judapies/Mufla/2021/Mufla 4.5L Psoc MYC Lab #004588559 OP202145/Modelo/EnsambleAislante.png

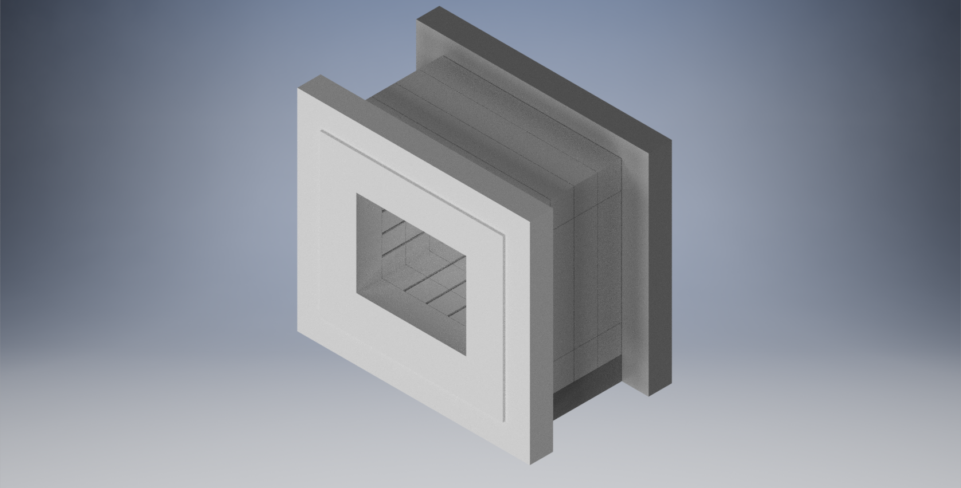
2021/Mufla 4.5L Psoc MYC Lab #004588559 OP202145/Modelo/EnsambleAislante.png
