judapies/Mufla/2020/Mufla 14L Psoc Avantika #004588425 OP2020341/Firmware Psoc V/LCD2/ComponentUpdateLog.txt

Last Modified Date & Time: 11/09/2020 09:13:33

MuflaGLCD: MuflaGLCD.cydwr
	cy_boot [v5.60] to [v6.0]
	LIN_Dynamic [v4.0] to [v5.0]
