judapies/Mufla/2018/Mufla 14L Artilab #004587922/SGC/FJP- 53 RECEPCION E INSPECCION DE PCB.docx

Fecha: | Referencia: | Modelo: | Orden de Pedido:

DESCRIPCIÓN DE LA MEDICIÓN | VALOR ESPERADO | VALOR OBTENIDO | OBSERVACIONES
Largo de PCB
Ancho de PCB
Numero de Capas | 2
*Medición entre pines de Display | Infinito
Medición entre VCC y GND | Infinito
Pin 4 J2 (VF) y Pin 2 U1 | 0 Ω
Pin 2 J10 y Pin 15 U1 | 0 Ω
Pin 2 U3 y Pin 17 U1 | 0 Ω
Pin 2 U2 y Pin 18 U1 | 0 Ω
Pin 1 J12 y Pin 2 J12 | Infinito
Inspección Visual general de la PCB | N/A | N/A

OBSERVACIONES:_________________________________________________________________________________________________________________________________________________________________________________________________________________________________________________________________________________________

- Recuerde realizar las mediciones de acuerdo a la escala de la medida.
- Si fue necesario alguna corrección menciónela en la sección de observaciones y registre los valores medidos separados por un guion (-).

*Realizar la medición entre el pin 1 con todos los demás pines, de igual forma con los siguientes pines.

Realizo: | Revisó: | Aprobó:
Firma: | Firma: | Firma:
Cargo: | Cargo: | Cargo: Dirección Técnica
--------------------------------------------------- | ---------------------------------------------------- | Estado de Calidad: Aprobado:_____ Rechazado:_____

JP BIOINGENIERIA S.A.S RECEPCIÓN E INSPECCIÓN DE PCB(BARE BOARD TEST) FJP – 53 Versión 01 Efectivo a partir de: Marzo 31 de 2018
