judapies/Mufla/2019/Horno Tubular #004587931/SGC/FJP- 53 RECEPCION E INSPECCION DE PCB.docx

Fecha: | Referencia: | Modelo: 2019 | Orden de Pedido: 2018284

DESCRIPCIÓN DE LA MEDICIÓN | VALOR ESPERADO | VALOR OBTENIDO | OBSERVACIONES
Largo de PCB
Ancho de PCB
Numero de Capas | 2
*Medición entre pines de Display | Infinito
Medición entre VCC y GND | Infinito
Pin 1 J2 y Pin 20 J2 | 0 Ω
Pin 3 U3 y Pin 12 U2 | 0 Ω
Pin 2 U3 y Pin 11 U2 | 0 Ω
Pin 3 J7 y Pin 4 J7 | 0 Ω
Pin 1 J7 y Pin 2 J7 | Infinito
Inspección Visual general de la PCB | N/A | N/A

OBSERVACIONES:_________________________________________________________________________________________________________________________________________________________________________________________________________________________________________________________________________________________

- Recuerde realizar las mediciones de acuerdo a la escala de la medida.
- Si fue necesario alguna corrección menciónela en la sección de observaciones y registre los valores medidos separados por un guion (-).

*Realizar la medición entre el pin 1 con todos los demás pines, de igual forma con los siguientes pines.

Realizo: | Revisó: | Aprobó:
Firma: | Firma: | Firma:
Cargo: | Cargo: | Cargo: Dirección Técnica
--------------------------------------------------- | ---------------------------------------------------- | Estado de Calidad: Aprobado:_____ Rechazado:_____

JP BIOINGENIERIA S.A.S RECEPCIÓN E INSPECCIÓN DE PCB(BARE BOARD TEST) FJP – 53 Versión 01 Efectivo a partir de: Marzo 31 de 2018
