judapies/Mufla/2019/Mufla 16L Avantika #004588073 OP2019142/SGC/FJP- 53 RECEPCION E INSPECCION DE PCB.docx

Fecha: | Referencia: JPMN16 | Modelo: 2019 | Orden de Pedido: 2019142

DESCRIPCIÓN DE LA MEDICIÓN | VALOR ESPERADO | VALOR OBTENIDO | OBSERVACIONES
Largo de PCB | 116mm
Ancho de PCB | 75mm
Numero de Capas | 2
*Medición entre pines de Display | Infinito
Medición entre VCC y GND | Infinito
Pin 1 J2 y Pin 20 J2 | 0 Ω
Pin 3 U2 y Pin 12 U2 | Infinito
Pin 2 U2 y Pin 11 U2 | Infinito
Pin 5 J3 y Pin 6 J3 | 0 Ω
Pin 6 J3 y Pin 8 J3 | 0 Ω
Inspección Visual general de la PCB | N/A | N/A

OBSERVACIONES:_________________________________________________________________________________________________________________________________________________________________________________________________________________________________________________________________________________________

- Recuerde realizar las mediciones de acuerdo a la escala de la medida.
- Si fue necesario alguna corrección menciónela en la sección de observaciones y registre los valores medidos separados por un guion (-).

*Realizar la medición entre el pin 1 con todos los demás pines, de igual forma con los siguientes pines.

Realizo: | Revisó: | Aprobó:
Firma: | Firma: | Firma:
Cargo: | Cargo: | Cargo: Dirección Técnica
--------------------------------------------------- | ---------------------------------------------------- | Estado de Calidad: Aprobado:_____ Rechazado:_____

JP BIOINGENIERIA S.A.S RECEPCIÓN E INSPECCIÓN DE PCB(BARE BOARD TEST) FJP – 53 Versión 01 Efectivo a partir de: Marzo 31 de 2018
