judapies/Mufla/2021/Mufla 3L Psoc Artilab #0045886XX OP2021128/Modelo/PiezaPuerta-2.pdf

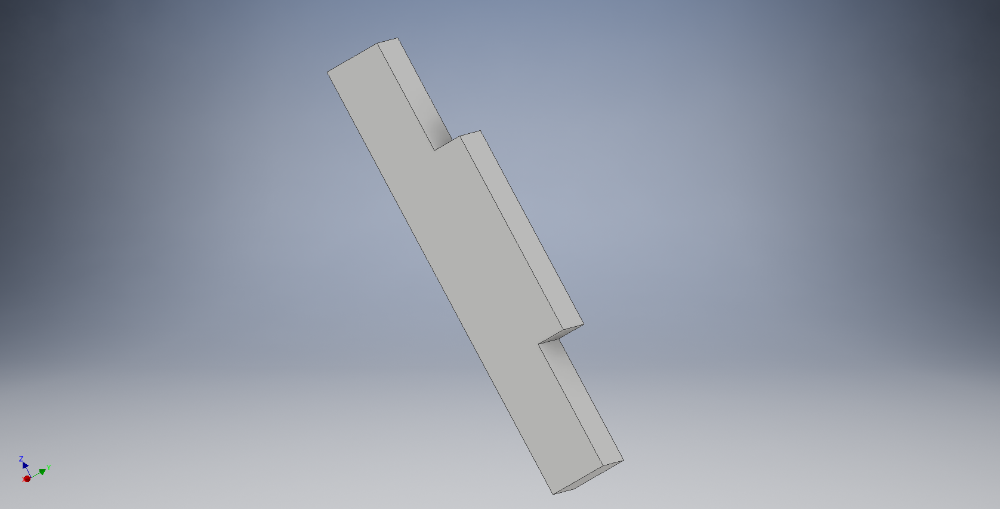
[picture p2: page 1]
