judapies/Mufla/2021/Mufla 3L Psoc Artilab #0045886XX OP2021128/KanthalA1.png

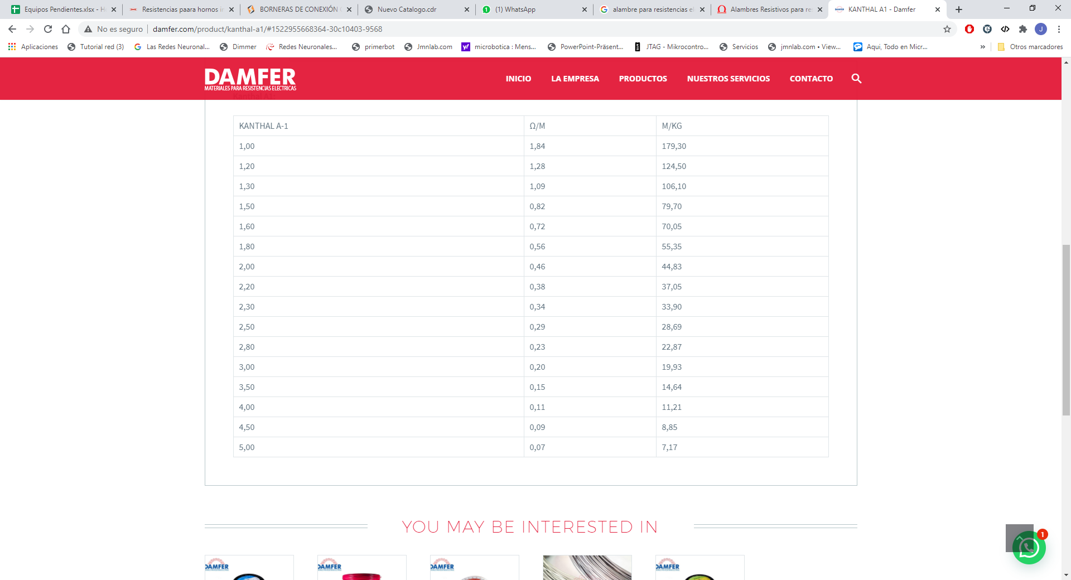
2021/Mufla 3L Psoc Artilab #0045886XX OP2021128/KanthalA1.png
