judapies/Mufla/2021/Mufla 3L Psoc Artilab #0045886XX OP2021128/Parametros/WhatsApp Image 2021-04-19 at 7.22.25 AM.jpeg

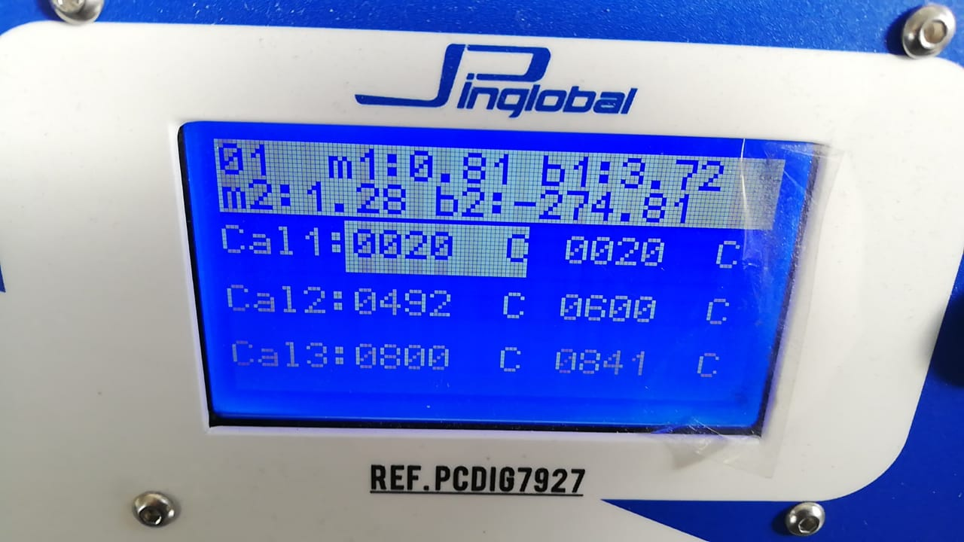
2021/Mufla 3L Psoc Artilab #0045886XX OP2021128/Parametros/WhatsApp Image 2021-04-19 at 7.22.25 AM.jpeg
