judapies/Mufla/2018/Mufla 14L Artilab #004587922/Materiales/Listado de Componentes Mufla.xlsx

Sheet: Parte Electronica 110V
Mufla
Descripción | Referencia | Cantidad | Sitio de Compra | Dirección | Precio | Precio Total
Borneras | 2 Pines Verdes | 7 | Sanyvi Electronics | Cra 9 # 19-30 LOC:212 | $350 | $2450
Conectores GP (con uñas) | 8 Pines | 1 | Sanyvi Electronics | Cra 9 # 19-30 LOC:212 | $400 | $400
 | 4 Pines | 2 | Sanyvi Electronics | Cra 9 # 19-30 LOC:212 | $200 | $400
 | 16 Pines | 2
Regleta Hembra | Para Regleta Macho | 2
Disipador con pines para soldar | Alto para 7805 | 1 | Sanyvi Electronics | Cra 9 # 19-30 LOC:212 | $2000 | $2000
Puente Rectificador | Redondo 1A | 1 | Sanyvi Electronics | Cra 9 # 19-30 LOC:212 | $400 | $400
Regulador de Voltaje | LM7805 | 2 | Sanyvi Electronics | Cra 9 # 19-30 LOC:212 | $550 | $1100
Cristal de Cuarzo | 20MHz | 1 | Sanyvi Electronics | Cra 9 # 19-30 LOC:212 | $450 | $450
Resistencias 1/4W | 10K | 20 | Sanyvi Electronics | Cra 9 # 19-30 LOC:212 | $10 | $200
 | 1K | 20 | Sanyvi Electronics | Cra 9 # 19-30 LOC:212 | $10 | $200
 | 330R | 20 | Sanyvi Electronics | Cra 9 # 19-30 LOC:212 | $10 | $200
Condensador | 470uF/25V | 1 | Sanyvi Electronics | Cra 9 # 19-30 LOC:212 | $250 | $250
 | 10uF/16V | 2 | Sanyvi Electronics | Cra 9 # 19-30 LOC:212 | $150 | $300
 | 0.1uF Monolitico | 2 | Sanyvi Electronics | Cra 9 # 19-30 LOC:212 | $100 | $200
 | 15pF | 2 | Sanyvi Electronics | Cra 9 # 19-30 LOC:212 | $100 | $200
 | 0.1uF Tantalio superficial (CT1206 0.1UF35) | 5 | Sigma Electronica Ltda | Av. Cra 24 No 61D-65 | $406 | $2030
Microcontrolador | PIC 18F4685 | 1 | Sanyvi Electronics | Cra 9 # 19-30 LOC:212 | $15000 | $15000
Regleta Profesional | 40 pines | 2 | Sanyvi Electronics | Cra 9 # 19-30 LOC:212 | $1200 | $2400
Poste plastico | Para sujecion de tarjeta | 4 | Sanyvi Electronics | Cra 9 # 19-30 LOC:212 | $150 | $600
Transistor | 2N3904 | 2 | Sanyvi Electronics | Cra 9 # 19-30 LOC:212 | $200 | $400
Diodo | 1N4004 | 2 | Sanyvi Electronics | Cra 9 # 19-30 LOC:212 | $200 | $400
Zenner | 3,3V | 3
Led | 5mm rojo | 1 | Sanyvi Electronics | Cra 9 # 19-30 LOC:212 | $500 | $500
Fuente Conmutada | RS-15-12, 12V -1,3A | 1 | Sigma Electronica Ltda | Av. Cra 24 No 61D-65

Sheet: Parte Electrica 110V
Cabina Bioseguridad 2B
Descripción | Referencia | Cantidad
Breaker CHINT un polo. 4A | 09606 | 1
Breaker CHINT un polo. 10A | 09610 | 2
Contactor | 00905 | 1
 | 00919 | 1
Cable Encauchetado Centelsa | 3X12 | 5
 | 2X12 | 3
 | 2X18 | 4
Buzzer 110V | 17572 | 1
Riel omega |  | 1
Prensacable PG13.5 | 34113 | 6
Prensacable PG16 | 34116 | 2
Cable Blindado | 6 Hilos X 18AWG | 2
 | 18 Hilos X 18AWG | 2
Termoencogible | 2mm Negro | 2
Regleta Polietileno | 36003 | 1
 | 36030 | 1
Caja de paso | K3131-114 | 1
Clavija Leviton Amarilla | 115V - 15A | 1
Terminal Tipo Bala Hembra | 34636 | 1 bolsa(100)
Terminal Tipo Bala Macho | 34630 | 1 bolsa(100)

Sheet: Hoja1
 | Cabina Flujo Vertical 220V
 | Descripción | Referencia | Cantidad
 | OptoTriac | MOC3021 | 6
 | Triac | BT137 | 2
 |  | BTA-16 | 4
 | Borneras | 2 Pines Verdes | 7
 |  | 3 Pines Verde | 1
 | Conectores GP (con uñas) | 5 Pines | 1
 |  | 16 Pines | 2
 | Puente Rectificador | Redondo 1A | 1
 | Regulador de Voltaje | LM7805 | 1
 | Reostato | 10K | 1
 | Cristal de Cuarzo | 4MHz | 1
 | Resistencias 1/4W | 10K | 6
 |  | 1K | 6
 |  | 330R | 6
 | Condensador | 470uF/25V | 1
 |  | 10uF/16V | 3
 |  | 100nF (104) | 2
 |  | 22pF | 2
 | Display | 4X20 | 1
 | Microcontrolador | PIC 18F4550 | 1
 | Terminales | Según muestra | 8
 | Breaker CHINT 2 polos | 2A | 1
 | Breaker CHINT 1 polo | 10A | 1
 | Interruptor de balancin redondo | 20mm | 1
 | Toma doble blanca | Leviton | 1
 | Tapa de seguridad para toma doble | Plastica gris | 1
 | Regleta de polietileno | 15A | 1
 | Prensacable | PG11 | 4
 | Cable Encauchetado Conalcables | 4X12 | 3m
Ingenieros | Faiver H. Trujillo G | Juan David Piñeros E | 2014- Abr-15
