judapies/Mufla/2018/Mufla 14L Artilab #004587922/SGC/FJP- 35  REQUISICION DE MATERIALES MUFLA.xlsx

JP BIOINGENIERIA S.A.S |  |  | REQUISICION DE MATERIALES |  |  |  |  |  |  |  | FJP - 35
 |  |  |  |  |  |  |  |  |  |  | Version 01
Efectivo a partir de: 20 Dic 2017 |  |  |  |  |  | Documento de origen: DJP- 24 |  |  |  |  | Pág. 1 de 1
FECHA
PRODUCTO: | Mufla 220V 14L |  |  |  |  |  |  | Orden de Pedido No.
 |  |  |  |  |  |  |  | Visita Técnica:
DESCRIPCION |  |  |  |  |  | Referencia |  |  | CANTIDAD REQUERIDA
Tarjeta de control |  |  |  |  |  | DIELEC-MR001 |  |  | 1
Resistencias (1/4W) |  |  |  |  |  | 100Ω |  |  | 2
Resistencias (1/4W) |  |  |  |  |  | 10K |  |  | 7
Resistencias (1/4W) |  |  |  |  |  | 1K | 1K | 1K | 2 | 10 | 10 | 10
Resistencias (1/4W) |  |  |  |  |  | 240Ω |  |  | 2
Condensador Ceramico | Condensadores | Condensadores | Condensadores | Condensadores | Condensadores | 22pF | 22 pF Ceramico | 22 pF Ceramico | 2 | 4 | 4 | 4
Condensador Electrolitico | Condensadores | Condensadores | Condensadores | Condensadores | Condensadores | 470 µF @ 25V | 470 µF @ 16V | 470 µF @ 16V | 1 | 2 | 2 | 2
Condensador Electrolitico | Condensadores | Condensadores | Condensadores | Condensadores | Condensadores | 10 µF @ 25V | 10 µF @ 16V | 10 µF @ 16V | 2
Condensador de tantalio SMD | Condensadores | Condensadores | Condensadores | Condensadores | Condensadores | 0,1uF | 10 µF @ 16V | 10 µF @ 16V | 6
Cristal de Quarzo | Cristal | Cristal | Cristal | Cristal | Cristal | 20MHz | 4MHz | 4MHz | 1
Conector GP (Con uñas) | Conector GP (Con uñas) | Conector GP (Con uñas) | Conector GP (Con uñas) | Conector GP (Con uñas) | Conector GP (Con uñas) | 8P | 2P | 2P | 1
Conector GP (Con uñas) | Conector GP (Con uñas) | Conector GP (Con uñas) | Conector GP (Con uñas) | Conector GP (Con uñas) | Conector GP (Con uñas) | 4P | 5P | 5P | 2
Conector GP (Con uñas) | Conector GP (Con uñas) | Conector GP (Con uñas) | Conector GP (Con uñas) | Conector GP (Con uñas) | Conector GP (Con uñas) | 16P | 5P | 5P | 2
Display Grafico Azul | Conector GP (Con uñas) | Conector GP (Con uñas) | Conector GP (Con uñas) | Conector GP (Con uñas) | Conector GP (Con uñas) | 128X64px | 5P | 5P | 1
Regleta profesional | Regleta profesional | Regleta profesional | Regleta profesional | Regleta profesional | Regleta profesional | 1X40 | 1X40 | 1X40 | 1
Regulador 5V | Regulador 5V | Regulador 5V | Regulador 5V | Regulador 5V | Regulador 5V | LM7805 | LM 7805 | LM 7805 | 1
Transistor | Transistor | Transistor | Transistor | Transistor | Transistor | 2N3904 | 2N3904 | 2N3904 | 1 | 2 | 2 | 2
Buzzer | Transistor | Transistor | Transistor | Transistor | Transistor | Redondo-5V | 2N3904 | 2N3904 | 1 | 2 | 2 | 2
Borneras | Bornera | Bornera | Bornera | Bornera | Bornera | 2 pines Verde | 2 pines Verde | 2 pines Verde | 7 | 2 | 2 | 2
Borneras | Bornera | Bornera | Bornera | Bornera | Bornera | 3 pines Verde | 2 pines Verde | 2 pines Verde | 7 | 2 | 2 | 2
Disipador |  |  |  |  |  | Mediano |  |  | 1
Diodo |  |  |  |  |  | 1N4004 |  |  | 2
Microcontrolador | Microcontrolador | Microcontrolador | Microcontrolador | Microcontrolador | Microcontrolador | PIC 18F4685 | PIC 18F4550 | PIC 18F4550 | 1 | 2 | 2 | 2
Reostato | Microcontrolador | Microcontrolador | Microcontrolador | Microcontrolador | Microcontrolador | 10K 3 pines | PIC 18F4550 | PIC 18F4550 | 1 | 2 | 2 | 2
Puente Rectificador |  |  |  |  |  | Redondo 1.5A |  |  | 1
Transmisor de Temperatura |  |  |  |  |  | TXBLOCK TK0-1200°C |  |  | 1
Poste Plastico |  |  |  |  |  | Para sujecion de PCB |  |  | 4
Botones |  |  |  |  |  | Tipo Huevo |  |  | 4
Switch ON-OFF |  |  |  |  |  | Redondo |  |  | 1
Fuente Conmutada |  |  |  |  |  | RS-15-12 |  |  | 1
Fuente Conmutada |  |  |  |  |  | 24V- 3A Plug |  |  | 1
Breaker CHINT dos Polos 2A |  |  |  |  |  | 09630 |  |  | 1
Rele de estado solido Unipolar 40A |  |  |  |  |  | 46908-1 |  |  | 1
Disipador para Rele de Estado Solido |  |  |  |  |  | 46956 |  |  | 1
Portafusible montaje en riel DIN |  |  |  |  |  | 36900 |  |  | 2
Fusible Accionamiento Rapido |  |  |  |  |  | 36894 |  |  | 2
Ventilador Axial |  |  |  |  |  | 33507 |  |  | 6
Riel |  |  |  |  |  | Omega
Canaleta Ranurada |  |  |  |  |  | 25mmX40mm
Pasacable |  |  |  |  |  | PG11
Pasacable |  |  |  |  |  | PG13,5
Terminal |  |  |  |  |  | Tipo Bala hembra (roja)
Terminal |  |  |  |  |  | Tipo Bala Macho(roja)
Terminal |  |  |  |  |  | Tipo Bala hembra (Azul)
Terminal |  |  |  |  |  | Tipo Bala Macho (Azul)
Terminal |  |  |  |  |  | Tipo ojo (Amarilla)
Bornera plastica |  |  |  |  |  | 15A
Cable
Cable
Cable
Cable
Cable
Cable
Cable
Cable
SOLICITADO POR: |  |  |  | ENTREGADO POR: |  |  |  | RECIBIDO POR:
