judapies/Mufla/2019/Horno Tubular #004587931/SGC/FJP- 35  REQUISICION DE MATERIALES HORNO TUBULAR.xlsx

JP BIOINGENIERIA S.A.S |  |  | REQUISICION DE MATERIALES |  |  |  |  |  |  |  | FJP - 35
 |  |  |  |  |  |  |  |  |  |  | Version 01
Efectivo a partir de: 20 Dic 2017 |  |  |  |  |  | Documento de origen: DJP- 24 |  |  |  |  | Pág. 1 de 1
FECHA | 21 | 1 | 2019
PRODUCTO: | Horno Tubular 220VAC 2F, 5000W |  |  |  |  |  |  | Orden de Pedido No. |  |  | 2018284
 |  |  |  |  |  |  |  | Visita Técnica:
DESCRIPCION |  |  |  |  |  | Referencia |  |  | CANTIDAD REQUERIDA
Tarjeta de control |  |  |  |  |  | DIELEC-MR001 |  |  | 3
Resistencias (1/4W) |  |  |  |  |  | 100Ω |  |  | 6
Resistencias (1/4W) |  |  |  |  |  | 10K |  |  | 21
Resistencias (1/4W) |  |  |  |  |  | 1K | 1K | 1K | 6 | 10 | 10 | 10
Resistencias (1/4W) |  |  |  |  |  | 240Ω |  |  | 6
Condensador Ceramico | Condensadores | Condensadores | Condensadores | Condensadores | Condensadores | 22pF | 22 pF Ceramico | 22 pF Ceramico | 6 | 4 | 4 | 4
Condensador Electrolitico | Condensadores | Condensadores | Condensadores | Condensadores | Condensadores | 470 µF @ 25V | 470 µF @ 16V | 470 µF @ 16V | 3 | 2 | 2 | 2
Condensador Electrolitico | Condensadores | Condensadores | Condensadores | Condensadores | Condensadores | 10 µF @ 25V | 10 µF @ 16V | 10 µF @ 16V | 6
Condensador de tantalio SMD | Condensadores | Condensadores | Condensadores | Condensadores | Condensadores | 0,1uF | 10 µF @ 16V | 10 µF @ 16V | 18
Cristal de Quarzo | Cristal | Cristal | Cristal | Cristal | Cristal | 20MHz | 4MHz | 4MHz | 3
Conector GP (Con uñas) | Conector GP (Con uñas) | Conector GP (Con uñas) | Conector GP (Con uñas) | Conector GP (Con uñas) | Conector GP (Con uñas) | 8P | 2P | 2P | 3
Conector GP (Con uñas) | Conector GP (Con uñas) | Conector GP (Con uñas) | Conector GP (Con uñas) | Conector GP (Con uñas) | Conector GP (Con uñas) | 4P | 5P | 5P | 6
Conector GP (Con uñas) | Conector GP (Con uñas) | Conector GP (Con uñas) | Conector GP (Con uñas) | Conector GP (Con uñas) | Conector GP (Con uñas) | 16P | 5P | 5P | 6
Display Grafico Azul | Conector GP (Con uñas) | Conector GP (Con uñas) | Conector GP (Con uñas) | Conector GP (Con uñas) | Conector GP (Con uñas) | 128X64px | 5P | 5P | 3
Regleta profesional | Regleta profesional | Regleta profesional | Regleta profesional | Regleta profesional | Regleta profesional | 1X40 | 1X40 | 1X40 | 3
Regulador 5V | Regulador 5V | Regulador 5V | Regulador 5V | Regulador 5V | Regulador 5V | LM7805 | LM 7805 | LM 7805 | 3
Transistor | Transistor | Transistor | Transistor | Transistor | Transistor | 2N3904 | 2N3904 | 2N3904 | 3 | 2 | 2 | 2
Buzzer | Transistor | Transistor | Transistor | Transistor | Transistor | Redondo-5V | 2N3904 | 2N3904 | 3 | 2 | 2 | 2
Borneras | Bornera | Bornera | Bornera | Bornera | Bornera | 2 pines Verde | 2 pines Verde | 2 pines Verde | 21 | 2 | 2 | 2
Borneras | Bornera | Bornera | Bornera | Bornera | Bornera | 3 pines Verde | 2 pines Verde | 2 pines Verde | 21 | 2 | 2 | 2
Disipador |  |  |  |  |  | Mediano |  |  | 3
Diodo |  |  |  |  |  | 1N4004 |  |  | 6
Microcontrolador | Microcontrolador | Microcontrolador | Microcontrolador | Microcontrolador | Microcontrolador | PIC 18F4685 | PIC 18F4550 | PIC 18F4550 | 3 | 2 | 2 | 2
Reostato | Microcontrolador | Microcontrolador | Microcontrolador | Microcontrolador | Microcontrolador | 10K 3 pines | PIC 18F4550 | PIC 18F4550 | 3 | 2 | 2 | 2
Puente Rectificador |  |  |  |  |  | Redondo 1.5A |  |  | 3
Transmisor de Temperatura |  |  |  |  |  | TXBLOCK TK0-1250°C |  |  | 3
Poste Plastico |  |  |  |  |  | Para sujecion de PCB |  |  | 12
Botones |  |  |  |  |  | Tipo Huevo |  |  | 12
Switch ON-OFF |  |  |  |  |  | Redondo |  |  | 3
Fuente Conmutada |  |  |  |  |  | RS-15-12 |  |  | 3
Fuente Conmutada |  |  |  |  |  | 24V- 3A Plug |  |  | 3
Breaker CHINT dos Polos 2A |  |  |  |  |  | 09630 |  |  | 3
Rele de estado solido Unipolar 40A |  |  |  |  |  | 46908-1 |  |  | 3
Disipador para Rele de Estado Solido |  |  |  |  |  | 46956 |  |  | 3
Portafusible montaje en riel DIN |  |  |  |  |  | 36900 |  |  | 6
Fusible Accionamiento Rapido |  |  |  |  |  | 36896 |  |  | 6
Ventilador Axial |  |  |  |  |  | 33507
Riel |  |  |  |  |  | Omega
Canaleta Ranurada |  |  |  |  |  | 25mmX40mm
Pasacable |  |  |  |  |  | PG11
Pasacable |  |  |  |  |  | PG13,5
Terminal |  |  |  |  |  | Tipo Bala hembra (roja)
Terminal |  |  |  |  |  | Tipo Bala Macho(roja)
Terminal |  |  |  |  |  | Tipo Bala hembra (Azul)
Terminal |  |  |  |  |  | Tipo Bala Macho (Azul)
Terminal |  |  |  |  |  | Tipo ojo (Amarilla)
Bornera plastica |  |  |  |  |  | 15A
Cable
Cable
Cable
Cable
Cable
Cable
Cable
Cable
SOLICITADO POR: |  |  |  | ENTREGADO POR: |  |  |  | RECIBIDO POR:
