judapies/Mufla/2020/Mufla 14L Avantika #004588239 OP2020144/SGC/FJP- 35  REQUISICION DE MATERIALES MUFLA.xlsx

JP BIOINGENIERIA S.A.S |  |  | REQUISICION DE MATERIALES |  |  |  |  |  |  |  | FJP - 35
 |  |  |  |  |  |  |  |  |  |  | Version 01
Efectivo a partir de: 20 Dic 2017 |  |  |  |  |  | Documento de origen: DJP- 24 |  |  |  |  | Pág. 1 de 1
FECHA | 6 | 7 | 2020
PRODUCTO: | Mufla 14L 220V |  |  |  |  |  |  | Orden de Pedido No. |  |  | 2020144
 |  |  |  |  |  |  |  | Visita Técnica:
DESCRIPCION |  |  |  |  |  | Referencia |  |  | CANTIDAD REQUERIDA
Tarjeta de control |  |  |  |  |  | MUFLA RAMPA 2020 |  |  | 1
Resistencias Montaje superficial 0805 |  |  |  |  |  | 100Ω |  |  | 1
Resistencias Montaje superficial 0805 |  |  |  |  |  | 10K |  |  | 7
Resistencias Montaje superficial 0805 |  |  |  |  |  | 1K | 1K | 1K | 2 | 10 | 10 | 10
Resistencias (1/4W) |  |  |  |  |  | 240Ω |  |  | 2
Condensador Ceramico | Condensadores | Condensadores | Condensadores | Condensadores | Condensadores | 22pF | 22 pF Ceramico | 22 pF Ceramico | 2 | 4 | 4 | 4
Condensador de tantalio SMD | Condensadores | Condensadores | Condensadores | Condensadores | Condensadores | 0,1uF | 10 µF @ 16V | 10 µF @ 16V | 6
Rele de estado solido | Condensadores | Condensadores | Condensadores | Condensadores | Condensadores | G3MB-202P | 10 µF @ 16V | 10 µF @ 16V | 2
Cristal de Quarzo | Cristal | Cristal | Cristal | Cristal | Cristal | 20MHz | 4MHz | 4MHz | 1
Conector GP (Con uñas) | Conector GP (Con uñas) | Conector GP (Con uñas) | Conector GP (Con uñas) | Conector GP (Con uñas) | Conector GP (Con uñas) | 8P | 2P | 2P | 1
Conector GP (Con uñas) | Conector GP (Con uñas) | Conector GP (Con uñas) | Conector GP (Con uñas) | Conector GP (Con uñas) | Conector GP (Con uñas) | 4P | 2P | 2P | 2
Conector GP (Con uñas) | Conector GP (Con uñas) | Conector GP (Con uñas) | Conector GP (Con uñas) | Conector GP (Con uñas) | Conector GP (Con uñas) | 3P | 2P | 2P | 0
Sensor de temperatura | Conector GP (Con uñas) | Conector GP (Con uñas) | Conector GP (Con uñas) | Conector GP (Con uñas) | Conector GP (Con uñas) | LM35 | 2P | 2P | 1
Regleta Macho | Conector GP (Con uñas) | Conector GP (Con uñas) | Conector GP (Con uñas) | Conector GP (Con uñas) | Conector GP (Con uñas) | 1X40 | 5P | 5P | 1
Regleta Hembra | Conector GP (Con uñas) | Conector GP (Con uñas) | Conector GP (Con uñas) | Conector GP (Con uñas) | Conector GP (Con uñas) | 1X40 | 5P | 5P | 1
Display Grafico Azul | Conector GP (Con uñas) | Conector GP (Con uñas) | Conector GP (Con uñas) | Conector GP (Con uñas) | Conector GP (Con uñas) | 128X64px | 5P | 5P | 1
Regleta profesional | Regleta profesional | Regleta profesional | Regleta profesional | Regleta profesional | Regleta profesional | 1X40 | 1X40 | 1X40 | 1
Transistor Montaje Superficial SOT-23 | Transistor | Transistor | Transistor | Transistor | Transistor | MBT2222A | 2N3904 | 2N3904 | 1 | 2 | 2 | 2
Buzzer | Transistor | Transistor | Transistor | Transistor | Transistor | Redondo-5V | 2N3904 | 2N3904 | 1 | 2 | 2 | 2
Borneras | Bornera | Bornera | Bornera | Bornera | Bornera | 2 pines Verde | 2 pines Verde | 2 pines Verde | 8 | 2 | 2 | 2
Borneras | Bornera | Bornera | Bornera | Bornera | Bornera | 3 pines Verde | 2 pines Verde | 2 pines Verde | 1 | 2 | 2 | 2
Diodo Montaje Superficial |  |  |  |  |  | FM4004 |  |  | 1
Microcontrolador | Microcontrolador | Microcontrolador | Microcontrolador | Microcontrolador | Microcontrolador | PIC 18F4685 | PIC 18F4550 | PIC 18F4550 | 1 | 2 | 2 | 2
Reostato | Microcontrolador | Microcontrolador | Microcontrolador | Microcontrolador | Microcontrolador | 10K 3 pines | PIC 18F4550 | PIC 18F4550 | 1 | 2 | 2 | 2
Fuente Conmutada Para Impreso |  |  |  |  |  | HLKPM01 |  |  | 1
Transmisor de Temperatura |  |  |  |  |  | TXBLOCK TK0-1250°C |  |  | 1
Botones |  |  |  |  |  | Tipo Huevo |  |  | 4
Switch ON-OFF |  |  |  |  |  | Redondo |  |  | 1
Convertidor Elevador DC-DC |  |  |  |  |  | MT3608 |  |  | 1
Breaker CHINT dos Polos 4A |  |  |  |  |  | 09632 |  |  | 1
Contactor 25A 220V |  |  |  |  |  | 04036 |  |  | 1
Rele de estado solido Unipolar 25A |  |  |  |  |  | 46906-1 |  |  | 1
Disipador para Rele de Estado Solido |  |  |  |  |  | 46956 |  |  | 1
Portafusible montaje en riel DIN |  |  |  |  |  | 36900 |  |  | 2
Fusible Accionamiento Rapido 25A |  |  |  |  |  | 36896 |  |  | 2
Ventilador Axial |  |  |  |  |  | 33507 |  |  | 6
Toma Industrial de Incrustar |  |  |  |  |  | L6-30R |  |  | 1
Clavija Industrial |  |  |  |  |  | L6-30P |  |  | 1
Impresora Termica |  |  |  |  |  | ADAFRUIT 597 |  |  | 0
Riel |  |  |  |  |  | Omega |  |  | 10cm
Canaleta Ranurada |  |  |  |  |  | 25mmX40mm |  |  | 1m
Pasacable |  |  |  |  |  | PG11
Pasacable |  |  |  |  |  | PG13,5
Terminal |  |  |  |  |  | Tipo Bala hembra (roja)
Terminal |  |  |  |  |  | Tipo Bala Macho(roja)
Terminal |  |  |  |  |  | Tipo Bala hembra (Azul)
Terminal |  |  |  |  |  | Tipo Bala Macho (Azul)
Terminal |  |  |  |  |  | Tipo ojo (Amarilla)
Bornera plastica |  |  |  |  |  | 15A
Cable |  |  |  |  |  | 3X10 |  |  | 3,5m
Cable |  |  |  |  |  | 2X18 |  |  | 80cm
Cable
Cable
Cable
Cable
Cable
Cable
SOLICITADO POR: |  |  |  | ENTREGADO POR: |  |  |  | RECIBIDO POR:
