judapies/Mufla/2018/Mufla 14L Artilab #004587922/SGC/FJP- 32 SOLICITUD DE COMPRA.xlsx

JP BIOINGENIERIA S.A.S |  | SOLICITUD DE COMPRA |  | FJP - 32
 |  |  |  | Version 01
Efectivo a partir de: 03-Marzo-2017 |  |  | Documento de origen: DJP- 08 | Pág. 1 de 1
FECHA: |  |  | Área Solicitante:
Proyecto u Orden de Pedido:
CANTIDAD | DESCRIPCION |  |  | Proveedor Sugerido | CHK
5 | BTA16-600 |  |  | San&Vielectronics
3 | Fusible Corto 250V/2.5A |  |  | San&Vielectronics
3 | Fusible Corto 250V/3A |  |  | San&Vielectronics
6 | Portafusible para impreso con tapa, fusible corto |  |  | San&Vielectronics
5m | Termoencogible negro de 2mm |  |  | San&Vielectronics
5m | Termoencogible negro de 3mm |  |  | San&Vielectronics
5m | Termoencogible negro de 4mm |  |  | San&Vielectronics
1 | SSR Unipolar Cruce por Cero Carga Resistiva 46904-1 |  |  | Multielectricos del Centro
10m | Cable Encauchetado 3X18AWG |  |  | Multielectricos del Centro
5 | Prensacable plastico PG-11 ONKA9002 |  |  | Multielectricos del Centro
5 | Prensacable plastico PG-13,5 ONKA9003 |  |  | Multielectricos del Centro
1 | PCB CabinaBioseguridad |  |  | Yahiko Electronica
Elaborado por: |  |  | Aprobado por Compras:
