judapies/Mufla/2021/Mufla 3L Psoc Artilab #0045886XX OP2021128/Modelo/EnsambleAislante.stp

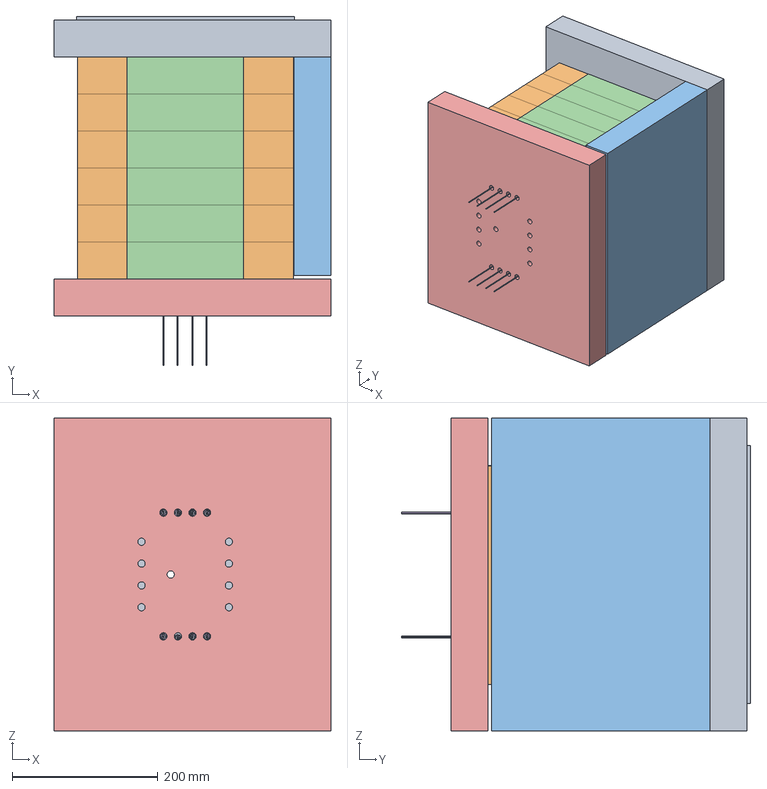
[picture p5: CAD file, 2021-07-30]
2021/Mufla 3L Psoc Artilab #0045886XX OP2021128/Modelo/EnsambleAislante.stp
380.0 x 479.6 x 430.0 mm
TapaFrontal
PiezaInferior x 12
Piso
Lateral x 12
Trasera
Resistencia3 x 4
