judapies/Mufla/2021/Mufla 9L Psoc Artilab #004588512 OP202139/Modelo/ENSAMBLE CUERPO PUERTA M 2020-9.5L.STEP

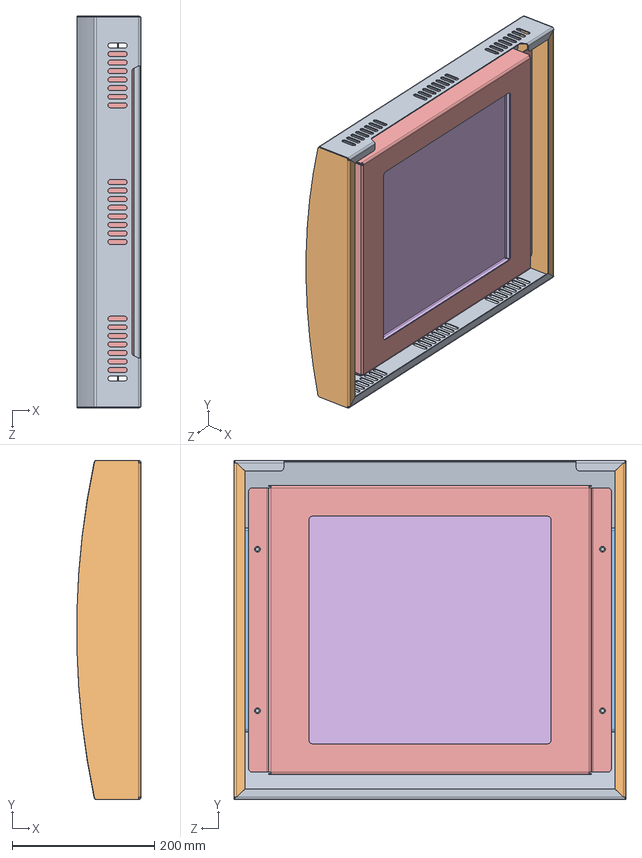
[picture p6: CAD file, 2021-07-30]
2021/Mufla 9L Psoc Artilab #004588512 OP202139/Modelo/ENSAMBLE CUERPO PUERTA M 2020-9.5L.STEP
90.2 x 477.0 x 551.0 mm
FRONTAL PUERTA M 2020-9.5L
LATERAL PUERTA M 2020-9.5L x 2
SOPORTE INTERIOR CONTRATAPA M 2020-9.5L x 2
CONTRATAPA EXTERIOR M 2020-9.5L_PredeterminadoSM-CHAPA-DESPLEGADA
CONTRATAPA INTERIOR M 2020-9.5L_PredeterminadoSM-CHAPA-DESPLEGADA
