judapies/Mufla/2018/Mufla 14L Artilab #004587922/Schematic/Mufla.DXF

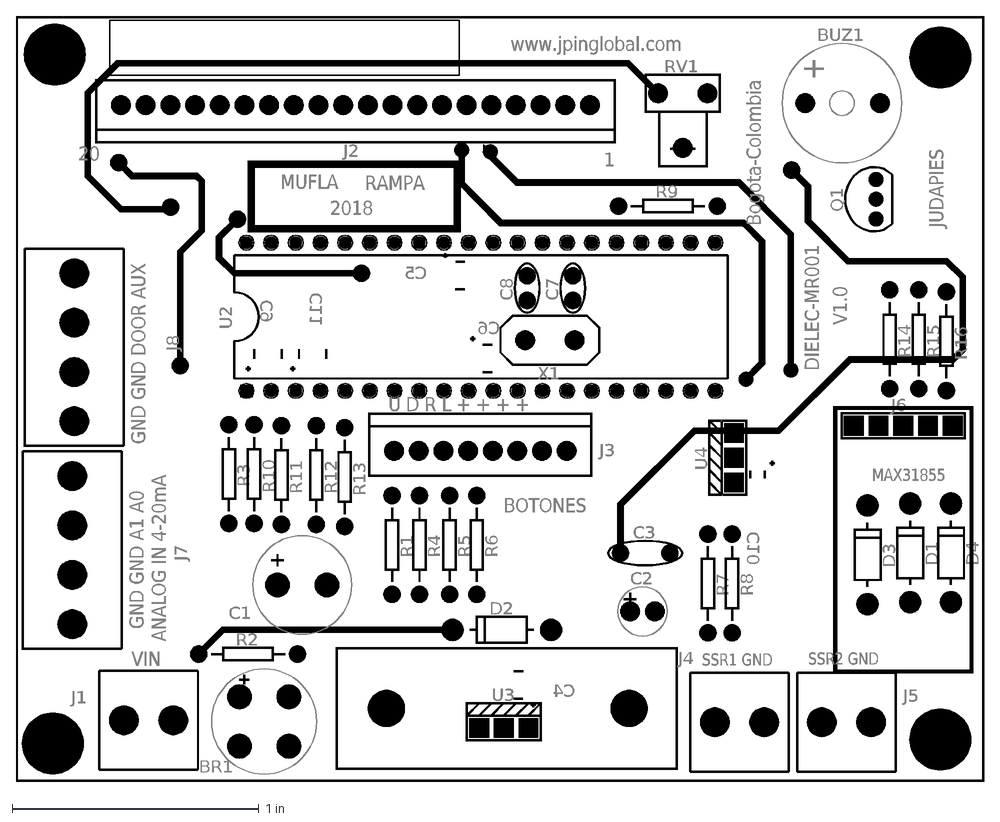
[picture p8: CAD file, 2021-07-30]
2018/Mufla 14L Artilab #004587922/Schematic/Mufla.DXF
J1
BR1
U3
U4
R2
D2
C1
C2
C3
U2
X1
C7
C8
R3
J2
J3
R1
R4
R5
R6
J6
R9
Q1
+
BUZ1
R14
R15
R16
D1
D3
D4
R7
R8
J4
J5
J7
J8
R10
R11
R12
R13
RV1
C4
C5
C6
C9
C10
C11
SSR1 GND
SSR2 GND
MAX31855
VIN
BOTONES
U D R L + + + +
20
1
GND GND A1 A0
ANALOG IN 4-20mA
GND GND DOOR AUX
MUFLA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
