judapies/Mufla/2019/Mufla 1.7L Avantika #004587973 OP201978/Schematic/Mufla.DXF

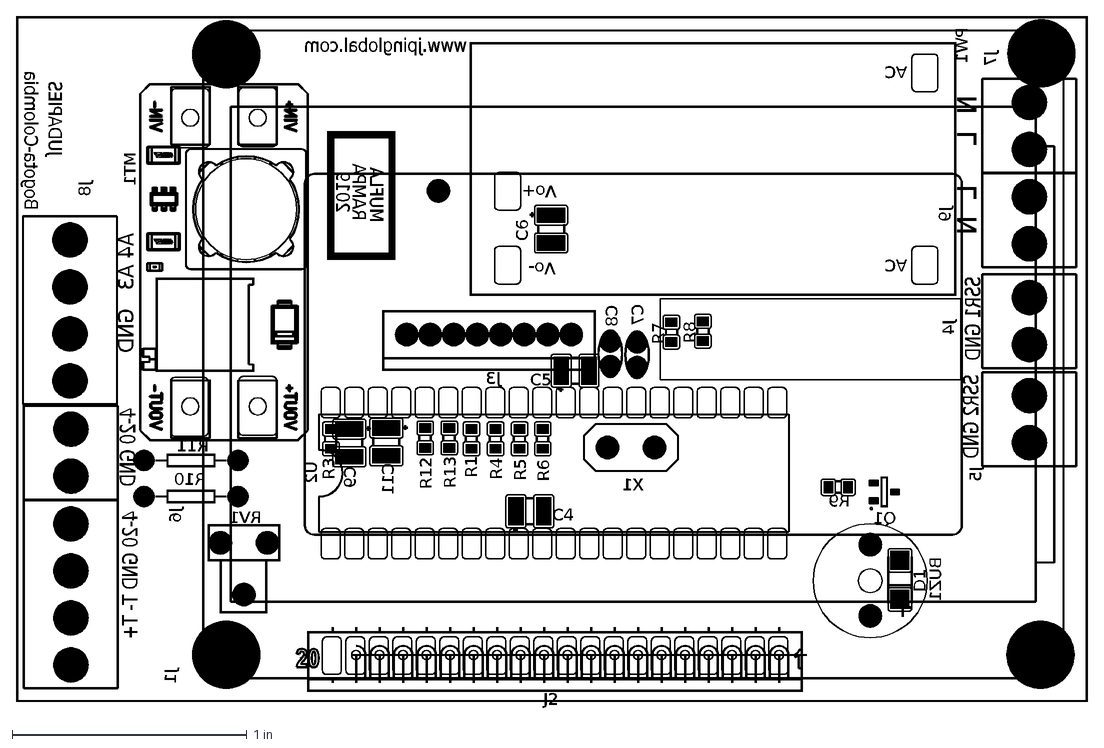
[picture p9: CAD file, 2021-07-30]
2019/Mufla 1.7L Avantika #004587973 OP201978/Schematic/Mufla.DXF
J2
MUFLA
RAMPA
2019
JUDAPIES
www.jpinglobal.com
Bogota-Colombia
U2
AC
Vo+
Vo-
PW1
MT1
X1
C7
C8
R9
Q1
+
BUZ1
D1
J3
R1
R4
R5
R6
J4
R7
R8
J7
J9
RV1
C4
C5
J1
J6
J8
R3
R10
R11
R12
R13
J5
N L
L N
SSR1 GND
SSR2 GND
C9
C11
C6
A4 A3 GND
4-20 GND
4-20 GND T- T+
