judapies/Mufla/2019/Mufla 9L Artilab #004588000 OP2019109/Schematic/Mufla.DXF

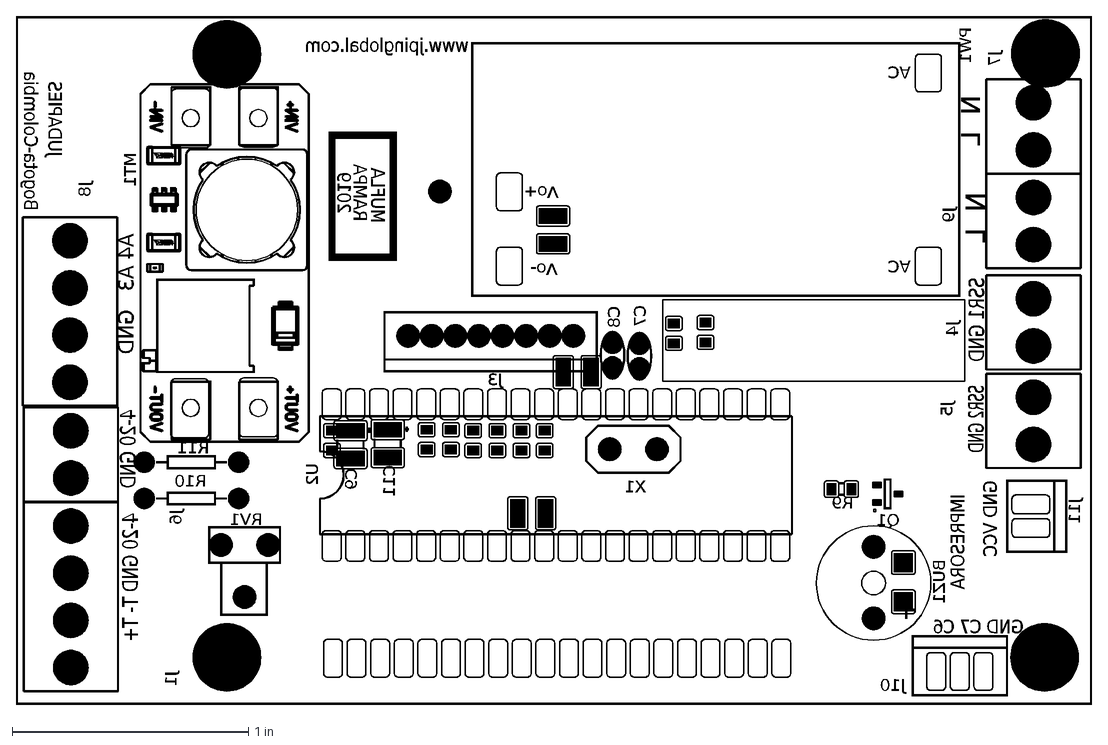
[picture p10: CAD file, 2021-07-30]
2019/Mufla 9L Artilab #004588000 OP2019109/Schematic/Mufla.DXF
MUFLA
RAMPA
2019
JUDAPIES
www.jpinglobal.com
Bogota-Colombia
U2
AC
Vo+
Vo-
PW1
MT1
X1
C7
C8
R9
Q1
+
BUZ1
J3
J4
J7
J9
RV1
J1
J6
J8
R10
R11
J5
N L
SSR1 GND
SSR2 GND
C9
C11
A4 A3 GND
4-20 GND
4-20 GND T- T+
GND C7 C6
IMPRESORA
J10
J11
GND VCC
