judapies/Mufla/2020/Mufla 14L Psoc Avantika #004588425 OP2020341/Schematic USB Com/USB_I2C.DXF

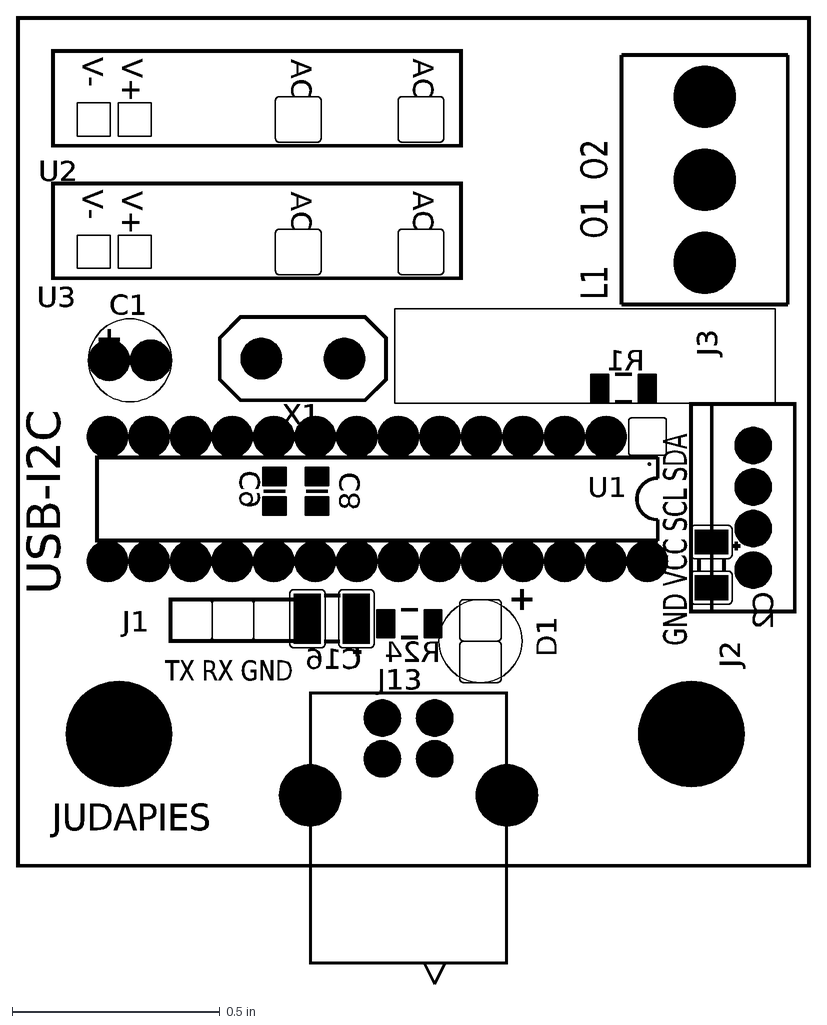
[picture p11: CAD file, 2021-07-30]
2020/Mufla 14L Psoc Avantika #004588425 OP2020341/Schematic USB Com/USB_I2C.DXF
J13
U1
C1
X1
C8
C9
D1
R1
R24
GND VCC SCL SDA
USB-I2C
JUDAPIES
J2
AC
V+
V-
U2
U3
J3
L1 O1 O2
J1
TX RX GND
C2
C16
