judapies/Mufla/2020/Mufla 14L Psoc Avantika #004588425 OP2020341/Schematic/PsocBoardTQFP.DXF

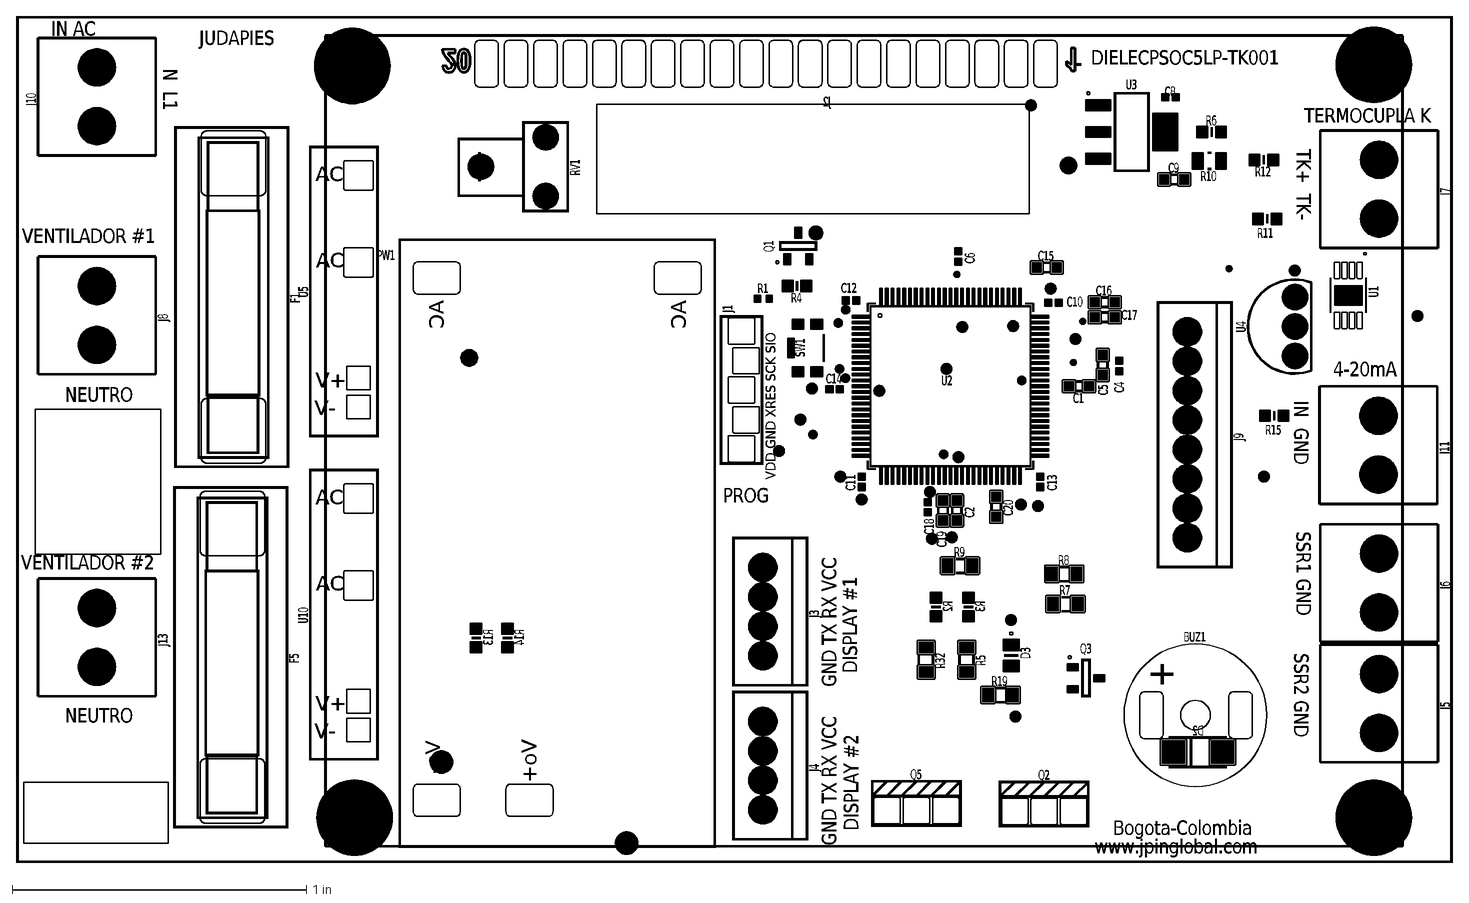
[picture p12: CAD file, 2021-07-30]
2020/Mufla 14L Psoc Avantika #004588425 OP2020341/Schematic/PsocBoardTQFP.DXF
AC
Vo+
Vo-
PW1
SW1
J1
U2
R5
Q2
J2
C1
C2
C4
C5
C10
C13
C11
C18
C19
C12
U1
U4
J7
R11
R12
R6
R10
RV1
J9
J3
J4
R9
Q3
+
BUZ1
D2
R7
R8
J5
J6
R32
V+
V-
U5
U10
F5
F1
J10
J13
J8
Q5
R1
U3
Q1
R4
J11
R15
R2
R3
R13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
