judapies/Mufla/2020/Mufla 2.2L Avantika #004588378-79 OP202094-95/Schematic/MuflaI2C.DXF

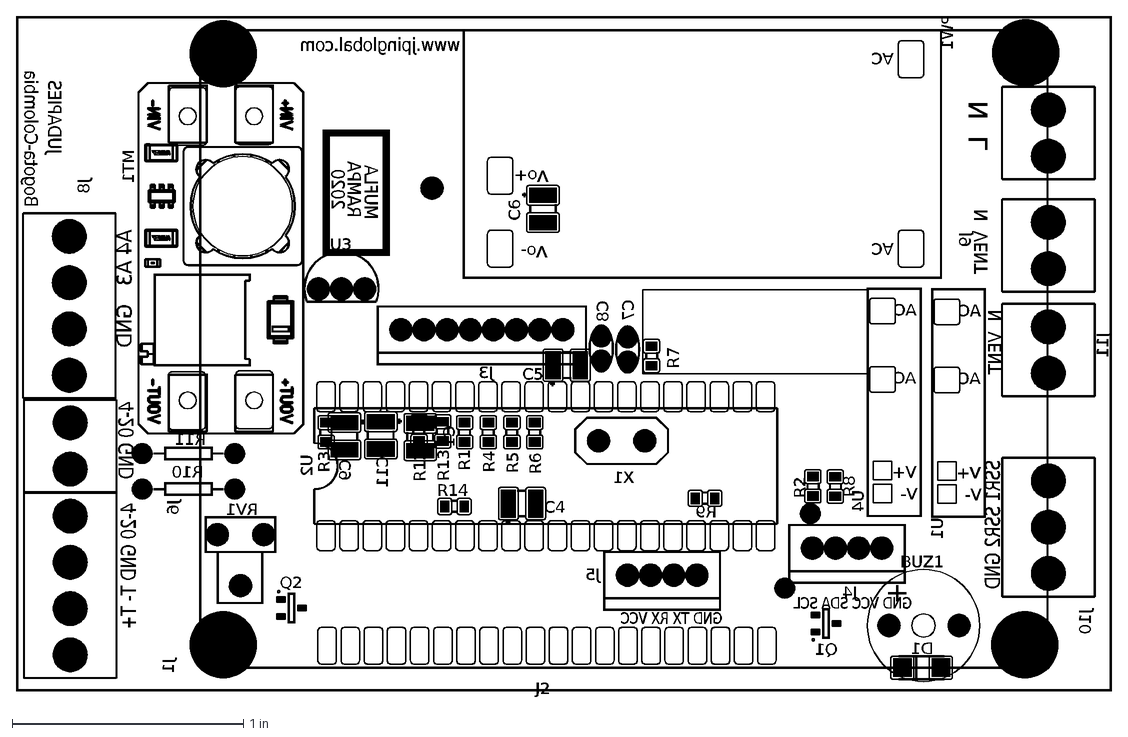
[picture p13: CAD file, 2021-07-30]
2020/Mufla 2.2L Avantika #004588378-79 OP202094-95/Schematic/MuflaI2C.DXF
J2
MUFLA
RAMPA
2020
JUDAPIES
www.jpinglobal.com
Bogota-Colombia
U2
AC
Vo+
Vo-
PW1
MT1
X1
C7
C8
J3
R1
R4
R5
R6
R7
J7
J9
RV1
C4
C5
J1
J6
J8
R3
R10
R11
R12
R13
N L
SSR1 SSR2 GND
C9
C11
C6
A4 A3 GND
4-20 GND
4-20 GND T- T+
N VENT
J10
J5
J4
V+
V-
U4
U1
J11
+
BUZ1
D1
Q1
R9
U3
C1
GND TX RX VCC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
