judapies/Mufla/2021/Mufla 3L Psoc Artilab #0045886XX OP2021128/Modelo/DXF/Lateral.dxf

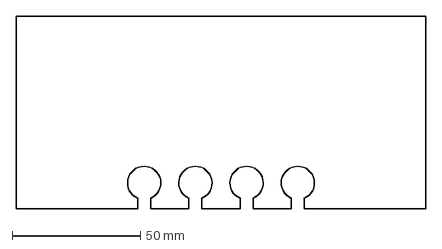
[picture p14: CAD file, 2021-07-30]
2021/Mufla 3L Psoc Artilab #0045886XX OP2021128/Modelo/DXF/Lateral.dxf
160.0 x 75.0 mm
