judapies/Mufla/2021/Mufla 4.5L Psoc MYC Lab #004588559 OP202145/Modelo/DXF/Lateral.dxf

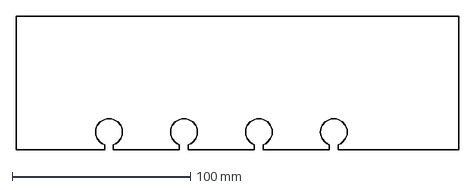
[picture p15: CAD file, 2021-07-30]
2021/Mufla 4.5L Psoc MYC Lab #004588559 OP202145/Modelo/DXF/Lateral.dxf
248.0 x 75.0 mm
