judapies/Mufla/2021/Mufla 9L Psoc Artilab #004588512 OP202139/Modelo/DXF/Piso.dxf

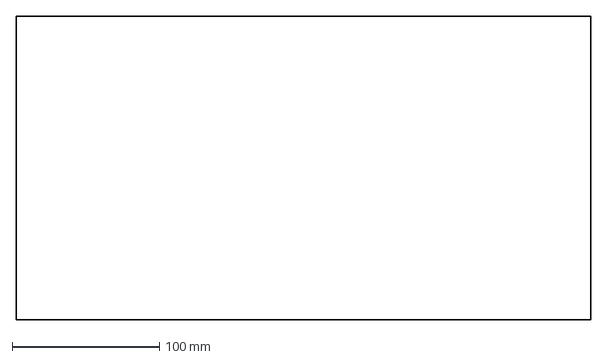
[picture p16: CAD file, 2021-07-30]
2021/Mufla 9L Psoc Artilab #004588512 OP202139/Modelo/DXF/Piso.dxf
390.0 x 206.2 mm
