judapies/Mufla/2021/Mufla 3L Psoc Artilab #0045886XX OP2021128/Modelo/DXF/Distribucion.dxf

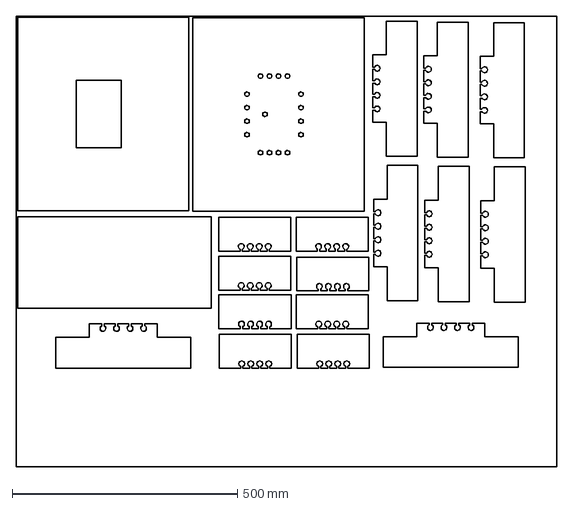
[picture p17: CAD file, 2021-07-30]
2021/Mufla 3L Psoc Artilab #0045886XX OP2021128/Modelo/DXF/Distribucion.dxf
1200.0 x 1000.0 mm
