judapies/Mufla/2021/Mufla 3L Psoc Artilab #0045886XX OP2021128/Modelo/TAPA FRONTAL M 2020-9.5L.STEP

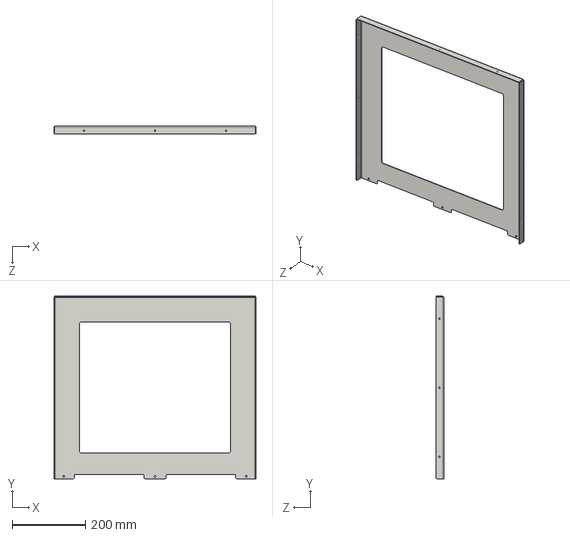
[picture p18: CAD file, 2021-07-30]
2021/Mufla 3L Psoc Artilab #0045886XX OP2021128/Modelo/TAPA FRONTAL M 2020-9.5L.STEP
551.0 x 498.0 x 21.5 mm
