judapies/Mufla/2021/Mufla 4.5L Psoc MYC Lab #004588559 OP202145/Modelo/DXF/Trasera.dxf

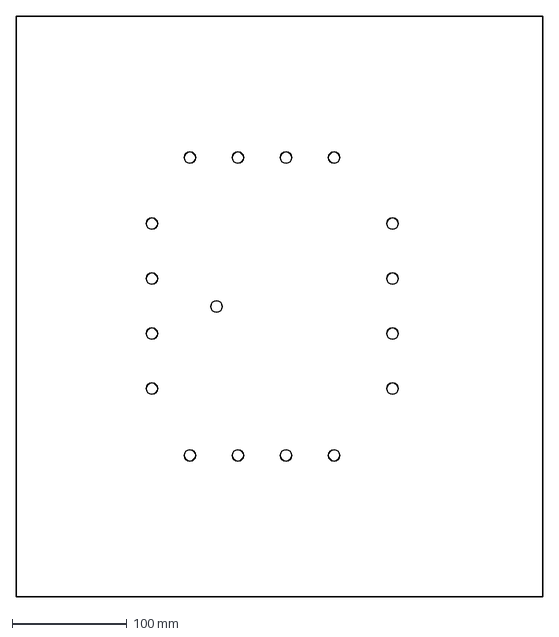
[picture p19: CAD file, 2021-07-30]
2021/Mufla 4.5L Psoc MYC Lab #004588559 OP202145/Modelo/DXF/Trasera.dxf
460.0 x 507.0 mm
