judapies/Mufla/2021/Mufla 9L Psoc Artilab #004588512 OP202139/Modelo/DXF/Superior.dxf

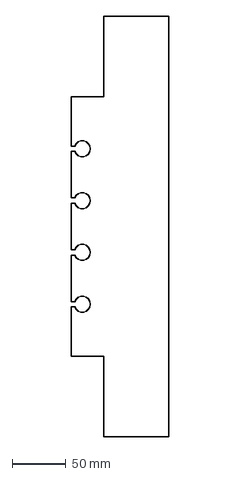
[picture p20: CAD file, 2021-07-30]
2021/Mufla 9L Psoc Artilab #004588512 OP202139/Modelo/DXF/Superior.dxf
90.0 x 390.0 mm
