judapies/Mufla/2021/Mufla 3L Psoc Artilab #0045886XX OP2021128/Modelo/DXF/TapaTrasera.dxf

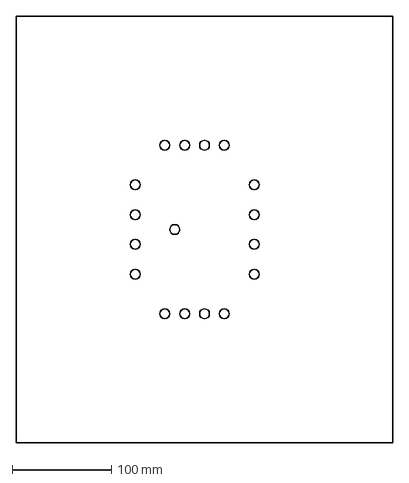
[picture p21: CAD file, 2021-07-30]
2021/Mufla 3L Psoc Artilab #0045886XX OP2021128/Modelo/DXF/TapaTrasera.dxf
380.0 x 430.0 mm
