judapies/Mufla/2021/Mufla 3L Psoc Artilab #0045886XX OP2021128/Modelo/DXF/Superior-Inferior.dxf

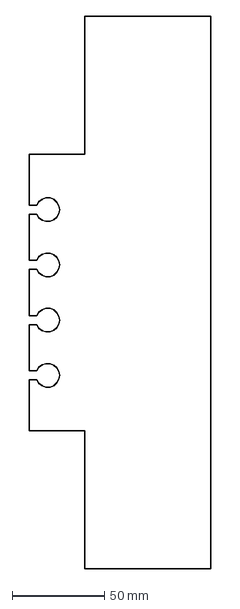
[picture p22: CAD file, 2021-07-30]
2021/Mufla 3L Psoc Artilab #0045886XX OP2021128/Modelo/DXF/Superior-Inferior.dxf
98.5 x 300.0 mm
