judapies/Mufla/2021/Mufla 4.5L Psoc MYC Lab #004588559 OP202145/Modelo/DXF/Frontal.dxf

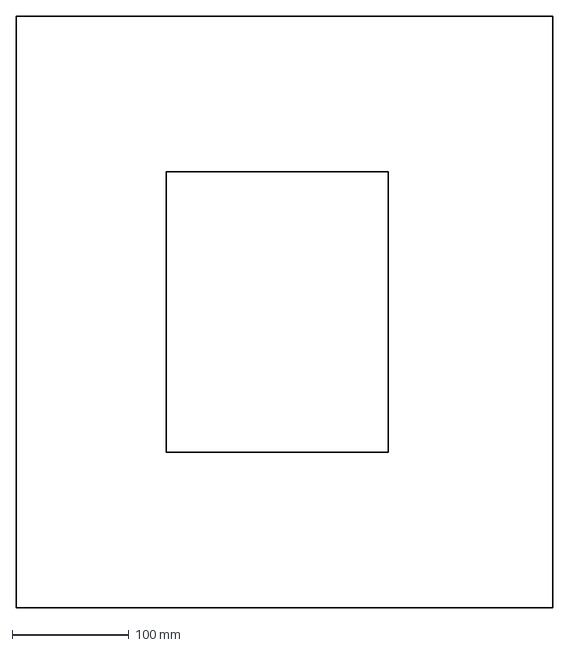
[picture p23: CAD file, 2021-07-30]
2021/Mufla 4.5L Psoc MYC Lab #004588559 OP202145/Modelo/DXF/Frontal.dxf
460.0 x 507.0 mm
