judapies/Mufla/2021/Mufla 9L Psoc Artilab #004588512 OP202139/Modelo/DXF/Distribucion.dxf

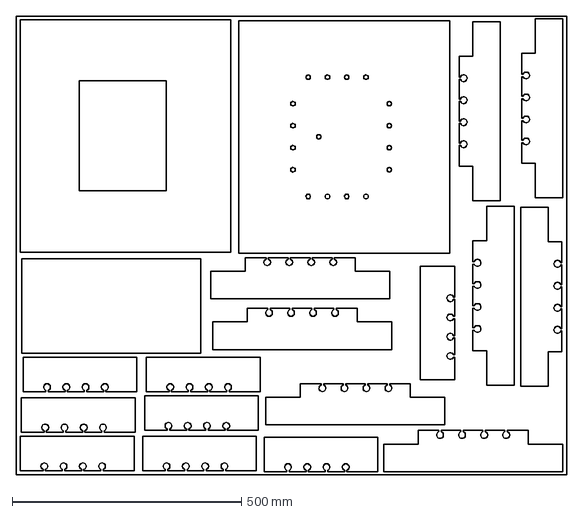
[picture p24: CAD file, 2021-07-30]
2021/Mufla 9L Psoc Artilab #004588512 OP202139/Modelo/DXF/Distribucion.dxf
1200.0 x 1000.0 mm
