judapies/Mufla/(list of files, cad)

Other CAD files:
2021/Mufla 3L Psoc Artilab #0045886XX OP2021128/Modelo/Termocupla/ENSAMBLE GENERAL ACH-160L-2021-P.dwg
2021/Mufla 4.5L Psoc MYC Lab #004588559 OP202145/Modelo/Planos/EnsambleAislante.dwg
2021/Mufla 3L Psoc Artilab #0045886XX OP2021128/Modelo/Planos/ENSAMBLE PUERTA M 2021-4.5L.dwg
2021/Mufla 9L Psoc Artilab #004588512 OP202139/Modelo/Planos/ENSAMBLE CUERPO PUERTA M 2020-9.5L.dwg
2021/Mufla 4.5L Psoc MYC Lab #004588559 OP202145/Modelo/Planos/ENSAMBLE PUERTA M 2021-4.5L.dwg
2021/Mufla 9L Psoc Artilab #004588512 OP202139/Modelo/Planos/EnsambleResistencia.dwg
2021/Mufla 4.5L Psoc MYC Lab #004588559 OP202145/Modelo/Planos/EnsambleResistencia.dwg
2021/Mufla 3L Psoc Artilab #0045886XX OP2021128/Modelo/Planos/ENSAMBLE CUERPO PUERTA M 2020-9.5L.dwg
2021/Mufla 4.5L Psoc MYC Lab #004588559 OP202145/Modelo/Planos/ENSAMBLE CUERPO PUERTA M 2020-9.5L.dwg
2021/Mufla 9L Psoc Artilab #004588512 OP202139/Modelo/Planos/EnsambleAislante.dwg
2021/Mufla 3L Psoc Artilab #0045886XX OP2021128/Modelo/Planos/EnsambleAislante.dwg
2021/Mufla 3L Psoc Artilab #0045886XX OP2021128/Modelo/Planos/EnsambleResistencia.dwg
2018/Mufla 14L Artilab #004587922/Plano Electrico Mufla/ConexionesElectricasYElectronicas.dwg
2018/Mufla 27L Artilab #004587921/Plano Electrico Mufla/ConexionesElectricasYElectronicas.dwg
2018/Mufla 3L Avantika #004587835/Plano Electrico Mufla/ConexionesElectricasYElectronicas.dwg
2018/Mufla Avantika #004587751/Plano Electrico Mufla/Mufla220V.dwg
2018/Mufla Avantika #004587752/Plano Electrico Mufla/ConexionesElectricasYElectronicas.dwg
2019/Horno Tubular #004587931/Plano Electrico Horno Tubular/ConexionesElectricasYElectronicas.dwg
2019/Mufla 1.7L Avantika #004587973 OP201978/Plano Electrico Mufla/ConexionesElectricasYElectronicas.dwg
2019/Mufla 16L Avantika #004588073 OP2019142/Plano Electrico Mufla/ConexionesElectricasYElectronicas.dwg
2019/Mufla 16L Avantika #004588074 OP2019143/Plano Electrico Mufla/ConexionesElectricasYElectronicas.dwg
2019/Mufla 2.2L Artilab #0045880XX OP2019151/Plano Electrico Mufla/ConexionesElectricasYElectronicas.dwg
2019/Mufla 27L Artilab #004587999 OP2019131/Plano Electrico Mufla/ConexionesElectricasYElectronicas.dwg
2019/Mufla 3L Avantika #004587981 OP201983/Plano Electrico Mufla/ConexionesElectricasYElectronicas.dwg
2019/Mufla 3L Blamis #004588005 OP2019130/Plano Electrico Mufla/ConexionesElectricasYElectronicas.dwg
2019/Mufla 4L Artilab #004588010 OP2019132/Plano Electrico Mufla/ConexionesElectricasYElectronicas.dwg
2019/Mufla 9L Artilab #004588000 OP2019109/Plano Electrico Mufla/ConexionesElectricasYElectronicas.dwg
2020/Mufla 14L Avantika #004588239 OP2020144/Plano Electrico Mufla/ConexionesElectricasYElectronicas.dwg
2020/Mufla 14L Psoc Avantika #004588425 OP2020341/Plano Electrico Mufla/ConexionesElectricasYElectronicas.dwg
2020/Mufla 14L Touch Avantika #004588248 OP202019/Plano Electrico Mufla/ConexionesElectricasYElectronicas.dwg
2020/Mufla 2.2L Avantika #004588378-79 OP202094-95/Plano Electrico Mufla/ConexionesElectricasYElectronicas.dwg
2020/Mufla 2.2L Psoc Avantika #004588419 OP2020346/Plano Electrico Mufla/ConexionesElectricasYElectronicas.dwg
2020/Mufla 4L Artilab #004588090 OP2019208/Plano Electrico Mufla/ConexionesElectricasYElectronicas.dwg
2020/Mufla 4L Suministros 724 #004588086 OP202054/Plano Electrico Mufla/ConexionesElectricasYElectronicas.dwg
2020/Mufla 9L Psoc Artilab #004588456 OP2020376/Plano Electrico Mufla/ConexionesElectricasYElectronicas.dwg
2021/Mufla 3L Psoc Artilab #0045886XX OP2021128/Modelo/Planos/PiezaPuerta-1.dwg
2021/Mufla 3L Psoc Artilab #0045886XX OP2021128/Plano Electrico Mufla/ConexionesElectricasYElectronicas.dwg
2021/Mufla 4.5L Psoc MYC Lab #004588559 OP202145/Modelo/Planos/PiezaPuerta-4.dwg
2021/Mufla 4.5L Psoc MYC Lab #004588559 OP202145/Plano Electrico Mufla/ConexionesElectricasYElectronicas.dwg
2021/Mufla 9L Psoc Artilab #004588512 OP202139/Modelo/Planos/Piso.dwg
2021/Mufla 9L Psoc Artilab #004588512 OP202139/Plano Electrico Mufla/ConexionesElectricasYElectronicas.dwg
2018/Mufla Avantika #004587751/Plano Electrico Mufla/ConexionesElectricasYElectronicas.dwg
2021/Mufla 3L Psoc Artilab #0045886XX OP2021128/Modelo/Planos/PiezaPuerta-4.dwg
2021/Mufla 3L Psoc Artilab #0045886XX OP2021128/Modelo/Termocupla/Termocupla.dwg
2021/Mufla 9L Psoc Artilab #004588512 OP202139/Modelo/Planos/PiezaPuerta-1.dwg
2021/Mufla 4.5L Psoc MYC Lab #004588559 OP202145/Modelo/Planos/Resistencia3.dwg
2021/Mufla 9L Psoc Artilab #004588512 OP202139/Modelo/Planos/PiezaPuerta-3.dwg
2021/Mufla 3L Psoc Artilab #0045886XX OP2021128/Modelo/Planos/Lateral.dwg
2021/Mufla 4.5L Psoc MYC Lab #004588559 OP202145/Modelo/Planos/Trasera.dwg
2021/Mufla 3L Psoc Artilab #0045886XX OP2021128/Modelo/Planos/Resistencia3.dwg
2021/Mufla 3L Psoc Artilab #0045886XX OP2021128/Modelo/Planos/Trasera.dwg
2021/Mufla 4.5L Psoc MYC Lab #004588559 OP202145/Modelo/Planos/PiezaPuerta-2.dwg
2021/Mufla 9L Psoc Artilab #004588512 OP202139/Modelo/Planos/PiezaInferior.dwg
2021/Mufla 3L Psoc Artilab #0045886XX OP2021128/Modelo/Planos/TapaFrontal.dwg
2021/Mufla 4.5L Psoc MYC Lab #004588559 OP202145/Modelo/Planos/PiezaPuerta-1.dwg
2021/Mufla 9L Psoc Artilab #004588512 OP202139/Modelo/Planos/Trasera.dwg
2021/Mufla 3L Psoc Artilab #0045886XX OP2021128/Modelo/Planos/PiezaPuerta-2.dwg
2021/Mufla 9L Psoc Artilab #004588512 OP202139/Modelo/Planos/Lateral.dwg
2021/Mufla 4.5L Psoc MYC Lab #004588559 OP202145/Modelo/Planos/TapaFrontal.dwg
2021/Mufla 9L Psoc Artilab #004588512 OP202139/Modelo/Planos/PiezaPuerta-2.dwg
2021/Mufla 3L Psoc Artilab #0045886XX OP2021128/Modelo/Planos/PiezaPuerta-3.dwg
2021/Mufla 9L Psoc Artilab #004588512 OP202139/Modelo/Planos/TapaFrontal.dwg
2021/Mufla 3L Psoc Artilab #0045886XX OP2021128/Modelo/Planos/Resistencia2.dwg
2021/Mufla 4.5L Psoc MYC Lab #004588559 OP202145/Modelo/Planos/PiezaInferior.dwg
2021/Mufla 3L Psoc Artilab #0045886XX OP2021128/Modelo/Planos/PiezaInferior.dwg
2021/Mufla 4.5L Psoc MYC Lab #004588559 OP202145/Modelo/Planos/Resistencia2.dwg
2021/Mufla 4.5L Psoc MYC Lab #004588559 OP202145/Modelo/Planos/PiezaPuerta-3.dwg
2021/Mufla 4.5L Psoc MYC Lab #004588559 OP202145/Modelo/Planos/Lateral.dwg
2021/Mufla 3L Psoc Artilab #0045886XX OP2021128/Modelo/Planos/Piso.dwg
2021/Mufla 4.5L Psoc MYC Lab #004588559 OP202145/Modelo/Planos/Piso.dwg
2021/Mufla 3L Psoc Artilab #0045886XX OP2021128/Modelo/BASE M 2021-4.5L.ipt
2021/Mufla 3L Psoc Artilab #0045886XX OP2021128/Modelo/BRAKER.ipt
2021/Mufla 3L Psoc Artilab #0045886XX OP2021128/Modelo/COMPLEMENTO BASE M 2021-4.5L.ipt
2021/Mufla 3L Psoc Artilab #0045886XX OP2021128/Modelo/COMPLEMENTO CUERPO INTERIOR M 2020- 4L (B).ipt
2021/Mufla 3L Psoc Artilab #0045886XX OP2021128/Modelo/CONTRATAPA EXTERIOR M 2021-4.5L.ipt
2021/Mufla 3L Psoc Artilab #0045886XX OP2021128/Modelo/CONTRATAPA INTERIOR M 2021-4.5L.ipt
2021/Mufla 3L Psoc Artilab #0045886XX OP2021128/Modelo/CUBIERTA INTERNA M 2021-4.5L.ipt
2021/Mufla 3L Psoc Artilab #0045886XX OP2021128/Modelo/CUERPO M 2021-4.5L.ipt
2021/Mufla 3L Psoc Artilab #0045886XX OP2021128/Modelo/DXF/Distribucion.dwg
2021/Mufla 3L Psoc Artilab #0045886XX OP2021128/Modelo/DXF/TapaFrontal.dwg
2021/Mufla 3L Psoc Artilab #0045886XX OP2021128/Modelo/ENSAMBLE CUERPO INTERIOR M 2021-4.5L.iam
2021/Mufla 3L Psoc Artilab #0045886XX OP2021128/Modelo/ENSAMBLE CUERPO M 2021-4.5L.iam
2021/Mufla 3L Psoc Artilab #0045886XX OP2021128/Modelo/ENSAMBLE CUERPO PUERTA M 2021-4.5L.iam
2021/Mufla 3L Psoc Artilab #0045886XX OP2021128/Modelo/ENSAMBLE GENERAL M 2021-4.5L.iam
2021/Mufla 3L Psoc Artilab #0045886XX OP2021128/Modelo/ENSAMBLE PUERTA M 2021-4.5L.iam
2021/Mufla 3L Psoc Artilab #0045886XX OP2021128/Modelo/EnsambleAislante.iam
2021/Mufla 3L Psoc Artilab #0045886XX OP2021128/Modelo/EnsambleResistencia.iam
2021/Mufla 3L Psoc Artilab #0045886XX OP2021128/Modelo/FRONTAL PUERTA M 2021-4.5L.ipt
2021/Mufla 3L Psoc Artilab #0045886XX OP2021128/Modelo/LATERAL PUERTA M 2021-4.5L.ipt
2021/Mufla 3L Psoc Artilab #0045886XX OP2021128/Modelo/Lateral.ipt
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
