judapies/Mufla/2020/Mufla 14L Psoc Avantika #004588425 OP2020341/Firmware Psoc V/LCD2/MuflaGLCD.cydsn/CortexM3/ARM_GCC_541/Debug/LINK_options.txt

-Wl,--start-group -o "D:\\Laboratorio\\Mufla\\2020\\Mufla\ 14L\ Psoc\ Avantika\ #0045884XX\ OP2020341\\Firmware\ Psoc\\LCD2\\MuflaGLCD.cydsn\\CortexM3\\ARM_GCC_541\\Debug\\MuflaGLCD.elf" ".\\CortexM3\\ARM_GCC_541\\Debug\\main.o" ".\\CortexM3\\ARM_GCC_541\\Debug\\coldJnTemp.o" ".\\CortexM3\\ARM_GCC_541\\Debug\\removeoffsetnoise.o" ".\\CortexM3\\ARM_GCC_541\\Debug\\ks0108.o" ".\\CortexM3\\ARM_GCC_541\\Debug\\Funciones.o" ".\\CortexM3\\ARM_GCC_541\\Debug\\cyfitter_cfg.o" ".\\CortexM3\\ARM_GCC_541\\Debug\\cymetadata.o" ".\\CortexM3\\ARM_GCC_541\\Debug\\Cm3Start.o" ".\\CortexM3\\ARM_GCC_541\\Debug\\MuflaGLCD.a" "C:\\Program\ Files\ (x86)\\Cypress\\PSoC\ Creator\\4.3\\PSoC\ Creator\\psoc\\content\\cycomponentlibrary\\CyComponentLibrary.cylib\\CortexM3\\ARM_GCC_541\\Debug\\CyComponentLibrary.a" -mcpu=cortex-m3 -mthumb -L "Generated_Source\\PSoC5" "-Wl,-Map,.\\CortexM3\\ARM_GCC_541\\Debug/MuflaGLCD.map" -T "Generated_Source\\PSoC5\\cm3gcc.ld" -specs=nano.specs -u _printf_float -Wl,--gc-sections -u_printf_float -g -ffunction-sections -Og -ffat-lto-objects -Wl,--end-group
