judapies/Mufla/2020/Mufla 14L Touch Avantika #004588248 OP202019/Firmware Psoc/LCD2/LCD.cydsn/CortexM3/ARM_GCC_541/Debug/LINK_options.txt

-Wl,--start-group -o "F:\\Firmware\ Psoc\\LCD2\\LCD.cydsn\\CortexM3\\ARM_GCC_541\\Debug\\LCD.elf" ".\\CortexM3\\ARM_GCC_541\\Debug\\main.o" ".\\CortexM3\\ARM_GCC_541\\Debug\\coldJnTemp.o" ".\\CortexM3\\ARM_GCC_541\\Debug\\removeoffsetnoise.o" ".\\CortexM3\\ARM_GCC_541\\Debug\\cyfitter_cfg.o" ".\\CortexM3\\ARM_GCC_541\\Debug\\cymetadata.o" ".\\CortexM3\\ARM_GCC_541\\Debug\\Cm3Start.o" ".\\CortexM3\\ARM_GCC_541\\Debug\\LCD.a" "C:\\Program\ Files\\Cypress\\PSoC\ Creator\\4.3\\PSoC\ Creator\\psoc\\content\\cycomponentlibrary\\CyComponentLibrary.cylib\\CortexM3\\ARM_GCC_541\\Debug\\CyComponentLibrary.a" -mcpu=cortex-m3 -mthumb -L "Generated_Source\\PSoC5" "-Wl,-Map,.\\CortexM3\\ARM_GCC_541\\Debug/LCD.map" -T "Generated_Source\\PSoC5\\cm3gcc.ld" -specs=nano.specs -u _printf_float -Wl,--gc-sections -u_printf_float -g -ffunction-sections -Og -ffat-lto-objects -Wl,--end-group
