judapies/Mufla/2018/Mufla 14L Artilab #004587922/Plano Electrico Mufla/PlanoMufla.pdf

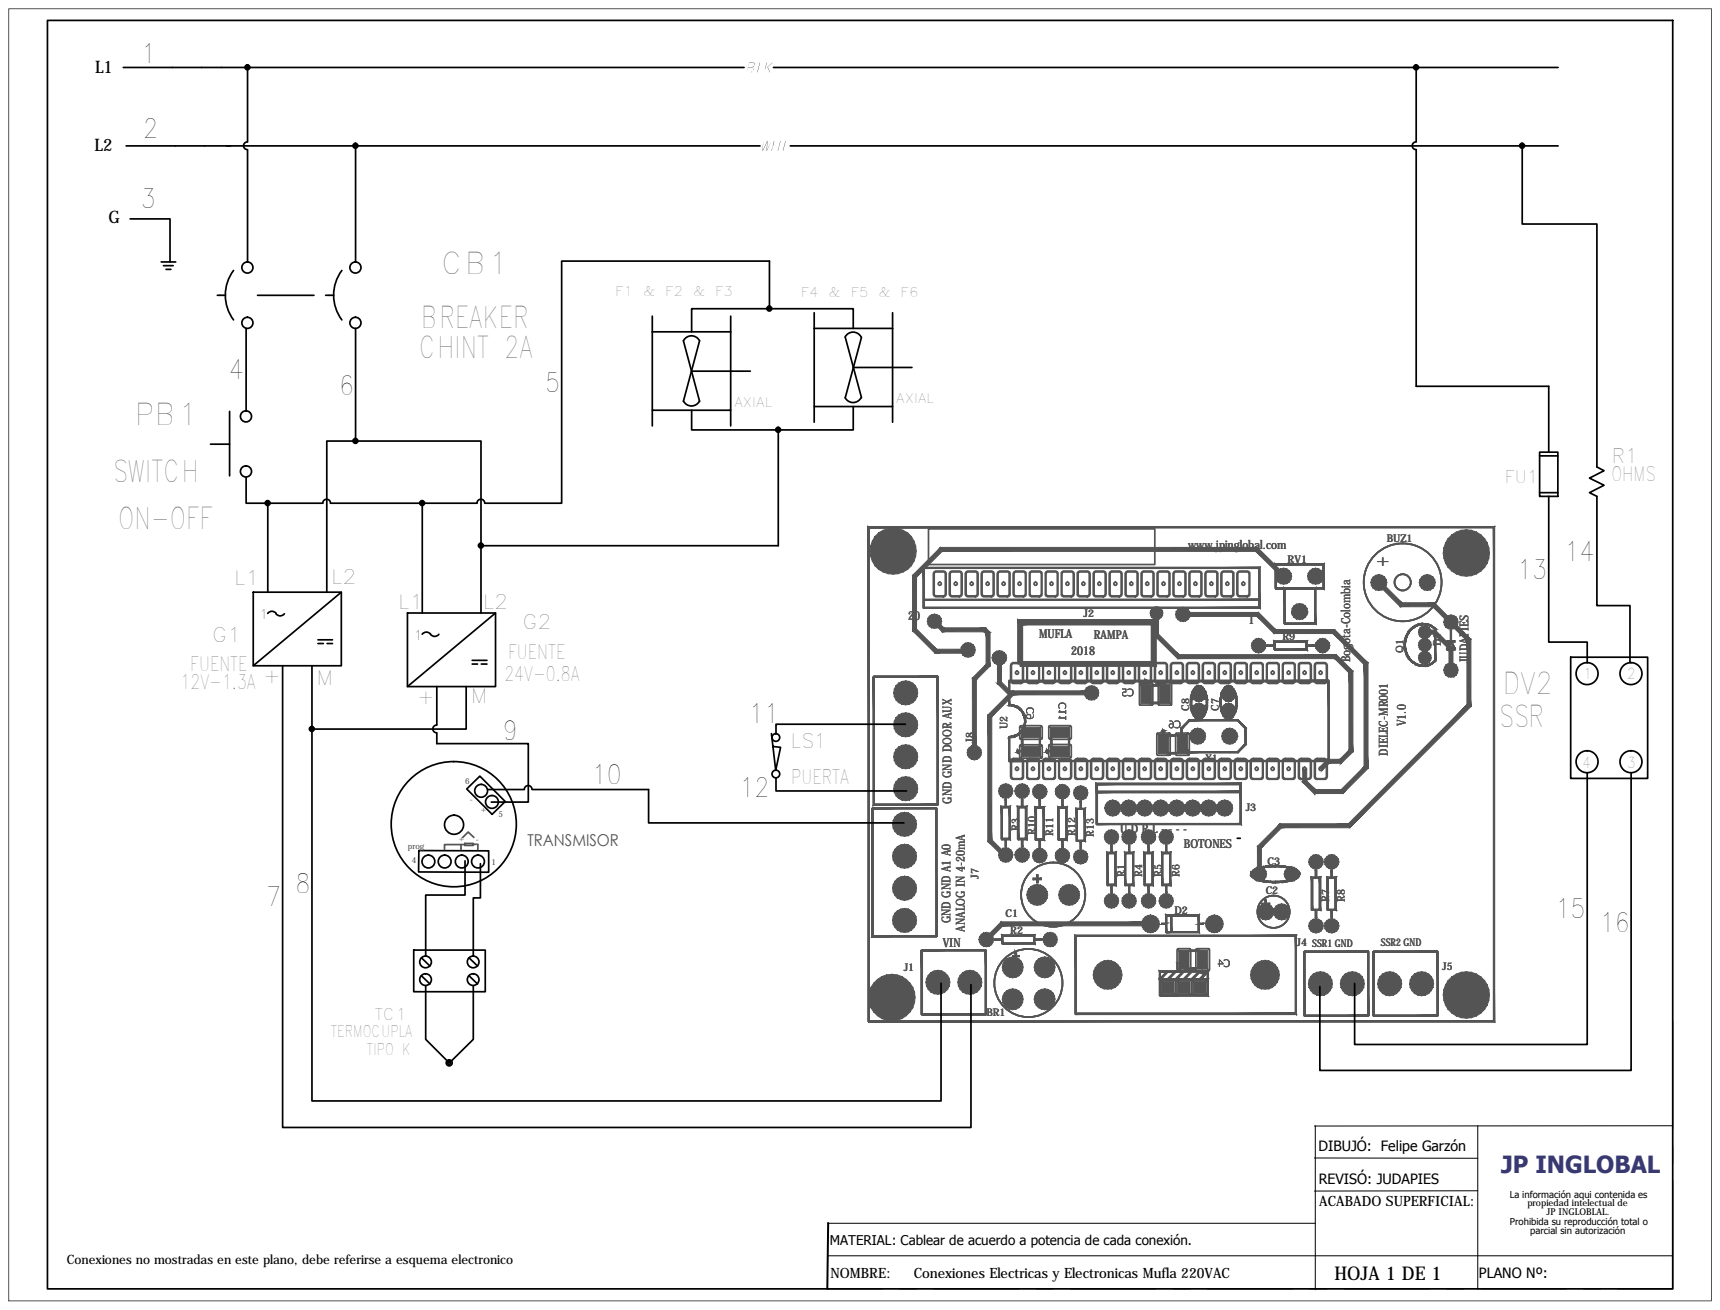
[picture p81: page 1]

Bogota-Colombia DIELEC-MR001 V1.0 SSR DV2 3 1 2 4 PUERTA LS1 6 5 + - 1 4prog + - TRANSMISOR 4 6 5 7 8 9 10 11 12 13 14 15 16

R10 R11 R12 R13 RV1 VIN SSR1 GND SSR2 GND BOTONES U D R L - - - - 20 1

GND GND A1 A0 ANALOG IN 4-20mA GND GND DOOR AUX MUFLA RAMPA 2018
