judapies/Mufla/2018/Mufla 3L Avantika #004587835/Plano Electrico Mufla/PlanoMufla.pdf

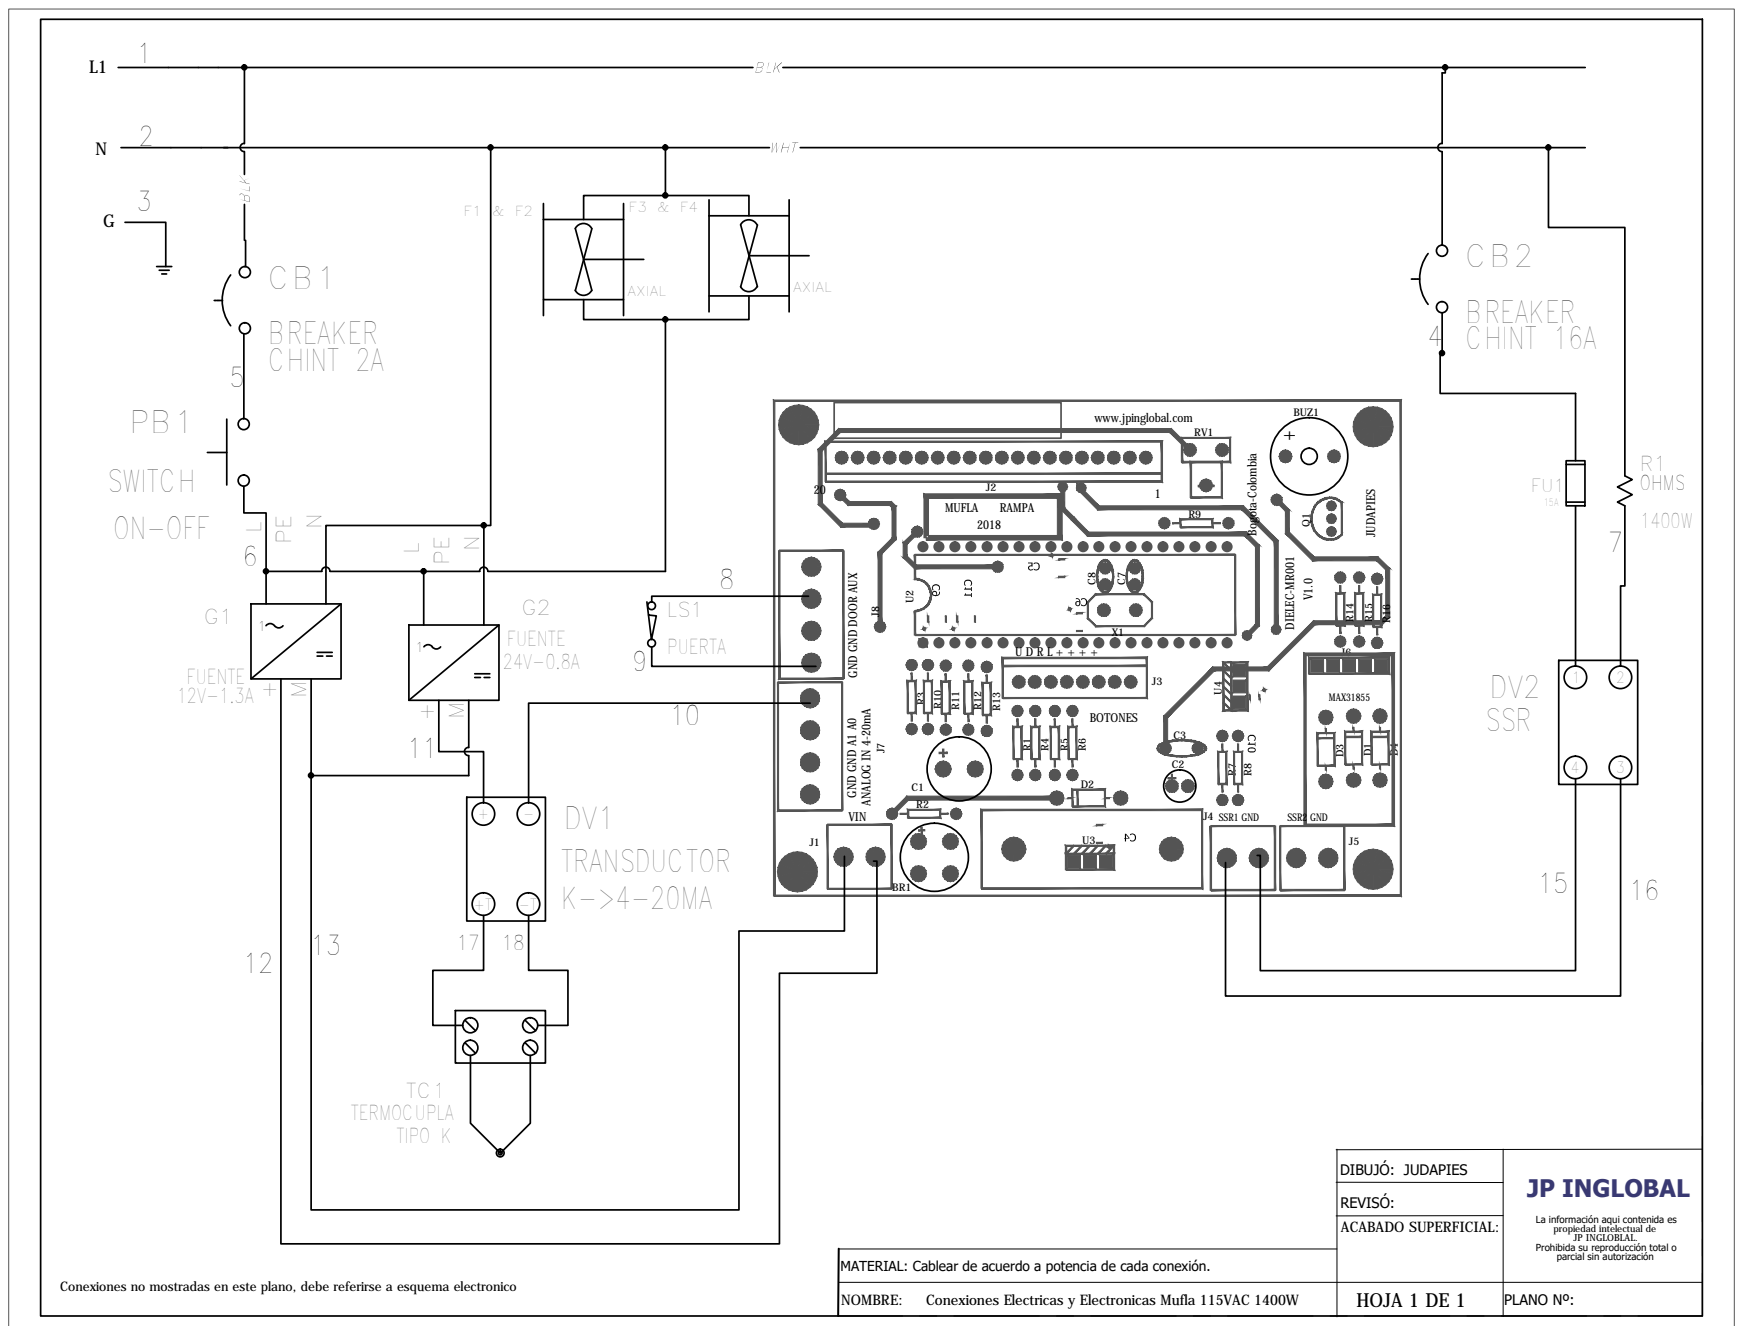
[picture p82: page 1]

PEL +M ON-OFF SWITCH PB1 CHINT 2A BREAKER CB1 K->4-20MA TRANSDUCTOR DV1 -T + - +T TIPO K TERMOCUPLA TC1 17 18 CHINT 16A BREAKER CB2 OHMS 1400W R1 PUERTA LS1 12 4 56 7 8 9 12 13 15 16 10 15A FU1 1 FUENTE 24V-0.8A G2 N

Bogota-Colombia DIELEC-MR001 V1.0 SSR DV2 3 1 2 4 1 FUENTE 12V-1.3A G1 N

GND GND A1 A0 ANALOG IN 4-20mA GND GND DOOR AUX MUFLA RAMPA 2018
