judapies/Mufla/2018/Mufla Avantika #004587751/Plano Electrico Mufla/Mufla220V.pdf

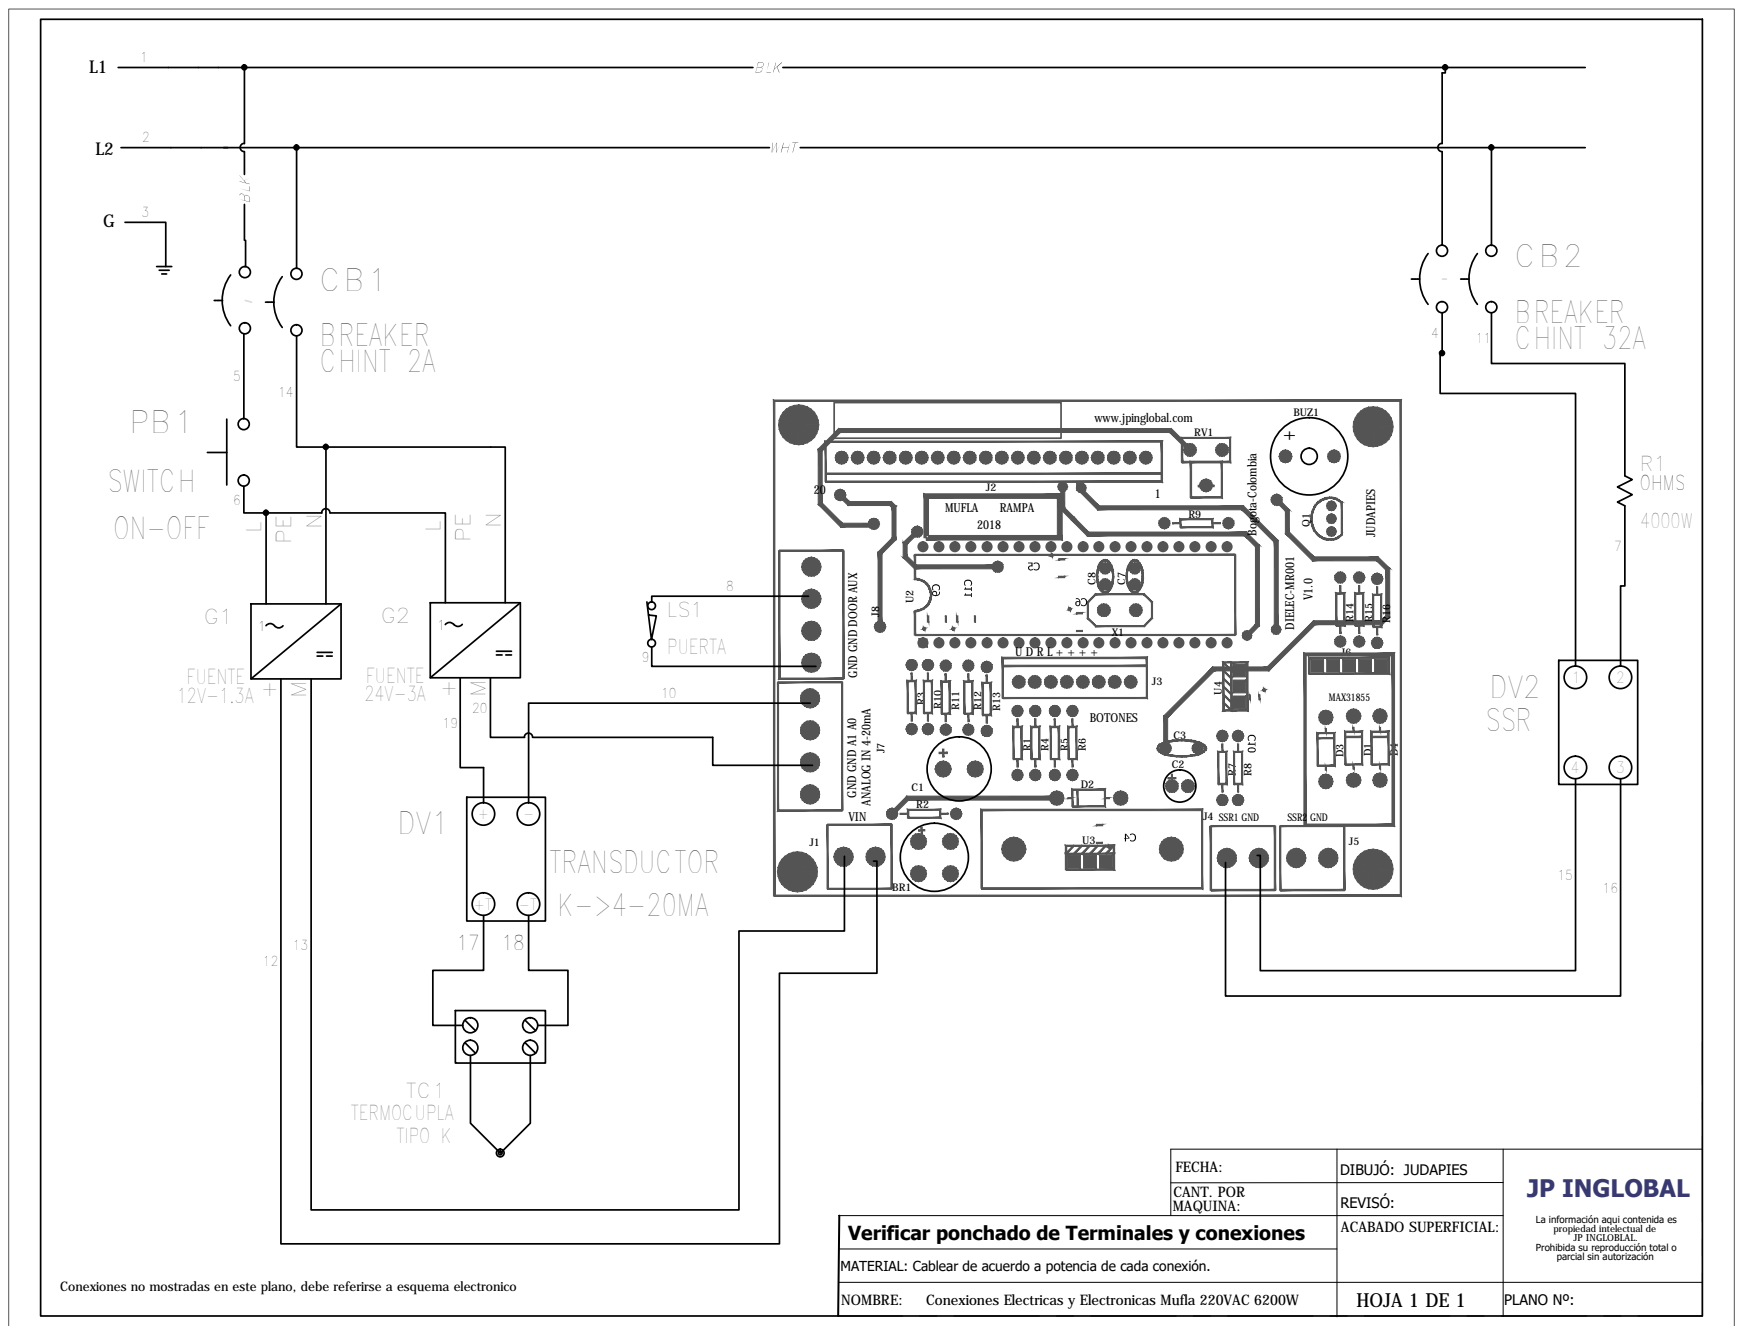
[picture p83: page 1]

PEL +M ON-OFF SWITCH PB1 K->4-20MA TRANSDUCTOR DV1 -T + - +T TIPO K TERMOCUPLA TC1 17 18 OHMS 4000W R1 PUERTA LS1 12 4 56 7 8 9 12 13 15 16 10 1 FUENTE 24V-3A G2 N

PEL +M CHINT 2A BREAKER CB1 CHINT 32A BREAKER CB2 11 14 19 20

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

GND GND A1 A0 ANALOG IN 4-20mA GND GND DOOR AUX MUFLA RAMPA 2018
