judapies/Mufla/2019/Horno Tubular #004587931/Plano Electrico Horno Tubular/PlanoHornoTubular.pdf

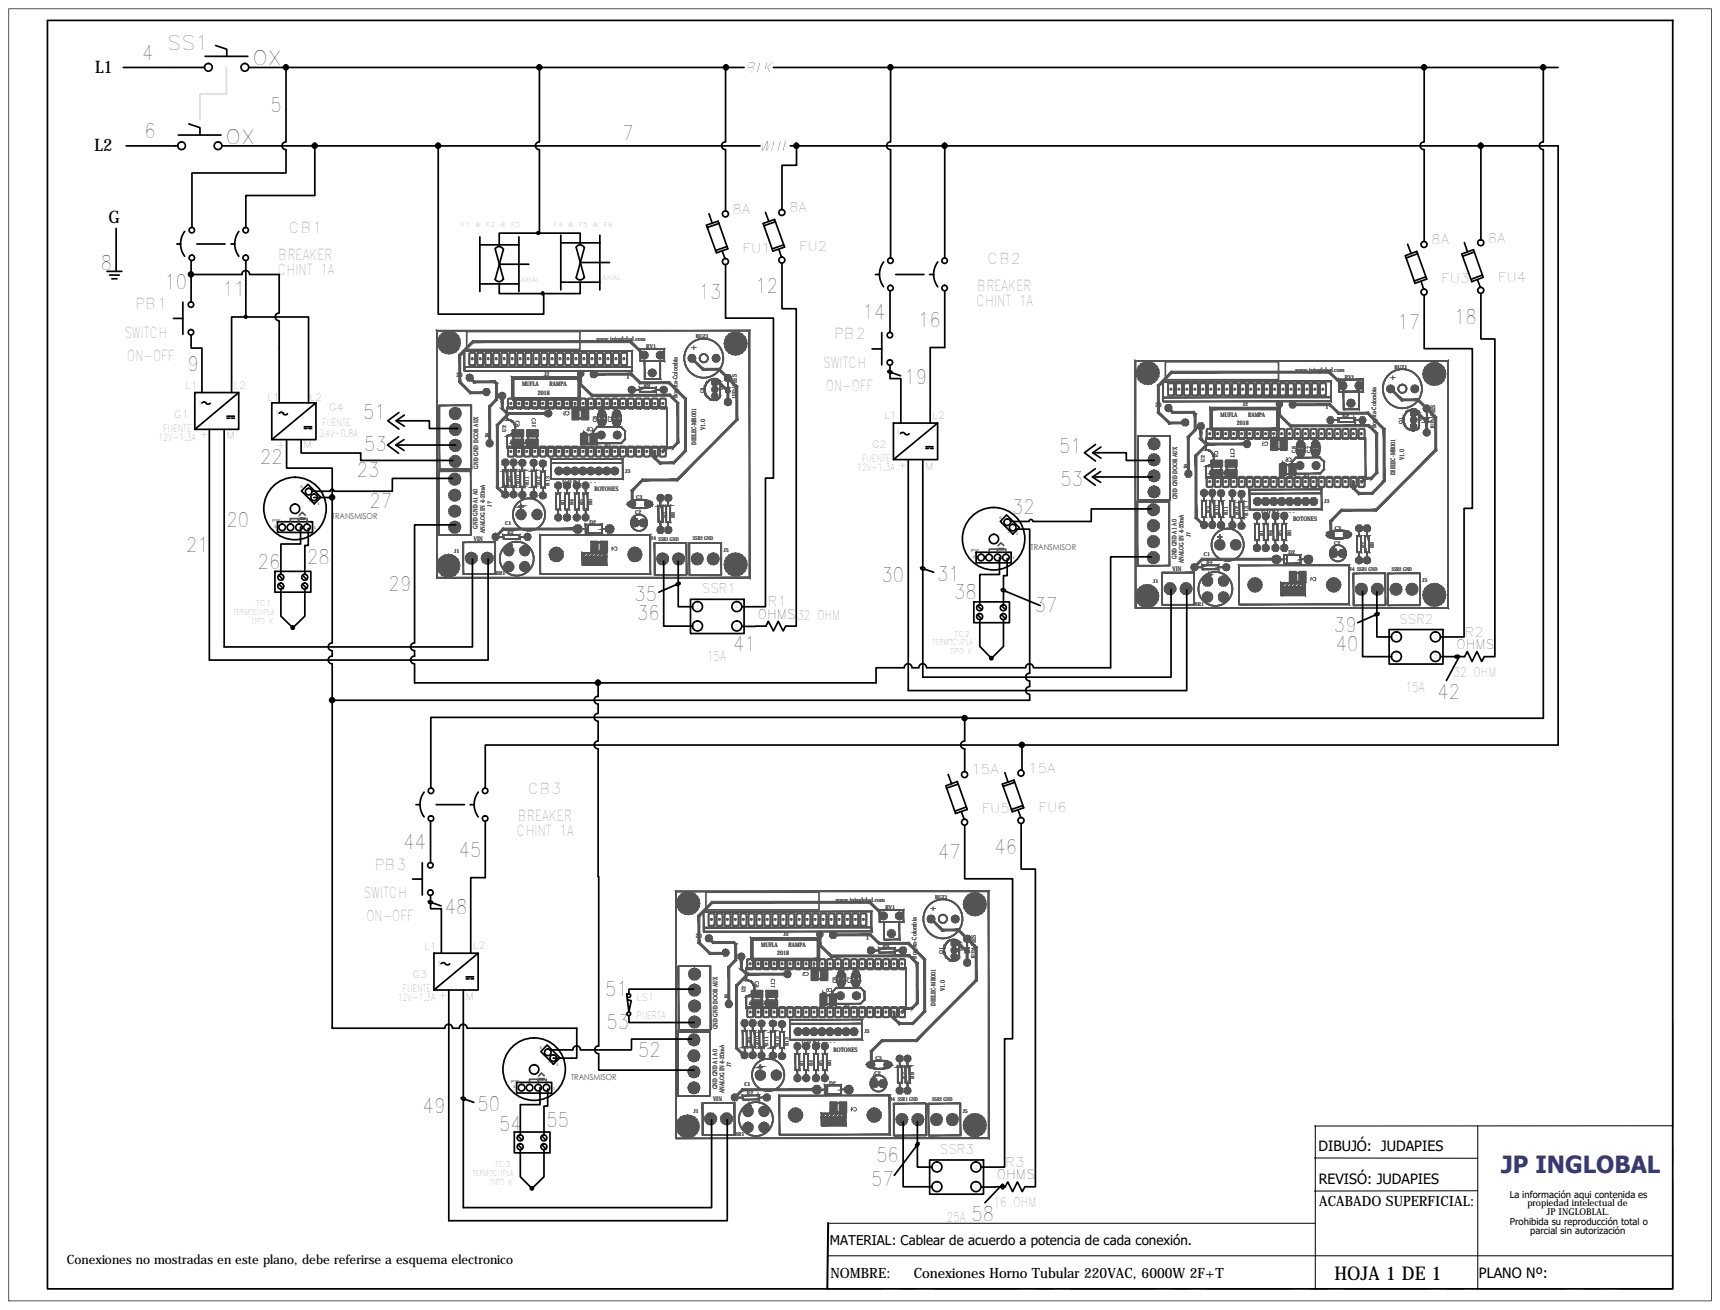
[picture p84: page 1]

Bogota-Colombia DIELEC-MR001 V1.0 3 15A 4 1 2 SSR18AFU1 8AFU2 OHMS 32 OHM R1 OX SS1 OX 1 FUENTE 12V-1.3A G2L1 L2 +M ON-OFF SWITCH PB2 CHINT 1A BREAKER CB2 TIPO K TERMOCUPLA TC2 6 5 + - 1 4prog + - TRANSMISOR J1 BR1 U3 R2 C1 D2 C2C3

Bogota-Colombia DIELEC-MR001 V1.0 3 25A 4 1 2 SSR315AFU5 15AFU6 OHMS 16 OHM R3 PUERTA LS1 F1 & F2 & F3AXIAL F4 & F5 & F6 AXIAL 4 5 6 8 10 11 13 12 14 16 17 18 19 21 22 29 30 31 32 3536 37 3940 44 45 47 46 48 49 50 56 57 7 9 26 28 20 27 23 41 38 42 54 55 52 58 5153 5153 5153

Bogota-Colombia DIELEC-MR001 V1.0 3 15A 4 1 2 SSR28AFU3 8AFU4 OHMS 32 OHM R2 1 FUENTE 12V-1.3A G3L1 L2 +M ON-OFF SWITCH PB3 CHINT 1A BREAKER CB3 TIPO K TERMOCUPLA TC3 6 5 + - 1 4prog + - TRANSMISOR J1 BR1 U3 R2 C1 D2 C2C3

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

GND GND A1 A0 ANALOG IN 4-20mA GND GND DOOR AUX MUFLA RAMPA 2018
