judapies/Mufla/2019/Mufla 1.7L Avantika #004587973 OP201978/Plano Electrico Mufla/PlanoMuflaGLCD_Card.pdf

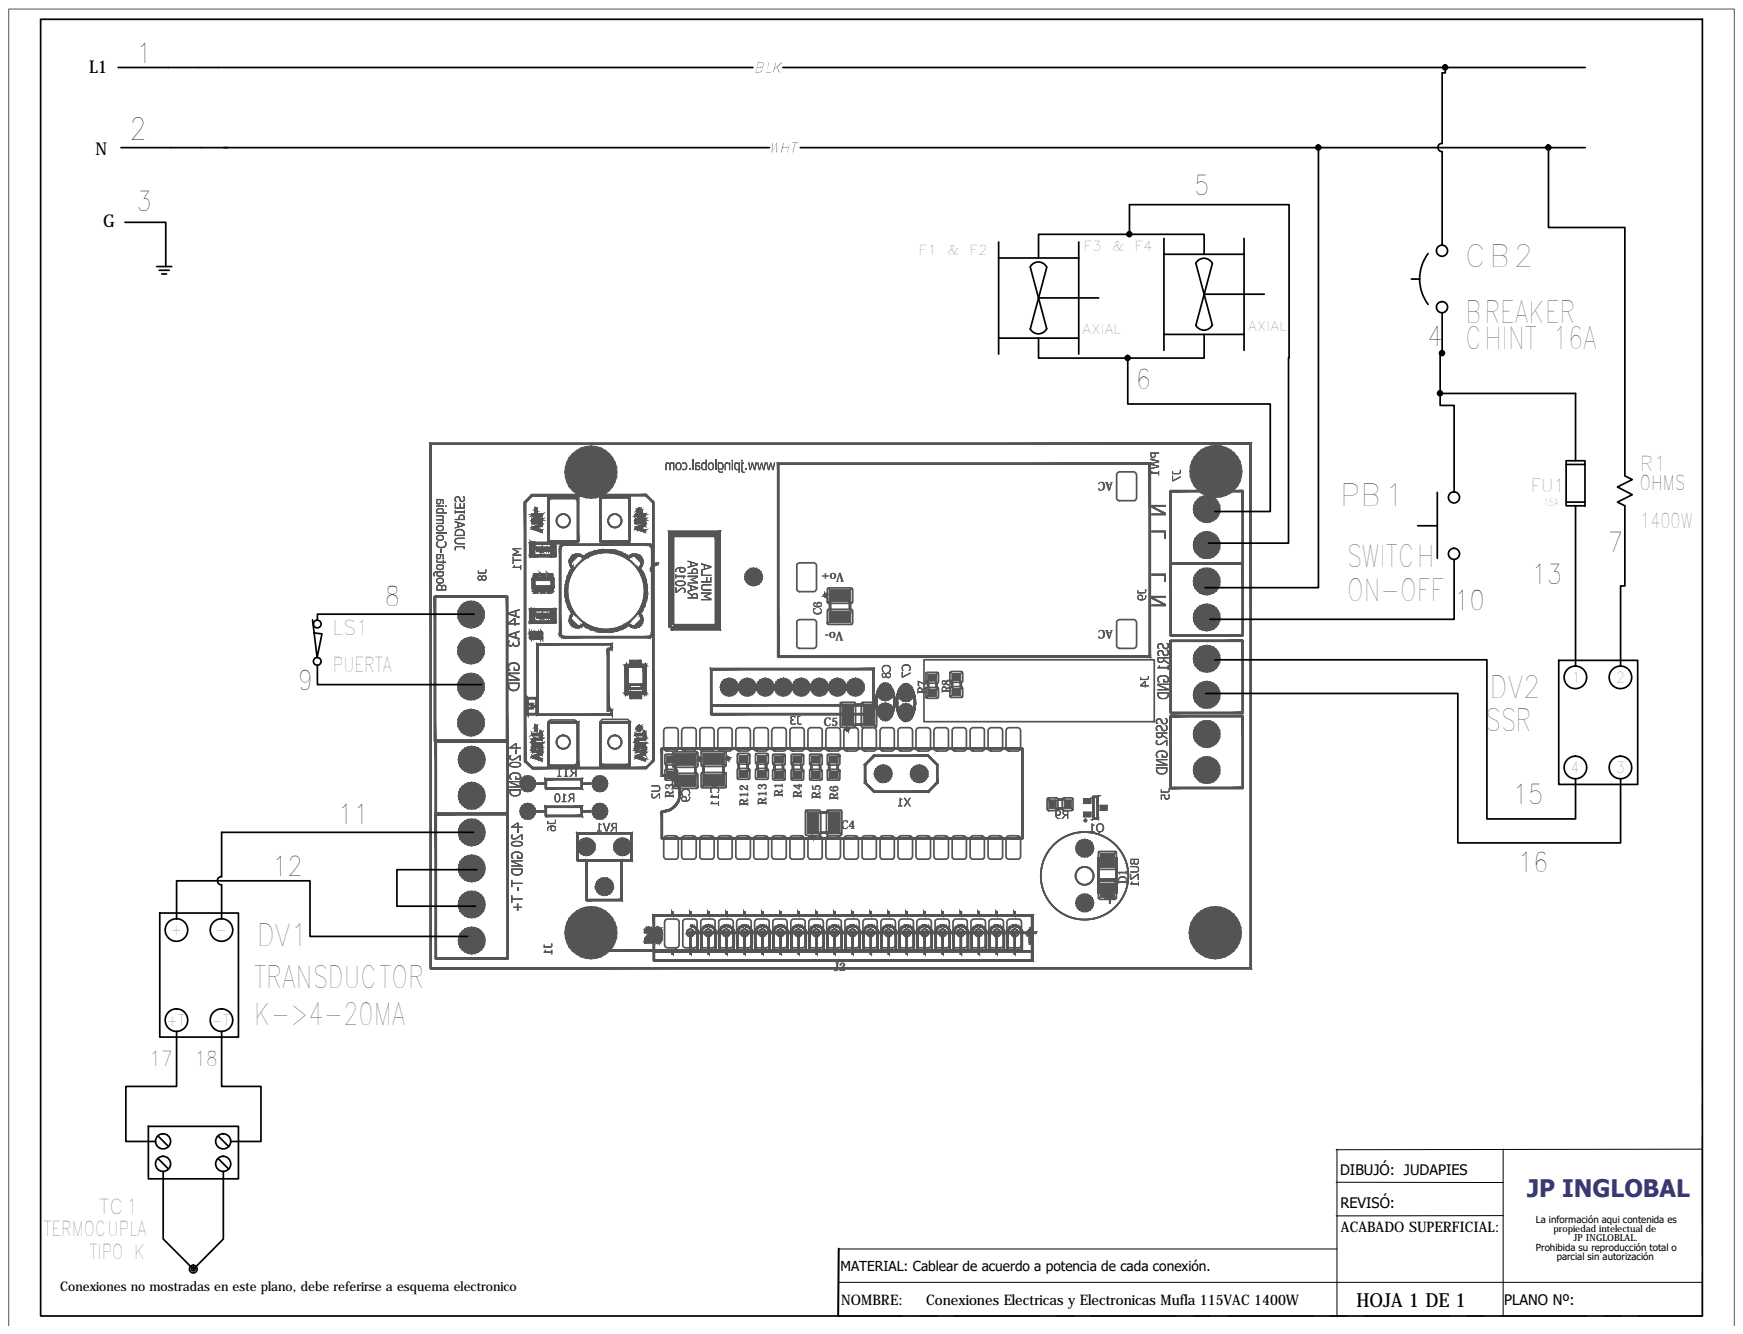
[picture p85: page 1]

C6ON-OFF SWITCH PB1 F1 & F2 AXIAL F3 & F4 AXIAL 1516 PUERTA LS1 8 9 K->4-20MA TRANSDUCTOR DV1 -T + - +T TIPO K TERMOCUPLA TC1 17 18 2 5 6 10 11 12 13
