judapies/Mufla/2020/Mufla 14L Psoc Avantika #004588425 OP2020341/Plano Electrico Mufla/PlanoMuflaTouch_DobleDisplay.pdf

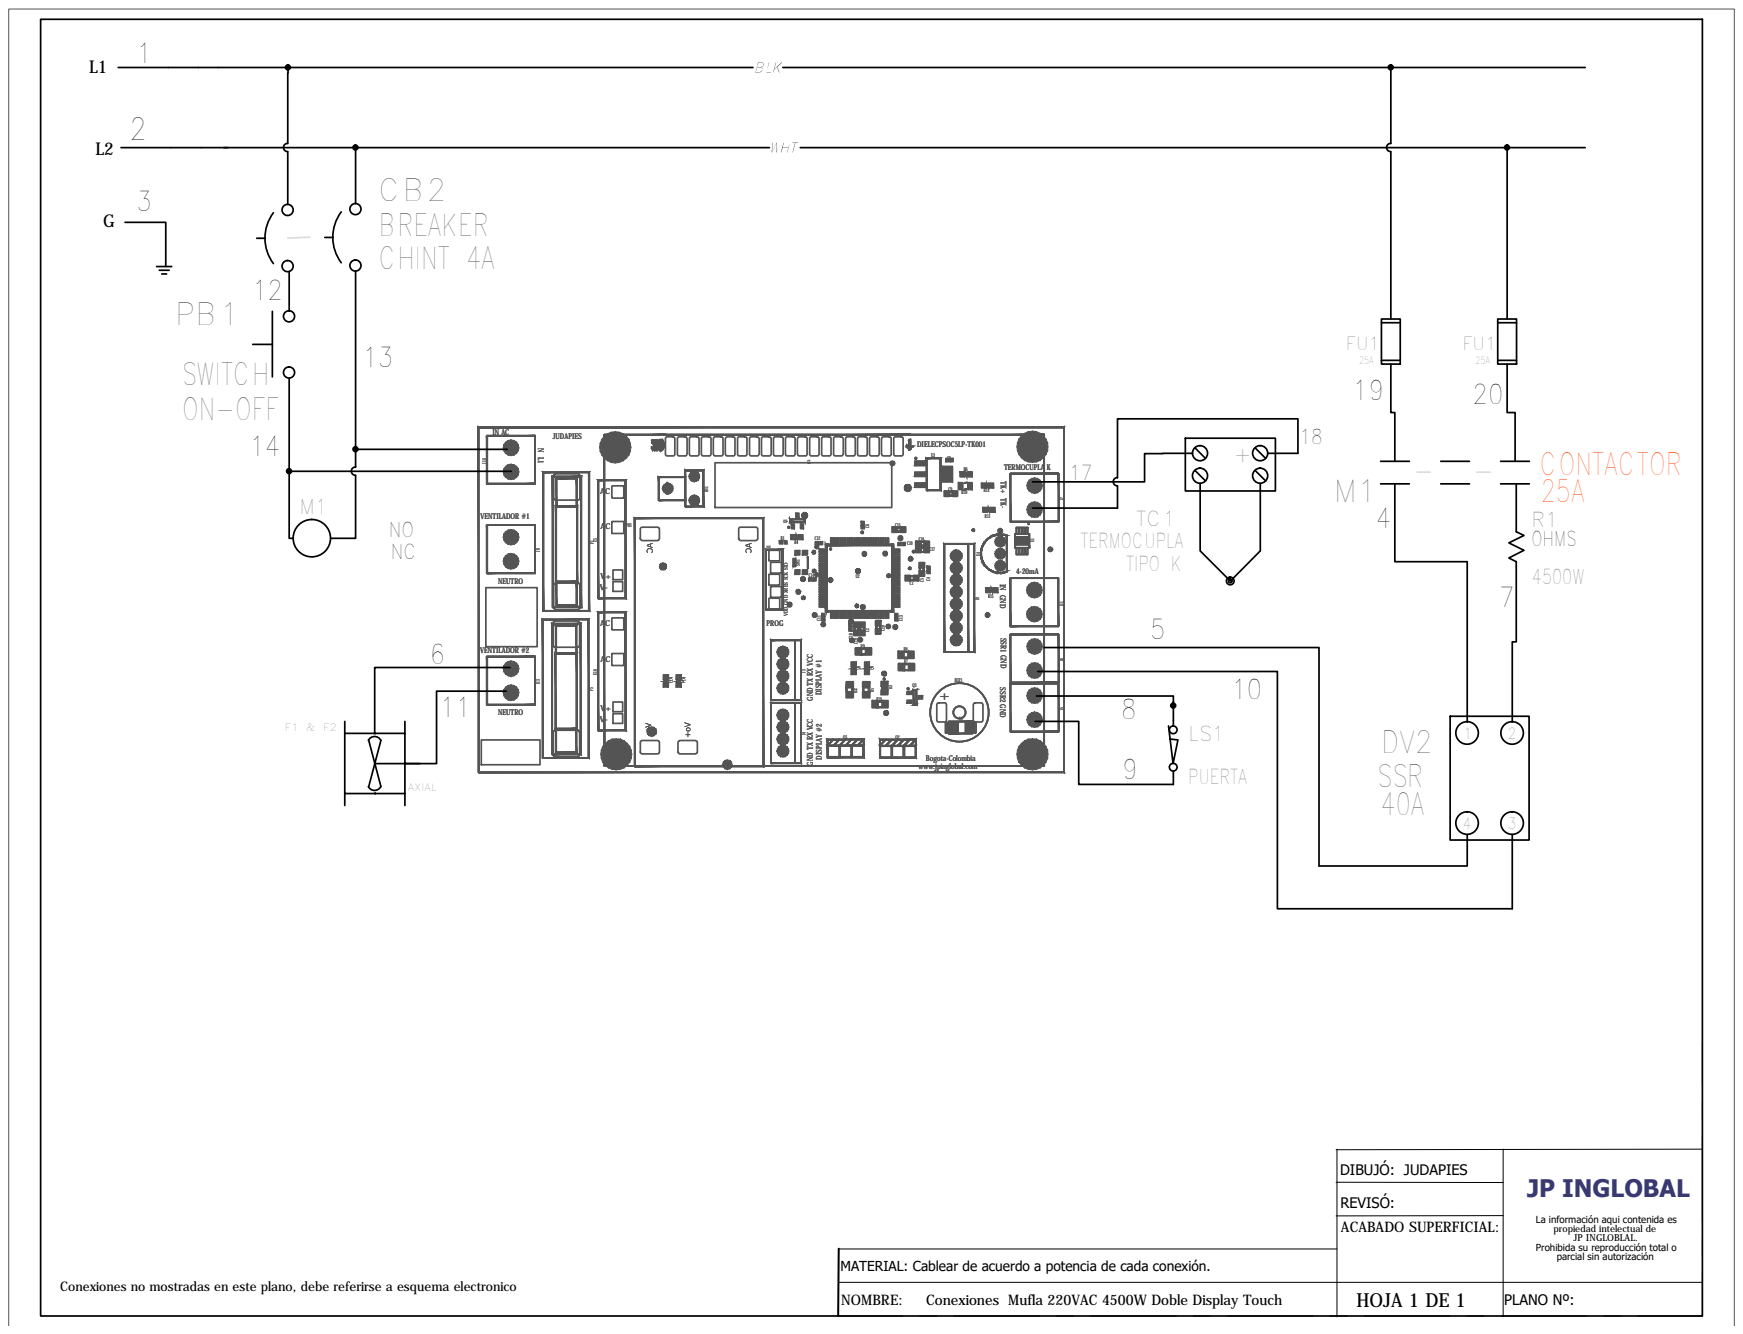
[picture p86: page 1]

VDD GND XRES SCK SIO PROG F1 & F2 AXIAL NCNO M1 PUERTA LS1 98 + TIPO K TERMOCUPLA TC1 18 17 4 611 5 10 13 1412

N L1 IN AC NEUTRO VENTILADOR #1 VENTILADOR #2

D3 R19 JUDAPIES www.jpinglobal.com Bogota-Colombia DIELECPSOC5LP-TK001

VDD GND XRES SCK SIO PROG PW1

SSR1 GND SSR2 GND NEUTRO IN GND 4-20mA

GND TX RX VCC DISPLAY #1 GND TX RX VCC DISPLAY #2
