judapies/Mufla/2021/Mufla 3L Psoc Artilab #0045886XX OP2021128/Modelo/Planos/ENSAMBLE CUERPO PUERTA M 2020-9.5L.pdf

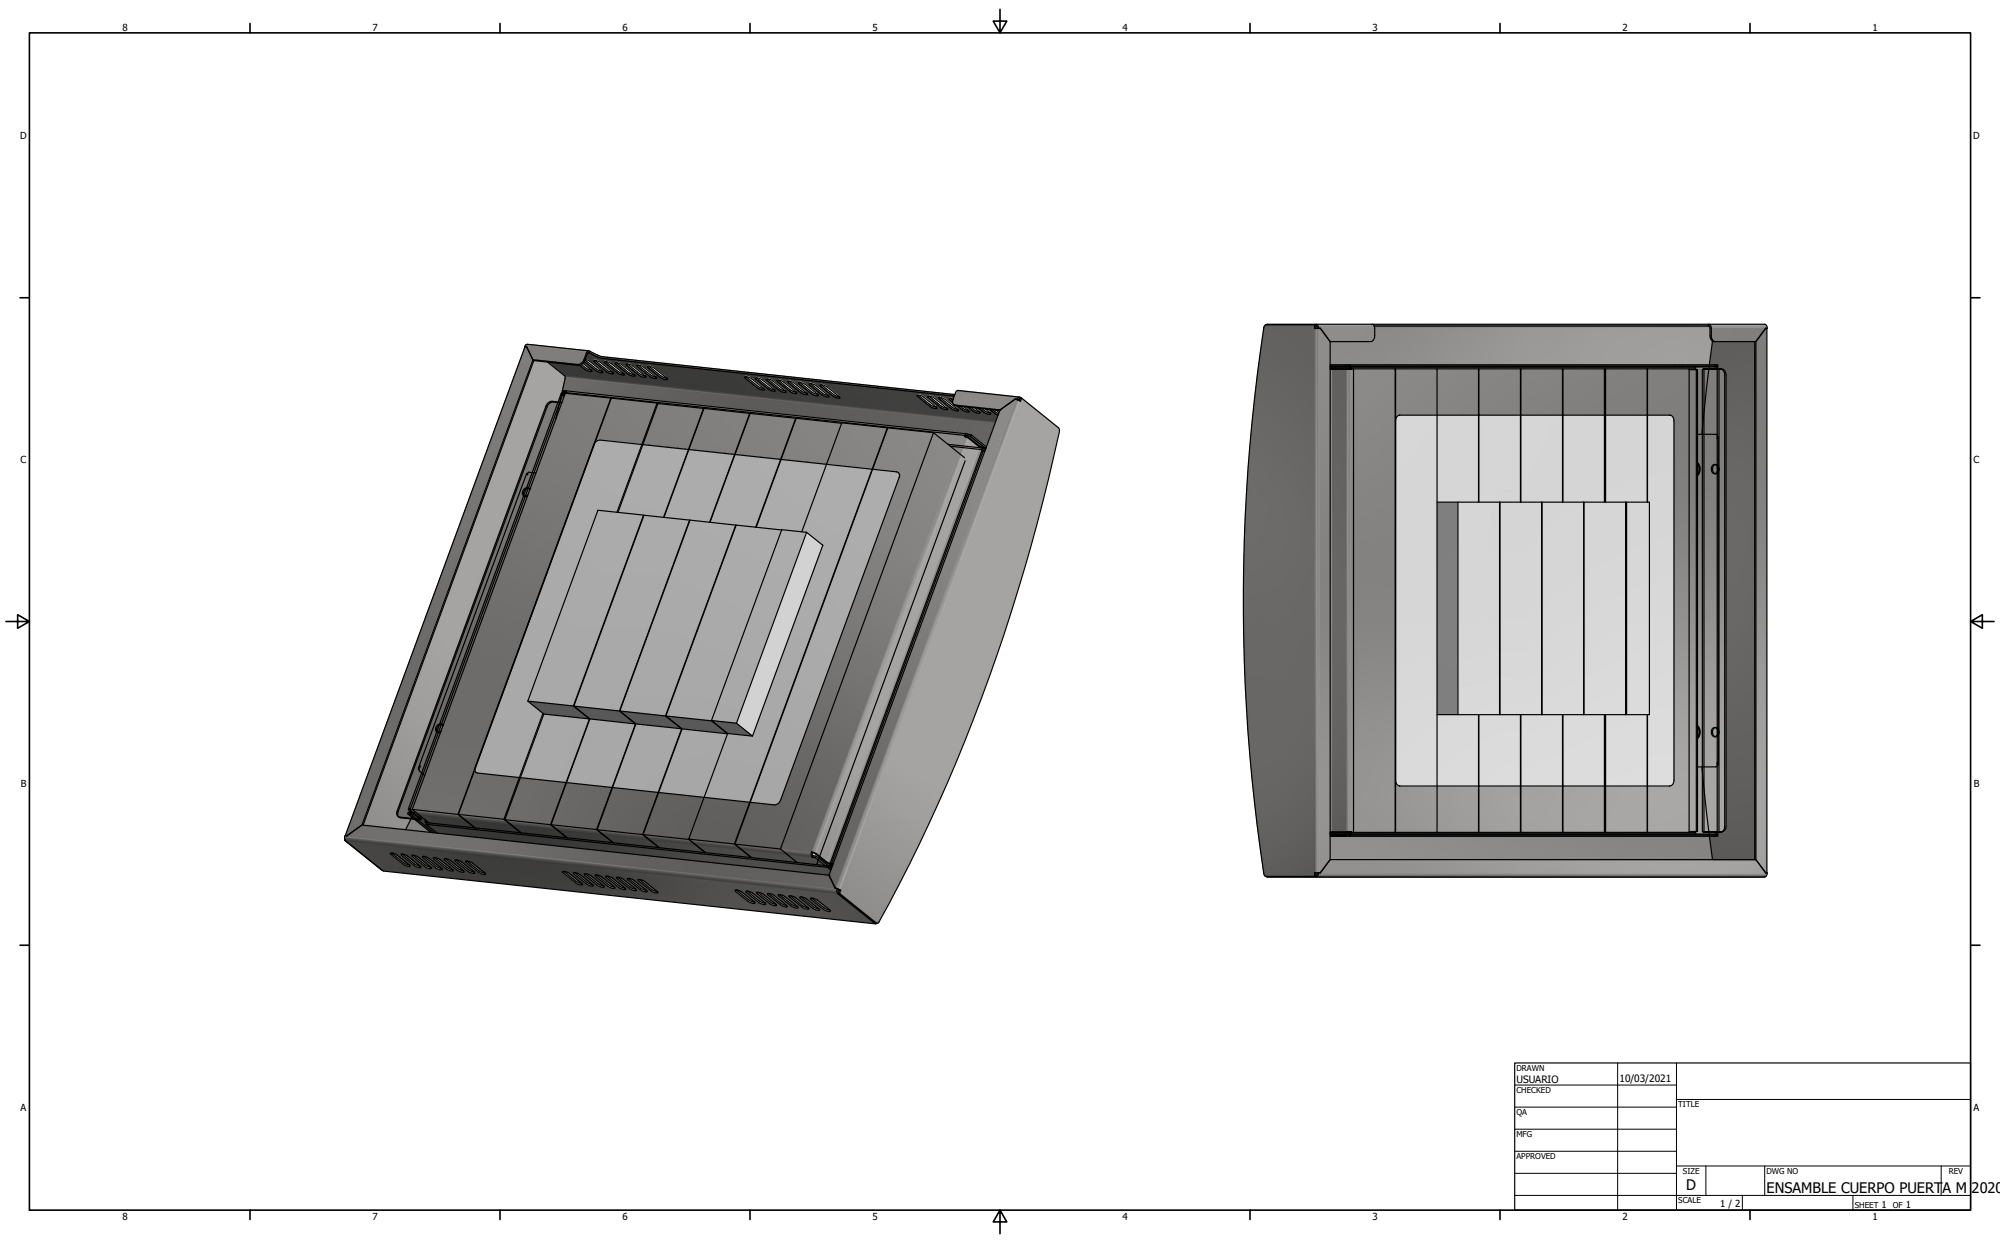
[picture p87: page 1]
SHEET 1 OF 1; DRAWN; CHECKED; MFG; APPROVED; USUARIO; TITLE; SIZE D; SCALE; REV

DWG NO
ENSAMBLE CUERPO PUERTA M 2020-9.5L
