judapies/Mufla/2021/Mufla 3L Psoc Artilab #0045886XX OP2021128/Modelo/Planos/ENSAMBLE PUERTA M 2021-4.5L.pdf

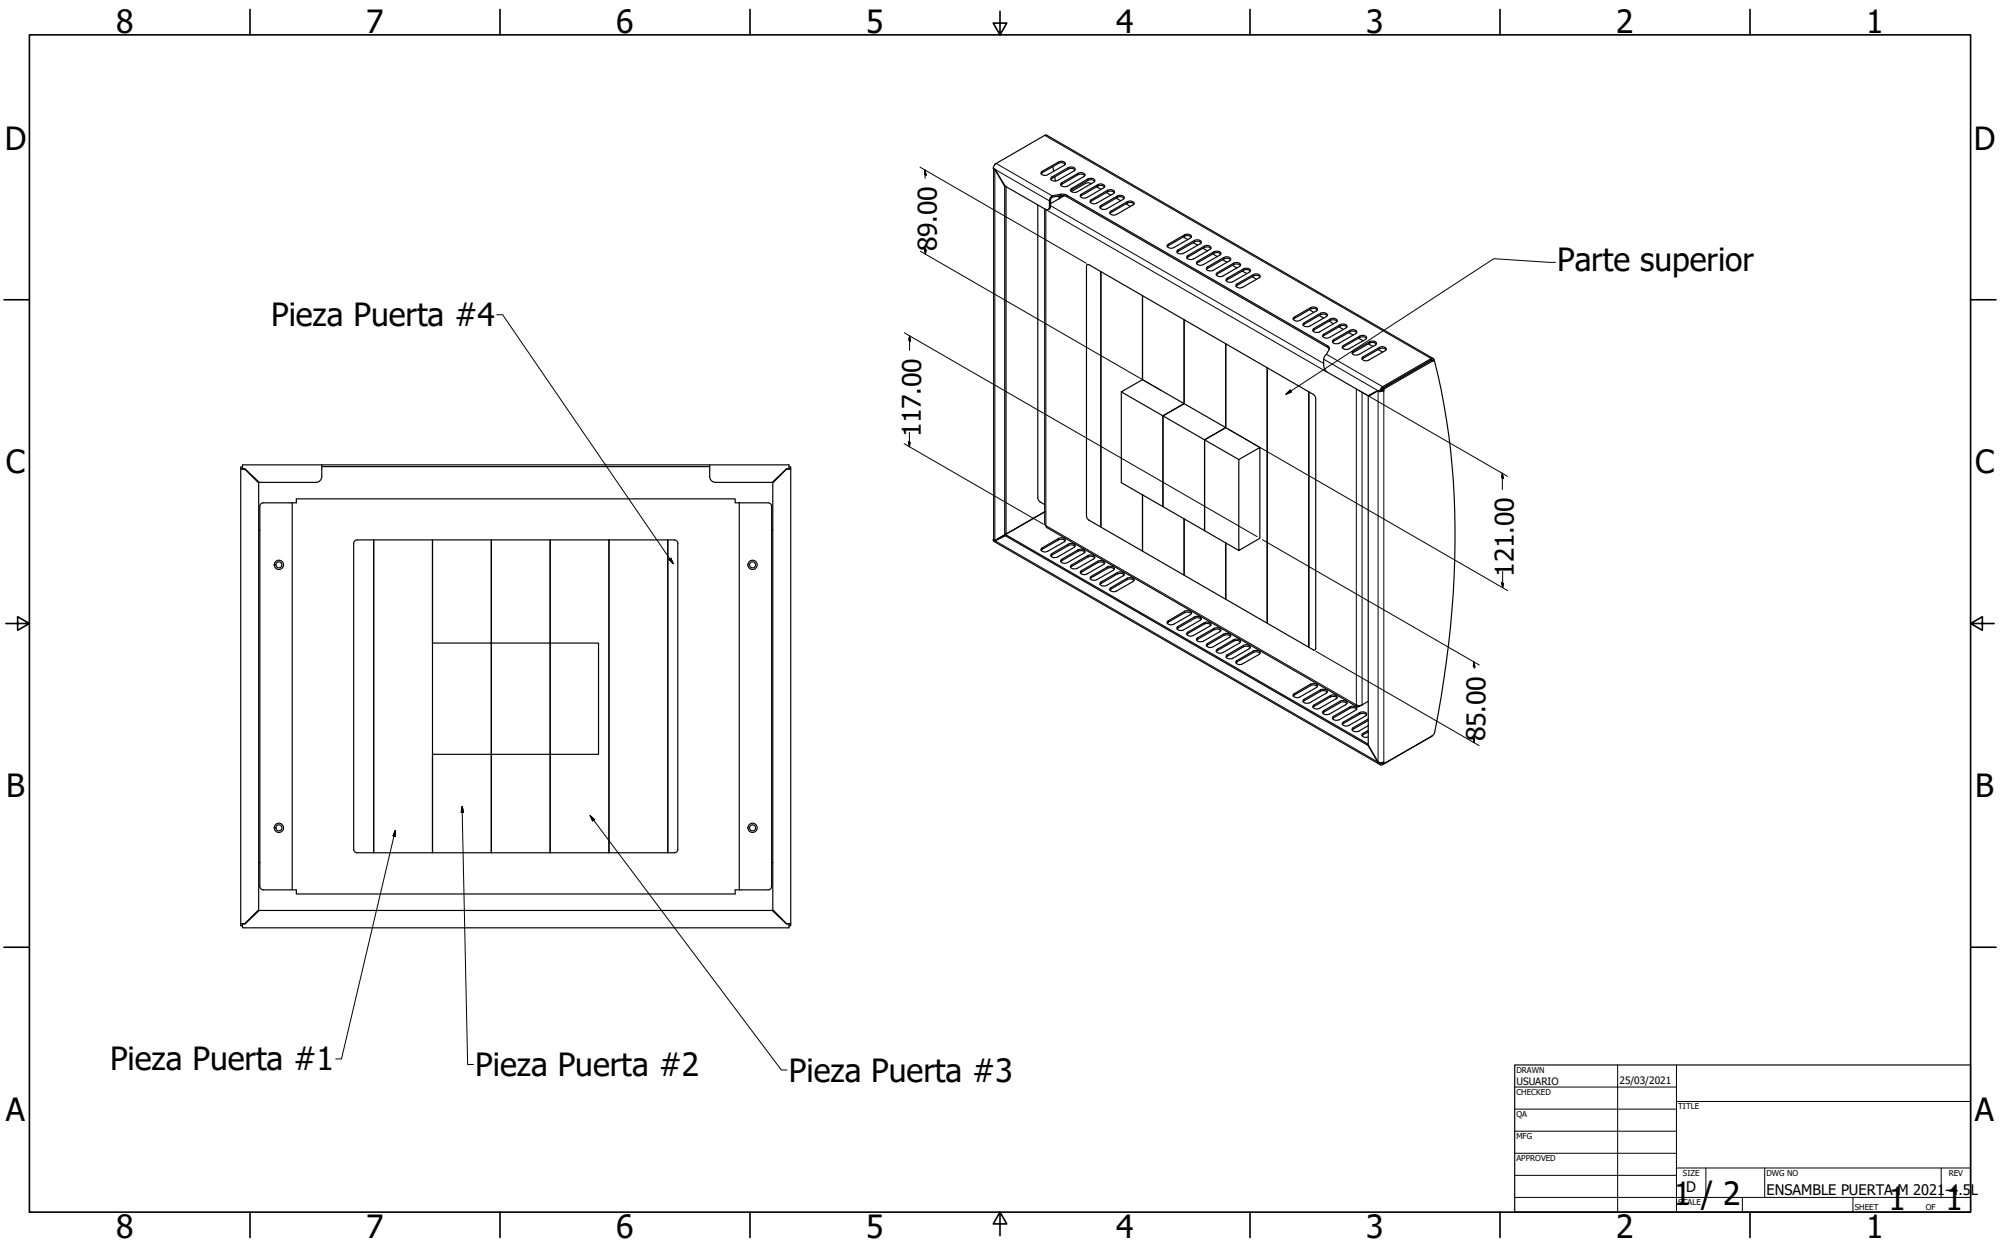
[picture p88: page 1]
SHEET; DRAWN; CHECKED; MFG; APPROVED; USUARIO; DWG NO ENSAMBLE PUERTA M 2021-4.5L; TITLE; SIZE D; SCALE; REV; Parte superior; Pieza Puerta #1; Pieza Puerta #2; Pieza Puerta #3; Pieza Puerta #4
