judapies/Mufla/2021/Mufla 3L Psoc Artilab #0045886XX OP2021128/Modelo/Planos/EnsambleAislante.pdf

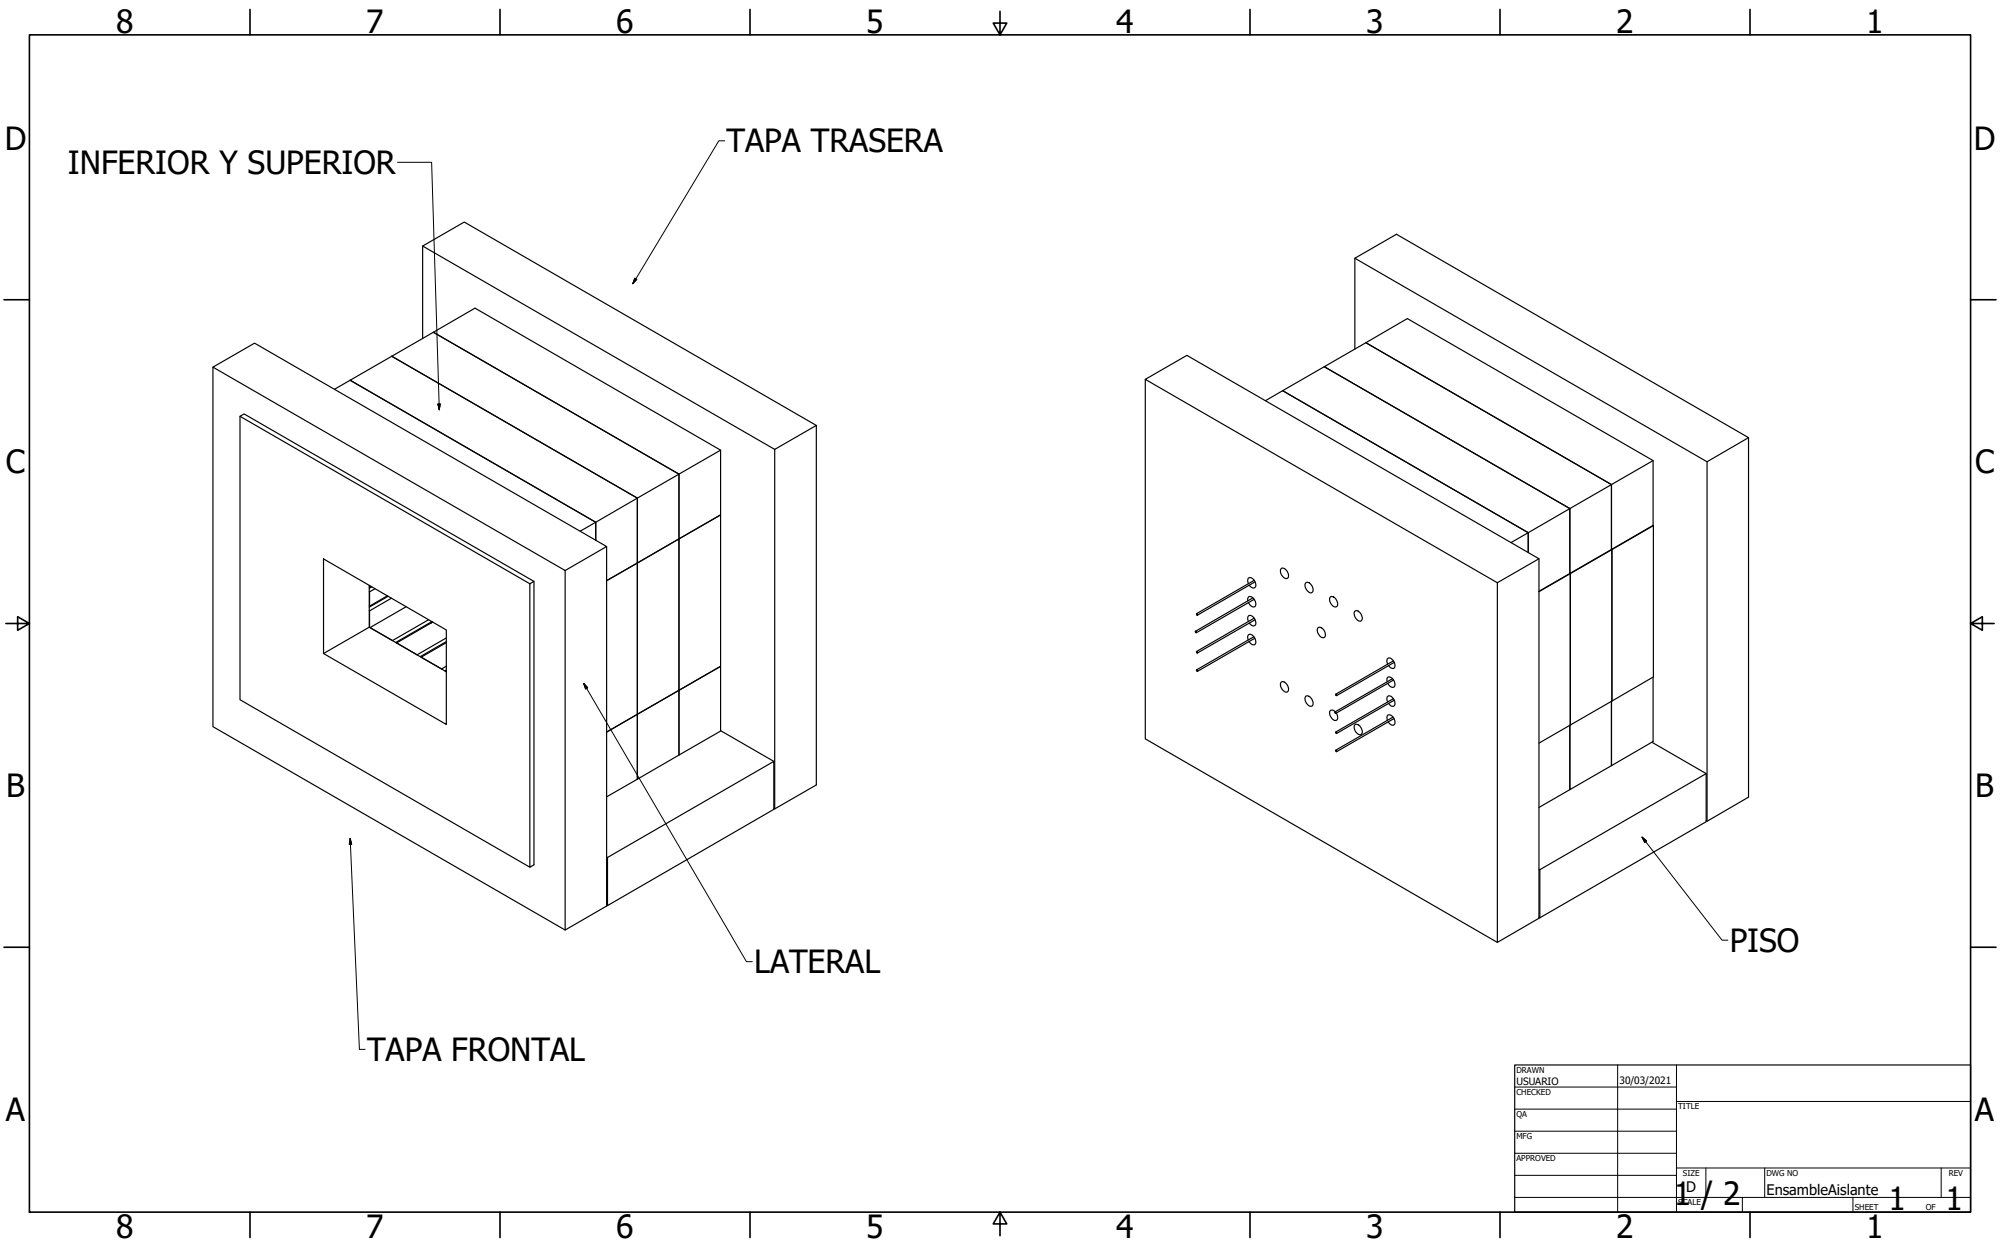
[picture p89: page 1]
SHEET; DRAWN; CHECKED; MFG; APPROVED; USUARIO; DWG NO EnsambleAislante; TITLE; SIZE D; SCALE; REV; TAPA TRASERA; TAPA FRONTAL; LATERAL; INFERIOR Y SUPERIOR; PISO
