judapies/Mufla/2021/Mufla 3L Psoc Artilab #0045886XX OP2021128/Modelo/Planos/EnsambleResistencia.pdf

1

2

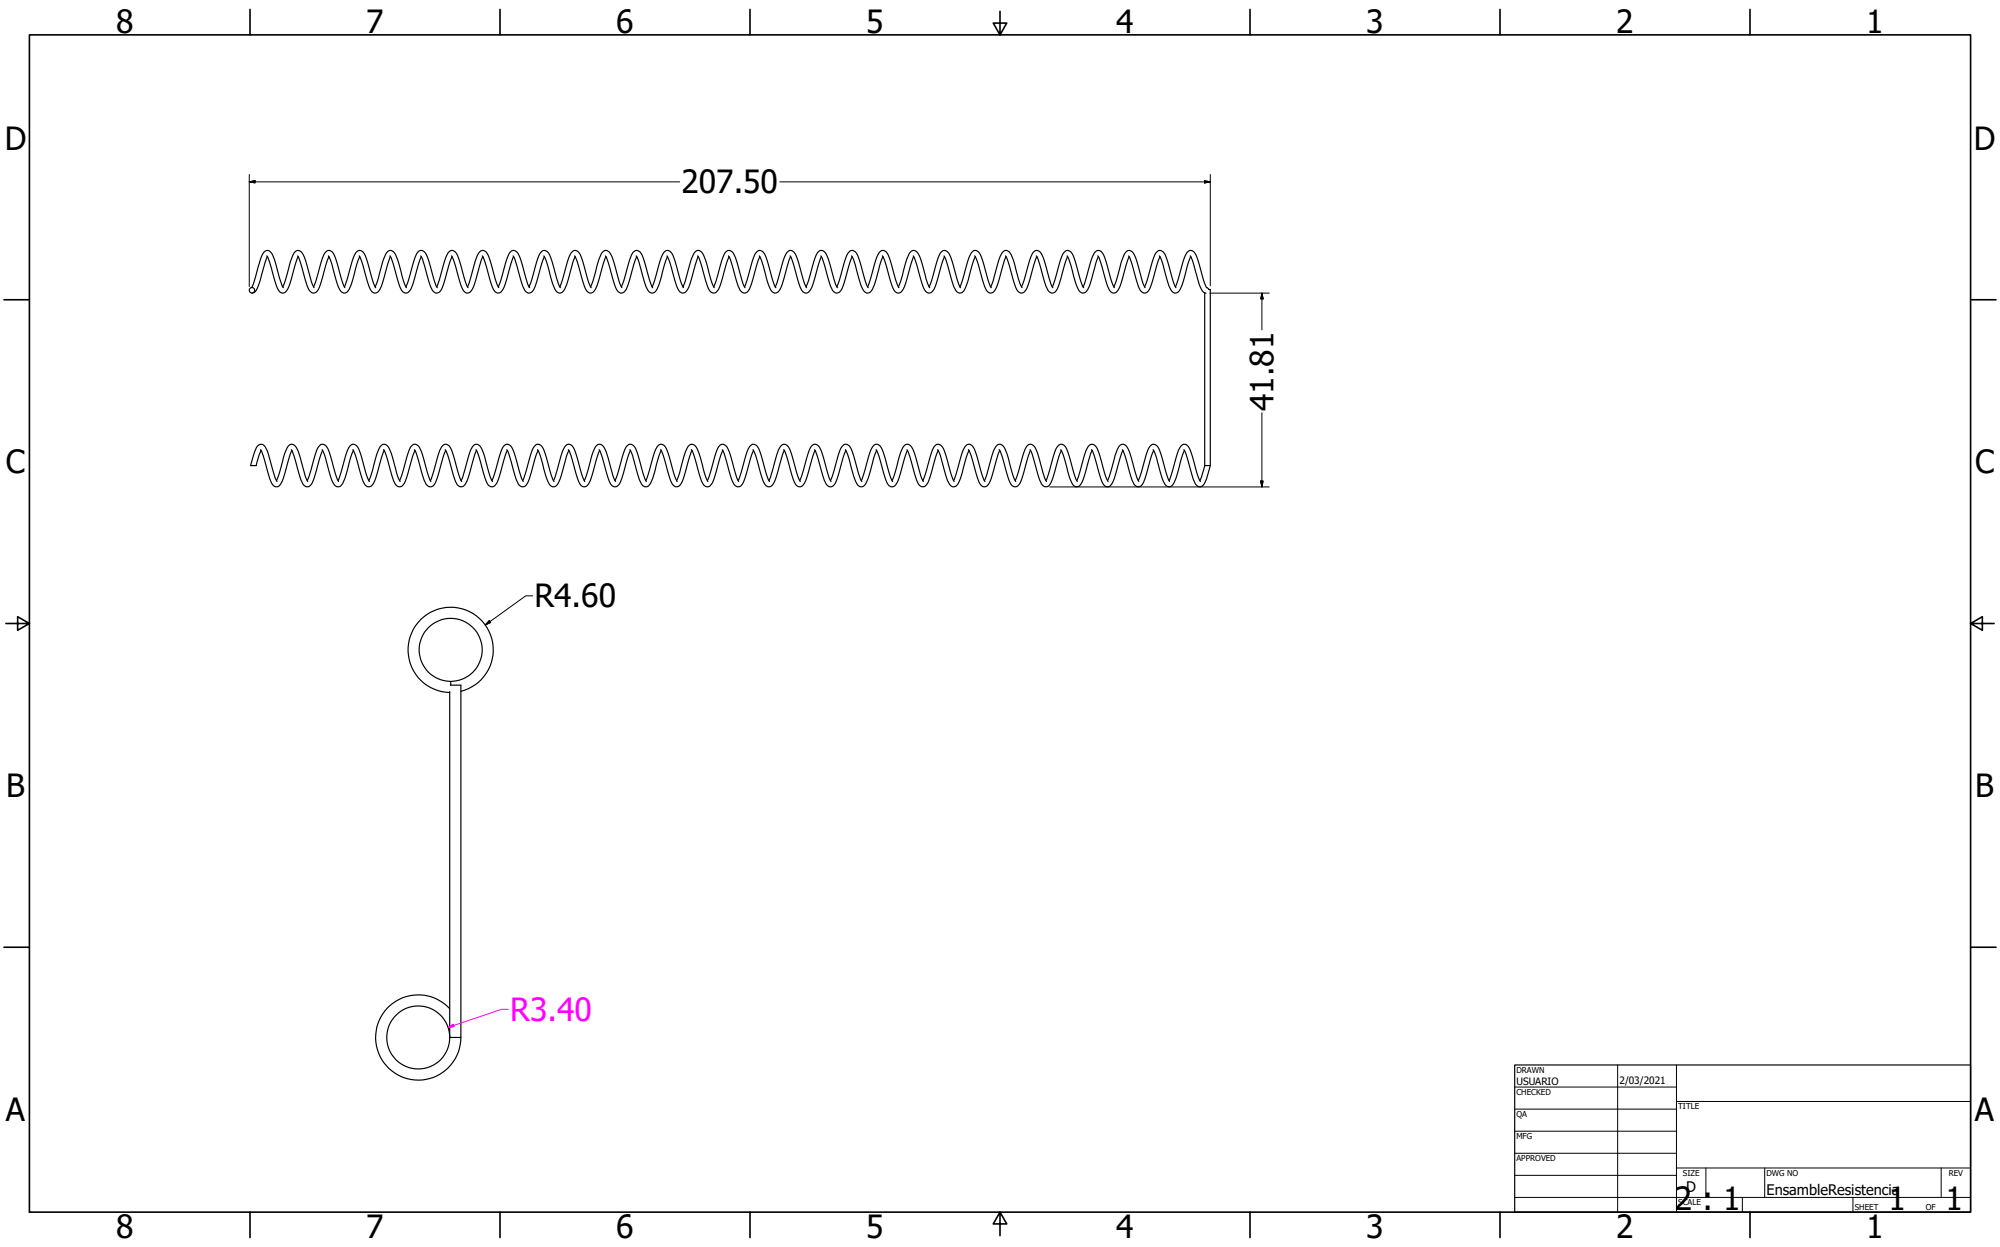
[picture p90: page 1]
SHEET; DRAWN; CHECKED; MFG; APPROVED; USUARIO; DWG NO EnsambleResistencia; TITLE; SIZE D; SCALE; REV
