judapies/Mufla/2021/Mufla 9L Psoc Artilab #004588512 OP202139/Modelo/Planos/EnsambleAislante.pdf

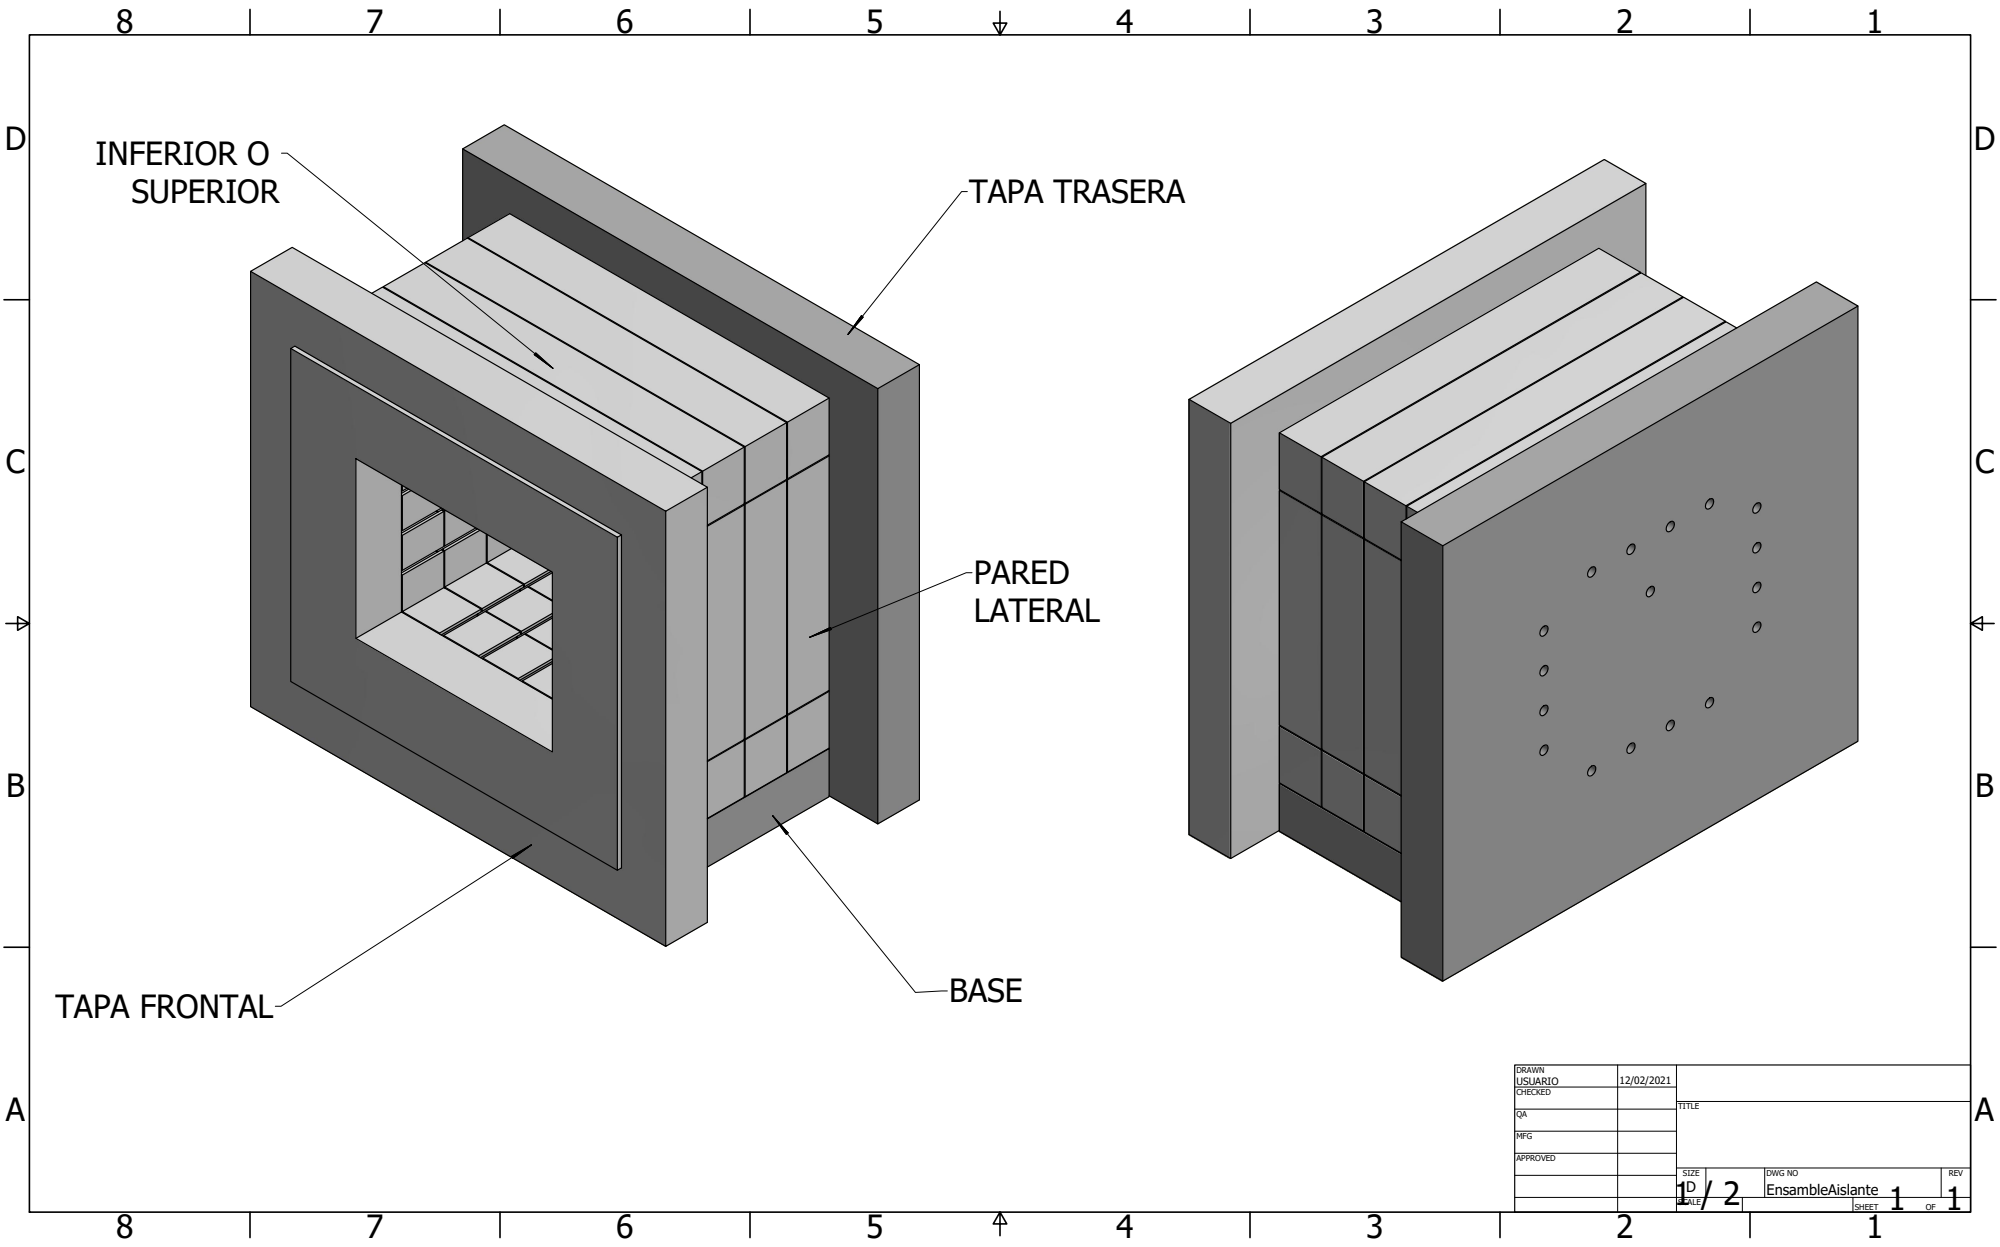
[picture p91: page 1]
SHEET; DRAWN; CHECKED; MFG; APPROVED; USUARIO; DWG NO EnsambleAislante; TITLE; SIZE D; SCALE; REV; BASE; TAPA TRASERA; TAPA FRONTAL; PARED LATERAL; INFERIOR O SUPERIOR
