judapies/Mufla/2019/Mufla 16L Avantika #004588073 OP2019142/Plano Electrico Mufla/PlanoMuflaGLCD_Card_220V_OTC.pdf

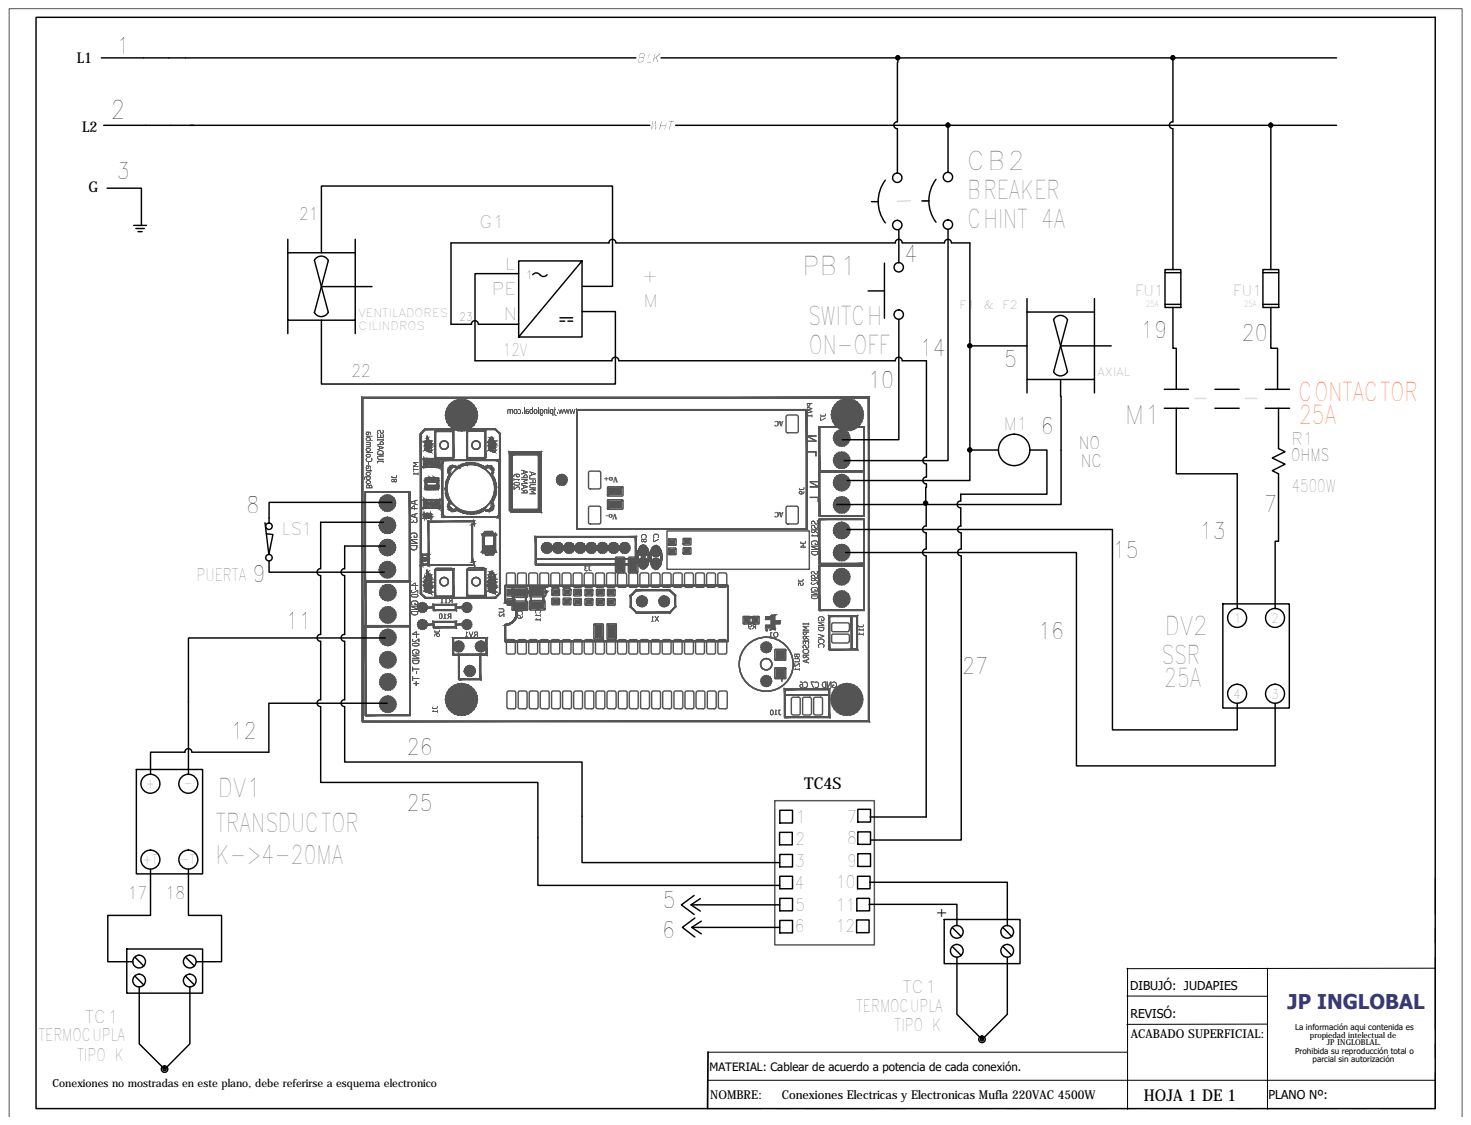
[picture p92: page 1]
