judapies/Mufla/2019/Mufla 16L Avantika #004588073 OP2019142/Plano Electrico Mufla/PlanoMuflaGLCD_Card_Impresora220V.pdf

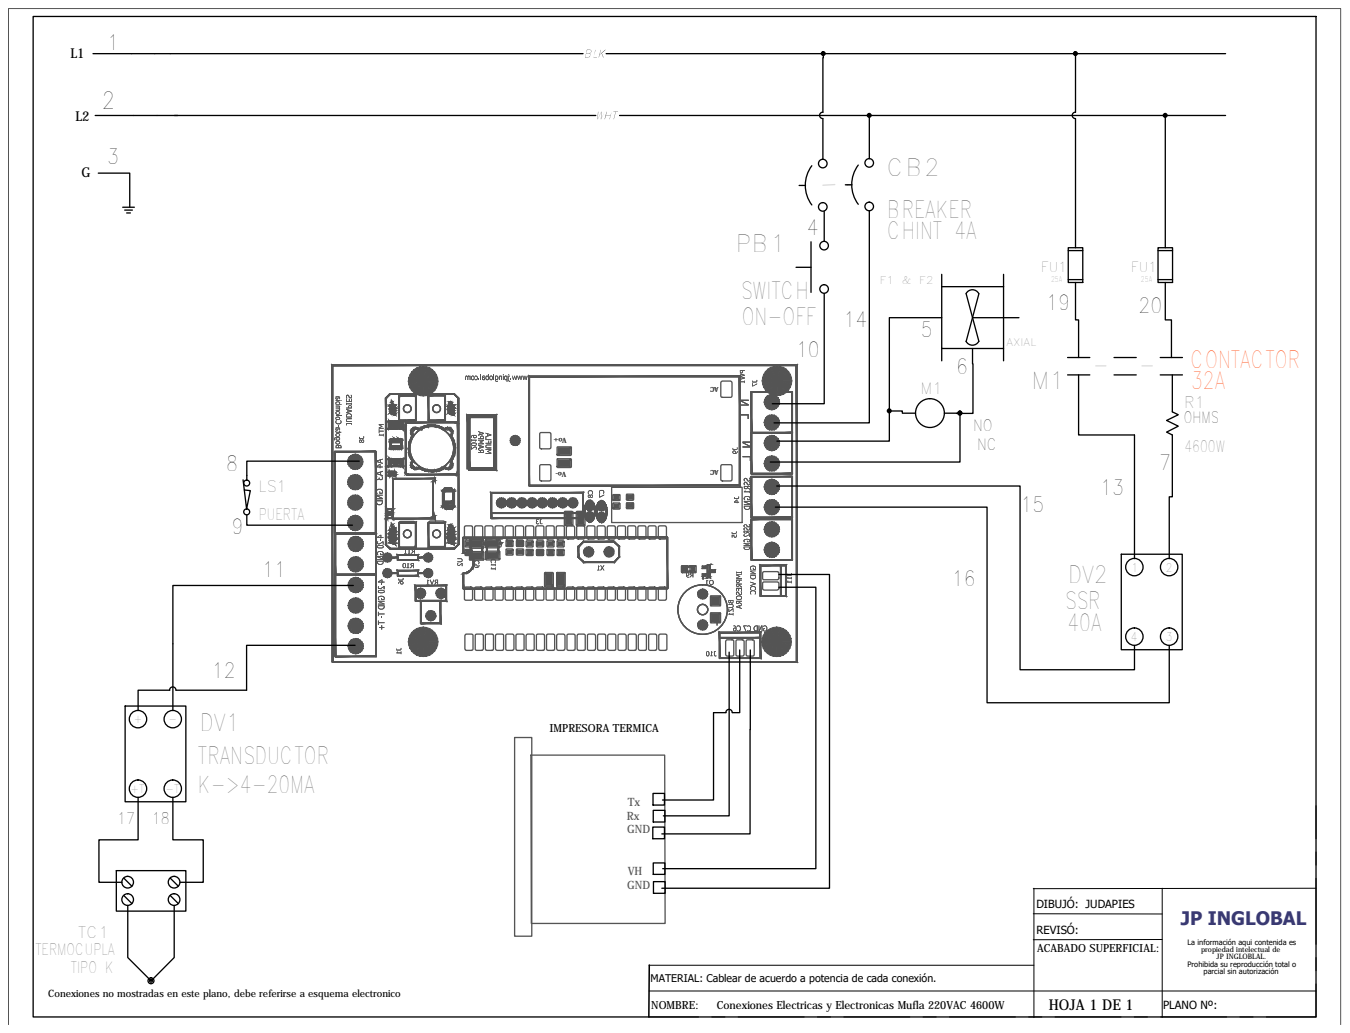
[picture p93: page 1]
