judapies/Mufla/2020/Mufla 14L Avantika #004588239 OP2020144/Plano Electrico Mufla/PlanoMuflaGLCD_Card_115V.pdf

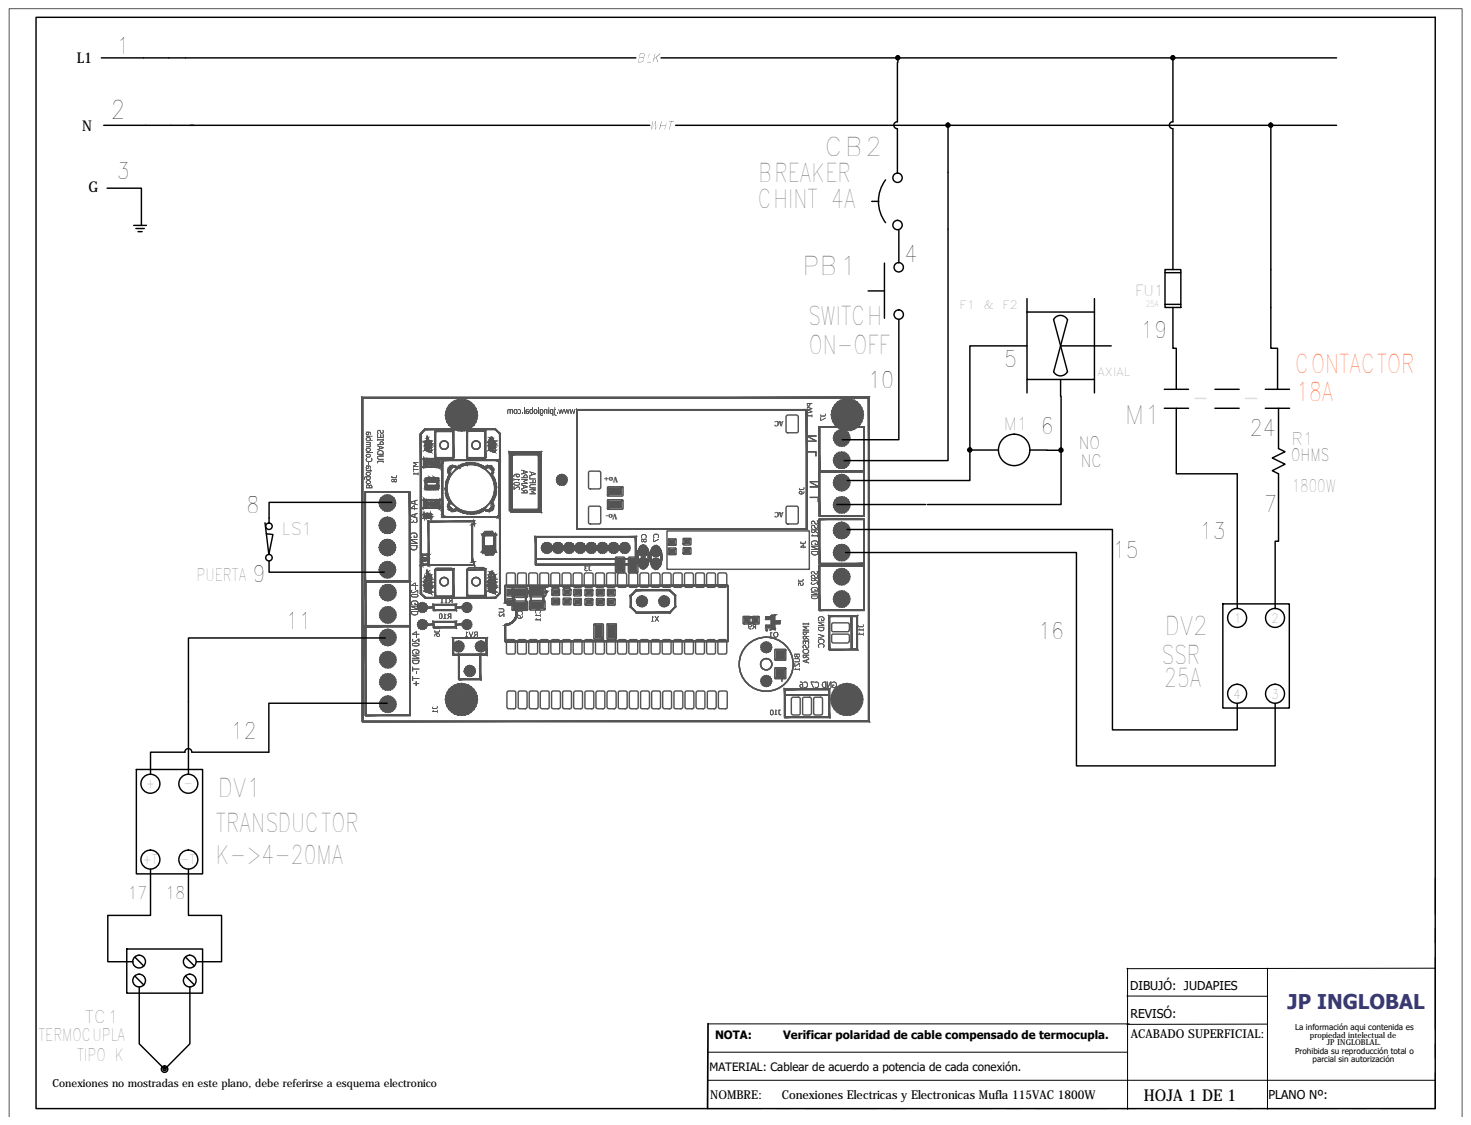
[picture p94: page 1]
