judapies/Mufla/2020/Mufla 2.2L Avantika #004588378-79 OP202094-95/Plano Electrico Mufla/PlanoMuflaGLCD_Card_115V_I2C.pdf

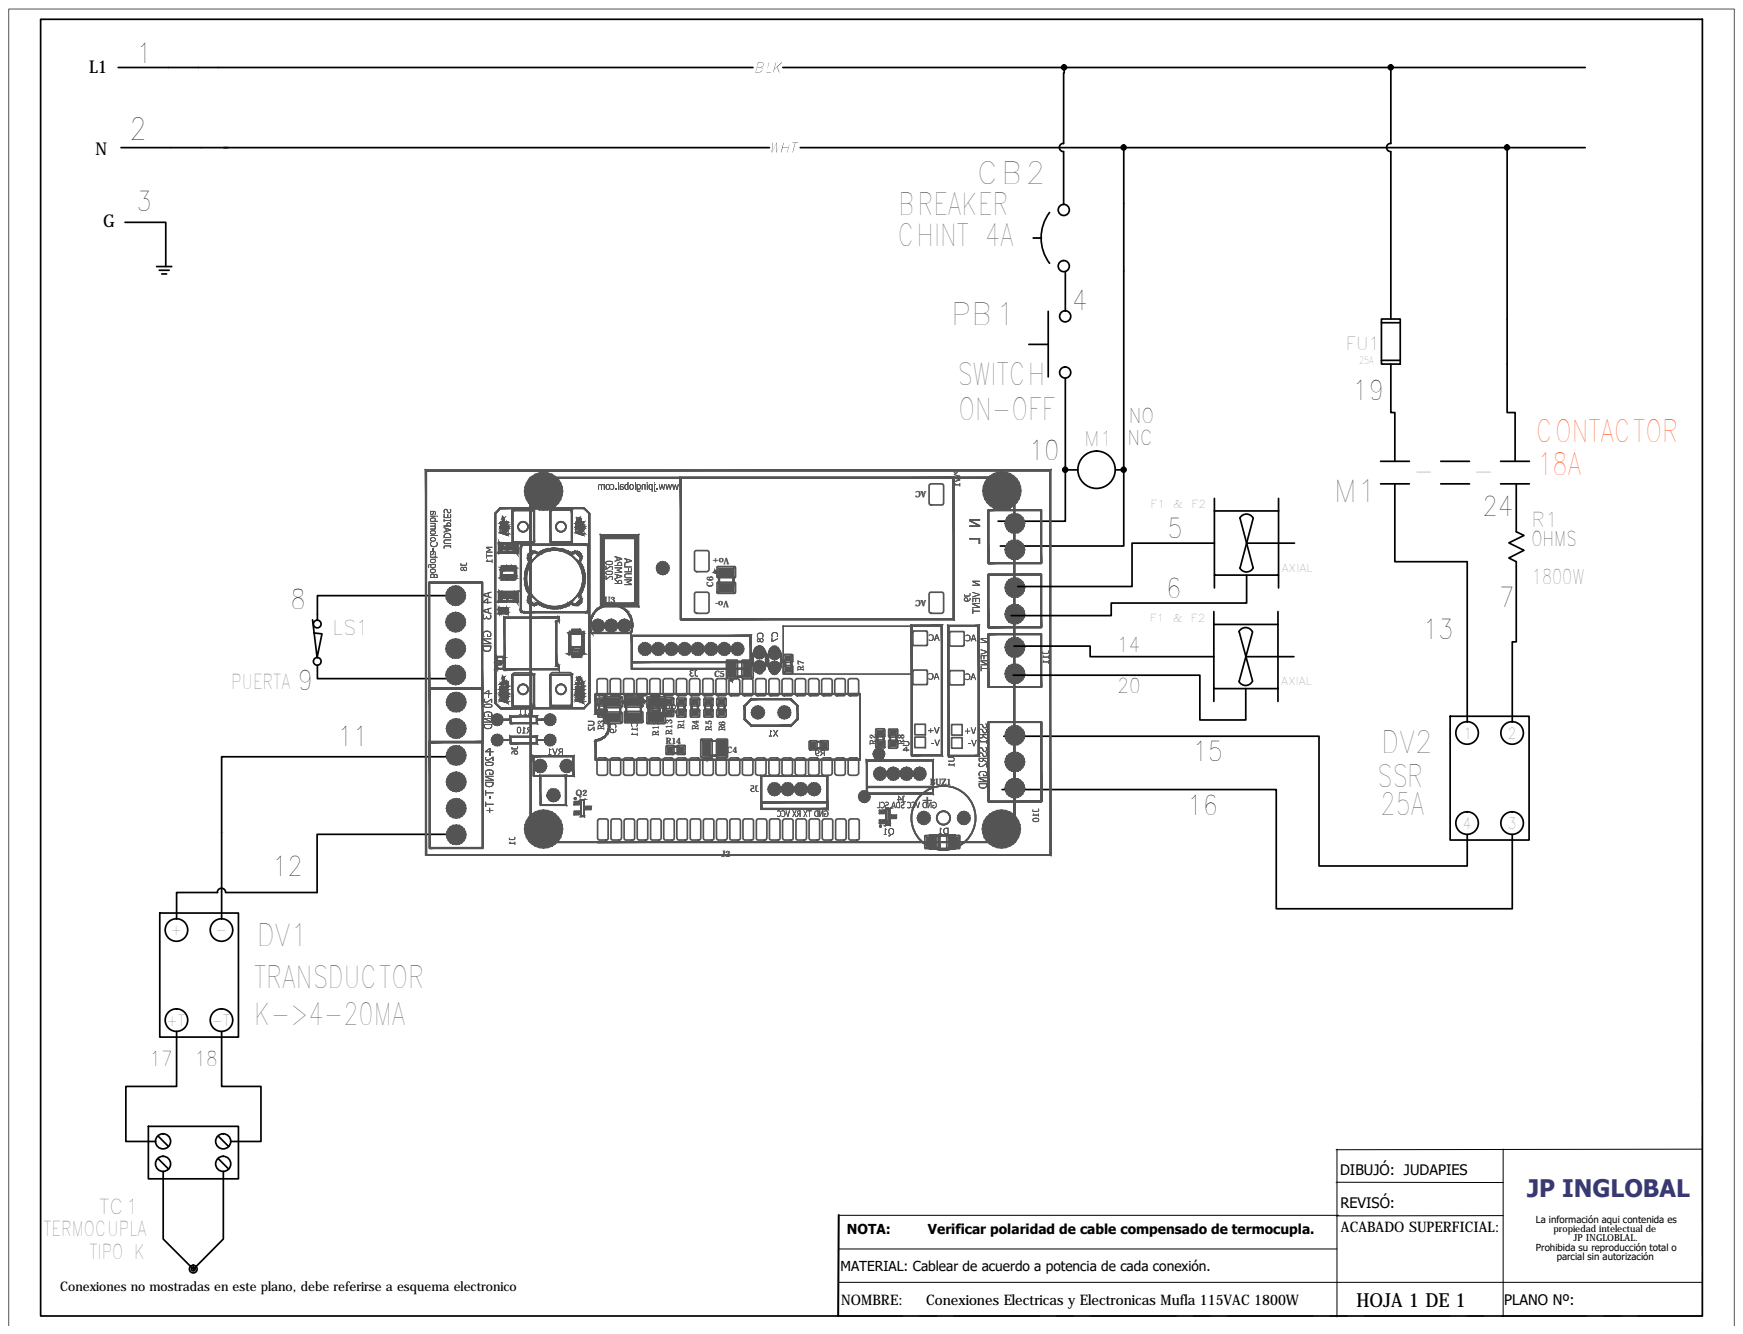
[picture p95: page 1]
