judapies/Mufla/(list of files, drawings)

Other design files:
2018/Mufla 3L Avantika #004587835/Schematic/Mufla.pdsprj
2018/Mufla 14L Artilab #004587922/Schematic/Mufla.pdsprj
2018/Mufla 27L Artilab #004587921/Schematic/Mufla.pdsprj
2018/Mufla Avantika #004587751/Schematic/Mufla.pdsprj
2018/Mufla Avantika #004587752/Schematic/Mufla.pdsprj
2019/Horno Tubular #004587931/Schematic/Mufla.pdsprj
2019/Mufla 1.7L Avantika #004587973 OP201978/Schematic/Mufla.pdsprj
2019/Mufla 2.2L Artilab #0045880XX OP2019151/Schematic/Mufla.pdsprj
2019/Mufla 3L Avantika #004587981 OP201983/Schematic/Mufla.pdsprj
2019/Mufla 3L Blamis #004588005 OP2019130/Schematic/Mufla.pdsprj
2019/Mufla 4L Artilab #004588010 OP2019132/Schematic/Mufla.pdsprj
2019/Mufla 9L Artilab #004588000 OP2019109/Schematic/Mufla_Impresora.pdsprj
2019/Mufla 16L Avantika #004588073 OP2019142/Schematic/Mufla.pdsprj
2019/Mufla 16L Avantika #004588074 OP2019143/Schematic/Mufla.pdsprj
2019/Mufla 27L Artilab #004587999 OP2019131/Schematic/Mufla.pdsprj
2020/Mufla 2.2L Avantika #004588378-79 OP202094-95/Schematic/MuflaI2C.pdsprj
2020/Mufla 2.2L Psoc Avantika #004588419 OP2020346/Schematic USB Com/USB_I2C.pdsprj
2020/Mufla 2.2L Psoc Avantika #004588419 OP2020346/Schematic/PsocBoardTQFP.pdsprj
2020/Mufla 4L Artilab #004588090 OP2019208/Schematic/Mufla.pdsprj
2020/Mufla 4L Suministros 724 #004588086 OP202054/Schematic/Mufla.pdsprj
2020/Mufla 9L Psoc Artilab #004588456 OP2020376/Schematic V2/PsocBoardTQFP.pdsprj
2020/Mufla 9L Psoc Artilab #004588456 OP2020376/Schematic/PsocBoardTQFP.pdsprj
2020/Mufla 14L Avantika #004588239 OP2020144/Schematic/MuflaI2C.pdsprj
2020/Mufla 14L Psoc Avantika #004588425 OP2020341/Schematic USB Com/USB_I2C.pdsprj
2020/Mufla 14L Psoc Avantika #004588425 OP2020341/Schematic/PsocBoardTQFP.pdsprj
2020/Mufla 14L Touch Avantika #004588248 OP202019/Schematic USB Com/USB_I2C.pdsprj
2020/Mufla 14L Touch Avantika #004588248 OP202019/Schematic/PsocBoardTQFP.pdsprj
2021/Mufla 3L Psoc Artilab #0045886XX OP2021128/Schematic V2/PsocBoardTQFP.pdsprj
2021/Mufla 3L Psoc Artilab #0045886XX OP2021128/Schematic/PsocBoardTQFP.pdsprj
2021/Mufla 4.5L Psoc MYC Lab #004588559 OP202145/Schematic V2/PsocBoardTQFP.pdsprj
2021/Mufla 4.5L Psoc MYC Lab #004588559 OP202145/Schematic/PsocBoardTQFP.pdsprj
2021/Mufla 9L Psoc Artilab #004588512 OP202139/Schematic V2/PsocBoardTQFP.pdsprj
2021/Mufla 9L Psoc Artilab #004588512 OP202139/Schematic/PsocBoardTQFP.pdsprj
