judapies/Mufla/2020/Mufla 14L Psoc Avantika #004588425 OP2020341/Firmware Psoc V/LCD2/MuflaGLCD.cydsn/ks0108.c

#include "ks0108.h"
#include "project.h"
#include <device.h>
#include <stdio.h>
#include <main.h>

/////////////////////////////////////////////////////////////////////////
//// Defines a 5x7 font
/////////////////////////////////////////////////////////////////////////
const int8 FONT[51][5] ={0x00, 0x00, 0x00, 0x00, 0x00, // SPACE
                         0x00, 0x00, 0x5F, 0x00, 0x00, // !
                         0x00, 0x03, 0x00, 0x03, 0x00, // "
                         0x14, 0x3E, 0x14, 0x3E, 0x14, // #
                         0x24, 0x2A, 0x7F, 0x2A, 0x12, // $
                         0x43, 0x33, 0x08, 0x66, 0x61, // %
                         0x36, 0x49, 0x55, 0x22, 0x50, // &
                         0x00, 0x05, 0x03, 0x00, 0x00, // '
                         0x00, 0x1C, 0x22, 0x41, 0x00, // (
                         0x00, 0x41, 0x22, 0x1C, 0x00, // )
                         0x14, 0x08, 0x3E, 0x08, 0x14, // *
                         0x08, 0x08, 0x3E, 0x08, 0x08, // +
                         0x00, 0x50, 0x30, 0x00, 0x00, // ,
                         0x08, 0x08, 0x08, 0x08, 0x08, // -
                         0x00, 0x60, 0x60, 0x00, 0x00, // .
                         0x20, 0x10, 0x08, 0x04, 0x02, // /
                         0x3E, 0x51, 0x49, 0x45, 0x3E, // 0
                         0x00, 0x04, 0x02, 0x7F, 0x00, // 1
                         0x42, 0x61, 0x51, 0x49, 0x46, // 2
                         0x22, 0x41, 0x49, 0x49, 0x36, // 3
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
0x00, 0x00, 0x00, 0x00, 0x00, 0x00, 0x00, 0x00, 0x00, 0x00, 0x00, 0x00, 0x00, 0x00, 0x00, 0x00,
0x01, 0x80, 0x00, 0x00, 0x00, 0x00, 0x00, 0x00, 0x00, 0x00, 0x00, 0x00, 0x00, 0x00, 0x00, 0x00,
0x02, 0x40, 0x00, 0x00, 0x00, 0x00, 0x00, 0x00, 0x00, 0x00, 0x00, 0x00, 0x00, 0x00, 0x00, 0x00,
0x02, 0x70, 0x00, 0x00, 0x00, 0x00, 0x00, 0x00, 0x00, 0x00, 0x00, 0x00, 0x00, 0x00, 0x00, 0x00,
0x02, 0x40, 0x00, 0x00, 0x00, 0x00, 0x00, 0x00, 0x00, 0x00, 0x00, 0x00, 0x00, 0x00, 0x00, 0x00,
0x03, 0xC0, 0x00, 0x00, 0x00, 0x00, 0x00, 0x00, 0x00, 0x00, 0x00, 0x00, 0x00, 0x00, 0x00, 0x00,
0x03, 0xF0, 0x00, 0x00, 0x00, 0x00, 0x00, 0x00, 0x00, 0x00, 0x00, 0x00, 0x00, 0x00, 0x00, 0x00,
0x03, 0xC0, 0x00, 0x00, 0x00, 0x00, 0x00, 0x00, 0x00, 0x00, 0x00, 0x00, 0x00, 0x00, 0x00, 0x00,
0x03, 0xC0, 0x00, 0x00, 0x00, 0x00, 0x00, 0x00, 0x00, 0x00, 0x00, 0x00, 0x00, 0x00, 0x00, 0x00,
0x07, 0xE0, 0x00, 0x00, 0x00, 0x00, 0x00, 0x00, 0x00, 0x00, 0x00, 0x00, 0x00, 0x00, 0x00, 0x00,
0x0F, 0xF0, 0x00, 0x00, 0x00, 0x00, 0x00, 0x00, 0x00, 0x00, 0x00, 0x00, 0x00, 0x00, 0x00, 0x00,
0x0B, 0xF0, 0x00, 0x00, 0x00, 0x00, 0x00, 0x00, 0x00, 0x00, 0x00, 0x00, 0x00, 0x00, 0x00, 0x00,
0x0B, 0xF0, 0x00, 0x00, 0x00, 0x00, 0x00, 0x00, 0x00, 0x00, 0x00, 0x00, 0x00, 0x00, 0x00, 0x00,
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
};



void vLcdDataWrite(uint8_t ui8Value)
{   
   
    DB_0_Write(LOW);
    DB_1_Write(LOW);
    DB_2_Write(LOW);
    DB_3_Write(LOW);
    DB_4_Write(LOW);
    DB_5_Write(LOW);
    DB_6_Write(LOW);
    DB_7_Write(LOW);

		if(ui8Value & 0x01)
			DB_0_Write(HIGH);
		if(ui8Value & 0x02)
			DB_1_Write(HIGH);
		if(ui8Value & 0x04)
			DB_2_Write(HIGH);
		if(ui8Value & 0x08)
			DB_3_Write(HIGH);
		if(ui8Value & 0x10)
			DB_4_Write(HIGH);
		if(ui8Value & 0x20)
			DB_5_Write(HIGH);
		if(ui8Value & 0x40)
			DB_6_Write(HIGH);
		if(ui8Value & 0x80)
			DB_7_Write(HIGH);
           
}

uint8 vLcdDataRead()
{   
   uint8 val;
    val=0;

		if(DB_0_Read())
            val+=1;
        if(DB_1_Read())
            val+=2;
        if(DB_2_Read())
            val+=4;
        if(DB_3_Read())
            val+=8;
        if(DB_4_Read())
            val+=16;
        if(DB_5_Read())
            val+=32;
        if(DB_6_Read())
            val+=64;
        if(DB_7_Read())
            val+=128;
        return val;
}

void glcd_writeByte(short side, uint8 data)
{
   if(side){                   // Choose which side to write to
      LCD_CHIP_SELECT_2();
   }else{
      LCD_CHIP_SELECT_1();
    }

   //output_low(GLCD_RW);       // Set for writing
    R_W_Write(0);
   vLcdDataWrite(data);            // Put the data on the port
   CyDelayCycles(100);
   //output_high(GLCD_E);       // Pulse the enable pin
    ENABLE_HIGH();
   CyDelayCycles(500);
   ENABLE_LOW();

   LCD_CHIP_DESELECT_1();
   LCD_CHIP_DESELECT_2();
}

void glcd_update()
{
   uint8 i, j;
   uint8 *p1, *p2;

   p1 = displayData.left;
   p2 = displayData.right;

   // Loop through the vertical pages
   for(i = 0; i < 8; ++i)
   {
      //output_low(GLCD_DI);                      // Set for instruction
      D_I_Write(0);
      //glcd_writeByte(GLCD_LEFT, 0x40);          // Set horizontal address to 0
      glcd_writeByte(GLCD_LEFT, 0x40);          // Set horizontal address to 0
      glcd_writeByte(GLCD_RIGHT, 0x40);
      glcd_writeByte(GLCD_LEFT, i | 0xB8);      // Set page address
      glcd_writeByte(GLCD_RIGHT, i | 0xB8);
      D_I_Write(1);

      // Loop through the horizontal sections
      for(j = 0; j < 64; ++j)
      {
         glcd_writeByte(GLCD_LEFT, *p1++);      // Turn pixels on or off
         glcd_writeByte(GLCD_RIGHT, *p2++);     // Turn pixels on or off
      }
   }
}

uint8 glcd_readByte(short side)
{
   uint8 data;                 // Stores the data read from the LCD

   //set_tris_d(0xFF);          // Set port d to input
   //output_high(GLCD_RW);      // Set for reading
    R_W_Write(1);

   if(side){                   // Choose which side to write to
      LCD_CHIP_SELECT_2();
   }else{
      LCD_CHIP_SELECT_1();
    }

   CyDelayCycles(100);
   //output_high(GLCD_E);       // Pulse the enable pin
    ENABLE_HIGH();
   CyDelayCycles(400);
   data = vLcdDataRead();          // Get the data from the display's output register
   //output_low(GLCD_E);
    ENABLE_LOW();

   LCD_CHIP_DESELECT_1();
   LCD_CHIP_DESELECT_2();
   return data;               // Return the read data
}

void glcd_fillScreen(short color)
{
   uint8  data;
   uint8  *p1, *p2;
   uint16 i;

   p1 = displayData.left;
   p2 = displayData.right;
   data = 0xFF * color;

   for(i=0; i<512; ++i)
   {
      *p1++ = data;
      *p2++ = data;
   }
   
}

void glcd_init(short mode)
{
   // Initialze some pins
   //output_high(GLCD_RST);
    RESET_Write(1);
   ENABLE_Write(0);
   LCD_CHIP_DESELECT_1();
   LCD_CHIP_DESELECT_2();

   D_I_Write(0);
   glcd_writeByte(GLCD_LEFT,  0xC0);    // Specify first RAM line at the top
   glcd_writeByte(GLCD_RIGHT, 0xC0);    //   of the screen
   glcd_writeByte(GLCD_LEFT,  0x40);    // Set the column address to 0
   glcd_writeByte(GLCD_RIGHT, 0x40);
   glcd_writeByte(GLCD_LEFT,  0xB8);    // Set the page address to 0
   glcd_writeByte(GLCD_RIGHT, 0xB8);

   if(mode == ON)
   {
      glcd_writeByte(GLCD_LEFT,  0x3F); // Turn the display on
      glcd_writeByte(GLCD_RIGHT, 0x3F);
   }
   else
   {
      glcd_writeByte(GLCD_LEFT,  0x3E); // Turn the display off
      glcd_writeByte(GLCD_RIGHT, 0x3E);
   }

   glcd_fillScreen(OFF);                // Clear the display
   glcd_update();
}

void glcd_pixel(uint8 x, uint8 y, short color)
{
    
   uint8* p;
   uint16 temp;
   temp =  y/8;
   temp *= 64;
   temp += x;

   if(x > 63)
   {
      p = displayData.right + temp - 64;
   }
   else
   {
      p = displayData.left + temp;
   }

   if(color)
   {
      bitSet(*p, y%8);
   }
   else
   {
      bitClear(*p, y%8);
   }
    
}

void glcd_line(uint8 x1, uint8 y1, uint8 x2, uint8 y2, short color)
{
   uint16        dy, dx;
   uint8  addx=1, addy=1;
   int16 P, diff;

   uint8 i=0;
   dx = x2 - x1;
   dy = y2 - y1;

   if(x1 > x2)
      addx = -1;
   if(y1 > y2)
      addy = -1;

   if(dx >= dy)
   {
      dy *= 2;
      P = dy - dx;
      diff = P - dx;

      for(; i<=dx; ++i)
      {
         glcd_pixel(x1, y1, color);

         if(P < 0)
         {
            P  += dy;
            x1 += addx;
         }
         else
         {
            P  += diff;
            x1 += addx;
            y1 += addy;
         }
      }
   }
   else
   {
      dx *= 2;
      P = dx - dy;
      diff = P - dy;

      for(; i<=dy; ++i)
      {
         glcd_pixel(x1, y1, color);

         if(P < 0)
         {
            P  += dx;
            y1 += addy;
         }
         else
         {
            P  += diff;
            x1 += addx;
            y1 += addy;
         }
      }
   }
}

void glcd_rect(uint8 x1, uint8 y1, uint8 x2, uint8 y2, short fill, short color)
{
   if(fill)
   {
      uint8  i, xmin, xmax, ymin, ymax;      

      if(x1 < x2)                            //  Find x min and max
      {
         xmin = x1;
         xmax = x2;
      }
      else
      {
         xmin = x2;
         xmax = x1;
      }

      if(y1 < y2)                            // Find the y min and max
      {
         ymin = y1;
         ymax = y2;
      }
      else
      {
         ymin = y2;
         ymax = y1;
      }

      for(; xmin <= xmax; ++xmin)
      {
         for(i=ymin; i<=ymax; ++i)
         {
            glcd_pixel(xmin, i, color);
         }
      }
   }
   else
   {
      glcd_line(x1, y1, x2, y1, color);      // Draw the 4 sides
      glcd_line(x1, y2, x2, y2, color);
      glcd_line(x1, y1, x1, y2, color);
      glcd_line(x2, y1, x2, y2, color);
   }
}

void glcd_bar(uint8 x1, uint8 y1, uint8 x2, uint8 y2, uint8 width, short color)
{
   uint8         half_width;
   uint16 dy, dx;
   uint8  addx=1, addy=1, j;
   uint16 P, diff, c1, c2;

   uint8 i=0;
   dx = (x2 - x1);
   dy = (y2 - y1);


   half_width = width/2;
   c1 = -(dx*x1 + dy*y1);
   c2 = -(dx*x2 + dy*y2);

   if(x1 > x2)
   {
      uint16 temp;
      temp = c1;
      c1 = c2;
      c2 = temp;
      addx = -1;
   }
   if(y1 > y2)
   {
      uint16 temp;
      temp = c1;
      c1 = c2;
      c2 = temp;
      addy = -1;
   }

   if(dx >= dy)
   {
      P = 2*dy - dx;
      diff = P - dx;

      for(i=0; i<=dx; ++i)
      {
         for(j=-half_width; j<half_width+width%2; ++j)
         {
            uint8 temp;            

            temp = dx*x1+dy*(y1+j);    // Use more RAM to increase speed
            if(temp+c1 >= 0 && temp+c2 <=0)
               glcd_pixel(x1, y1+j, color);
         }
         if(P < 0)
         {
            P  += 2*dy;
            x1 += addx;
         }
         else
         {
            P  += diff;
            x1 += addx;
            y1 += addy;
         }
      }
   }
   else
   {
      P = 2*dx - dy;
      diff = P - dy;

      for(i=0; i<=dy; ++i)
      {
         if(P < 0)
         {
            P  += 2*dx;
            y1 += addy;
         }
         else
         {
            P  += diff;
            x1 += addx;
            y1 += addy;
         }
         for(j=-half_width; j<half_width+width%2; ++j)
         {
            uint8 temp;            

            temp = dx*x1+dy*(y1+j);    // Use more RAM to increase speed
            if(temp+c1 >= 0 && temp+c2 <=0)
               glcd_pixel(x1+j, y1, color);
         }
      }
   }
}

void glcd_circle(uint8 x, uint8 y, uint8 radius, short fill, short color)
{
   uint8  a, b, P;

   a = 0;
   b = radius;
   P = 1 - radius;

   do
   {
      if(fill)
      {
         glcd_line(x-a, y+b, x+a, y+b, color);
         glcd_line(x-a, y-b, x+a, y-b, color);
         glcd_line(x-b, y+a, x+b, y+a, color);
         glcd_line(x-b, y-a, x+b, y-a, color);
      }
      else
      {
         glcd_pixel(a+x, b+y, color);
         glcd_pixel(b+x, a+y, color);
         glcd_pixel(x-a, b+y, color);
         glcd_pixel(x-b, a+y, color);
         glcd_pixel(b+x, y-a, color);
         glcd_pixel(a+x, y-b, color);
         glcd_pixel(x-a, y-b, color);
         glcd_pixel(x-b, y-a, color);
      }

      if(P < 0)
         P += 3 + 2 * a++;
      else
         P += 5 + 2 * (a++ - b--);
    } while(a <= b);
}

void glcd_text57(uint8 x, uint8 y, char* textptr, uint8 size, short color)
{
   uint8 j, k, l, m;                       // Loop counters
   uint8 pixelData[5];                     // Stores character data

   for(; *textptr != '\0'; ++textptr, ++x)// Loop through the passed string
   {
      if(*textptr < 'S') // Checks if the letter is in the first font array
         memcpy(pixelData, FONT[*textptr - ' '], 5);
      else if(*textptr <= '~') // Check if the letter is in the second font array
         memcpy(pixelData, FONT2[*textptr - 'S'], 5);
      else
         memcpy(pixelData, FONT[0], 5);   // Default to space

      // Handles newline and carriage returns
      switch(*textptr)
      {
         case '\n':
            y += 7*size + 1;
            continue;
         case '\r':
            x = 0;
            continue;
      }

      if(x+5*size >= GLCD_WIDTH)          // Performs character wrapping
      {
         x = 0;                           // Set x at far left position
         y += 7*size + 1;                 // Set y at next position down
      }
      for(j=0; j<5; ++j, x+=size)         // Loop through character byte data
      {
         for(k=0; k < 7; ++k)             // Loop through the vertical pixels
         {
            if(bitRead(pixelData[j], k)) // Check if the pixel should be set
            {
               for(l=0; l < size; ++l)    // These two loops change the
               {                          // character's size
                  for(m=0; m < size; ++m)
                  {
                     glcd_pixel(x+m, y+k*size+l, color); // Draws the pixel
                  }
               }
            }
         }
      }
   }
}

void displayMenu(char palabra[30], uint8 x, uint8 y, short sombreado, short tamano)
{
   strcpy(Menus.Letra,palabra);
   
   if(sombreado==3)
      {glcd_text57(x+1, y+1, Menus.Letra, tamano, OFF);}
   if(sombreado==2)
      {glcd_text57(x+1, y+1, Menus.Letra, tamano, ON);}
   if(sombreado==1)
      {glcd_rect(0, y, 127, y+(tamano*8), YES, ON);glcd_text57(x+1, y+1, Menus.Letra, tamano, OFF);}
   if(sombreado==0)
      {glcd_rect(0, y, 127, y+(tamano*8), YES, OFF);glcd_text57(x+1, y+1, Menus.Letra, tamano, ON);}
   glcd_update();
}

void displayTemps(char palabra[30], uint16 digito, uint8 x, uint8 y, short sombreado, short tamano)
{
   char voltage[9];
   
   if(sombreado==11)
   {
      sprintf(voltage, "%02u", digito);
      glcd_rect(0, y-2, 127, y+(tamano*8), YES, ON);
      strcpy(Menus.Letra,palabra);
      glcd_text57(x+90, y+1, voltage, tamano, OFF);
      glcd_text57(x+1, y+1, Menus.Letra, tamano, OFF);
   }
   if(sombreado==10)
   {
      sprintf(voltage, "%02u", digito);
      glcd_rect(0, y-2, 127, y+(tamano*8), YES, OFF);
      strcpy(Menus.Letra,palabra);
      glcd_text57(x+90, y+1, voltage, tamano, ON);
      glcd_text57(x+1, y+1, Menus.Letra, tamano, ON);
   }
   
   if(sombreado==1)
   {
      sprintf(voltage, "%04u", digito);
      glcd_rect(0, y-2, 127, y+(tamano*8), YES, ON);
      strcpy(Menus.Letra,palabra);
      glcd_text57(x+90, y+1, voltage, tamano, OFF);
      glcd_text57(x+1, y+1, Menus.Letra, tamano, OFF);
      strcpy(Menus.Letra,"C");
      glcd_text57(x+120, y+1, Menus.Letra, tamano, OFF);
      glcd_circle(x+115,y-1,1,NO,OFF);
   }
   if(sombreado==0)
   {
      sprintf(voltage, "%04u", digito);
      glcd_rect(0, y-2, 127, y+(tamano*8), YES, OFF);
      strcpy(Menus.Letra,palabra);
      glcd_text57(x+90, y+1, voltage, tamano, ON);
      glcd_text57(x+1, y+1, Menus.Letra, tamano, ON);
      strcpy(Menus.Letra,"C");
      glcd_text57(x+120, y+1, Menus.Letra, tamano, ON);
      glcd_circle(x+115,y-1,1,NO,ON);
   }
   glcd_update();
}

void displayTiempo(uint8 digito, uint8 x, uint8 y, short sombreado, short tamano)
{
   char voltage[9];
   
   if(sombreado==2)
   {
      sprintf(voltage, "%03u", digito);
      glcd_rect(x, y, x+(tamano*18), y+(tamano*8), YES, ON);
      glcd_text57(x+1, y+1, voltage, tamano, OFF);
   }
   else
   {
      if(sombreado==3)
      {
         sprintf(voltage, "%03u", digito);
         glcd_rect(x, y, x+(tamano*18), y+(tamano*8), YES, OFF);
         glcd_text57(x+1, y+1, voltage, tamano, ON);
      }
      sprintf(voltage, "%u", digito);
      if(sombreado==1)
         {glcd_rect(x, y, x+(tamano*5), y+(tamano*8), YES, ON);glcd_text57(x+1, y+1, voltage, tamano, OFF);}
      if(sombreado==0)
         {glcd_rect(x, y, x+(tamano*5), y+(tamano*8), YES, OFF);glcd_text57(x+1, y+1, voltage, tamano, ON);}
   }
   glcd_update();
}

void displayTemperatura(int16 digito, uint8 x, uint8 y, short sombreado, short tamano)
{
   char voltage[9];
   
   if(sombreado==2)
   {
      sprintf(voltage, "%04u", digito);
      glcd_rect(x, y, x+(tamano*18), y+(tamano*8), YES, ON);
      glcd_text57(x+1, y+1, voltage, tamano, OFF);
   }
   else
   {
      sprintf(voltage, "%04u", digito);
   
      if(sombreado==4)
      {
         glcd_rect(x, y, x+(tamano*16), y+(tamano*8), YES, OFF);
         glcd_text57(x+1, y+1, voltage, tamano, ON);
      }
      if(sombreado==1)
         {glcd_rect(x, y, x+(tamano*5), y+(tamano*8), YES, ON);glcd_text57(x+1, y+1, voltage, tamano, OFF);}
      if(sombreado==0)
         {glcd_rect(x, y, x+(tamano*5), y+(tamano*8), YES, OFF);glcd_text57(x+1, y+1, voltage, tamano, ON);}
   }
   glcd_update();
}

void glcd_imagen(uint8 x)
{
   char i,j;
   signed char k; 
   
   if(x==5){
   for( i = 0 ; i < 64 ; i ++ )
   {  
      for( j = 0 ; j < 16 ; j ++)
      {    
         for(k=7;k>-1;k--)
         {      
            if( bitRead(Horno[i][j] ,7-k )) 
               glcd_pixel( j*8+k,i, ON );
         }  
      }
   }
   }
    glcd_update();   
}
   
void Limpia(uint8 x1,uint8 x2,uint8 y){
   glcd_rect(x1, y, x2, y+7, YES, OFF);
}

void displayT(uint16 adc,uint8 x,uint8 y,uint8 w) {
   char voltage[9];    
   sprintf(voltage, "%04u",adc); // Converts adc to text
   glcd_rect(x, y, x+(w*27), y+(w*8), YES, OFF);
   glcd_text57(x, y, voltage, w, ON);
}

void displayFloat(float adc,uint8 x,uint8 y,uint8 w) {
   char voltage[9];    
   sprintf(voltage, "%03.2f",adc); // Converts adc to text
   glcd_rect(x, y, x+(w*27), y+(w*8), YES, OFF);
   glcd_text57(x, y, voltage, w, ON);
}

void displayContrasena(uint8 digito, uint8 x, uint8 y, uint8 sombreado)
{
   char voltage[9];
   sprintf(voltage, "%i", digito);
   
   if(sombreado==1)
      {glcd_rect(x, y, x+18, y+24, YES, ON);glcd_text57(x+2, y+1, voltage, 2, OFF);}
   else   
      {glcd_rect(x, y, x+18, y+24, NO, OFF);glcd_text57(x+2, y+1, voltage, 2, ON);}

}

void displayTiempos(uint8 digito, uint8 x, uint8 y, uint8 sombreado, uint8 tamano)
{
   char voltage[9];
   
   if(sombreado==2)
   {
      sprintf(voltage, "%02d", digito);
      glcd_rect(x, y, x+(tamano*12), y+(tamano*8), YES, OFF);
      glcd_text57(x+1, y+1, voltage, tamano, ON);
   }
   else
   {
      if(sombreado==3)
      {
         sprintf(voltage, "%03u", digito);
         glcd_rect(x, y, x+(tamano*18), y+(tamano*8), YES, OFF);
         glcd_text57(x+1, y+1, voltage, tamano, ON);
      }
      sprintf(voltage, "%u", digito);
      if(sombreado==1)
         {glcd_rect(x, y, x+(tamano*5), y+(tamano*8), YES, ON);glcd_text57(x+1, y+1, voltage, tamano, OFF);}
      if(sombreado==0)
         {glcd_rect(x, y, x+(tamano*5), y+(tamano*8), YES, OFF);glcd_text57(x+1, y+1, voltage, tamano, ON);}
   }
   glcd_update();
}
