judapies/Mufla/2019/Mufla 9L Artilab #004588000 OP2019109/Firmware Ajustado/DS1302.C

//////////////////////////////////////////////////////////////////////////
////                               DS1302.C                           ////
////                     Driver for Real Time Clock                   ////
////                                                                  ////
////  rtc_init()                                   Call after power up////
////                                                                  ////
////  rtc_set_datetime(day,mth,year,dow,hour,min)  Set the date/time  ////
////                                                                  ////
////  rtc_get_date(day,mth,year,dow)               Get the date       ////
////                                                                  ////
////  rtc_get_time(hr,min,sec)                     Get the time       ////
////                                                                  ////
////  rtc_write_nvr(address,data)                  Write to NVR       ////
////                                                                  ////
////  data = rtc_read_nvr(address)                 Read from NVR      ////
////                                                                  ////
////  get_bcd(data)                              Convert data to BCD  ////
////                                                                  ////
////  rm_bcd(data)                               Convert data to int  ////
////                                                                  ////
//////////////////////////////////////////////////////////////////////////
////        (C) Copyright 1996,2003 Custom Computer Services          ////
//// This source code may only be used by licensed users of the CCS C ////
//// compiler.  This source code may only be distributed to other     ////
//// licensed users of the CCS C compiler.  No other use, reproduction////
//// or distribution is permitted without written permission.         ////
//// Derivative programs created using this software in object code   ////
//// form are not restricted in any way.                              ////
//////////////////////////////////////////////////////////////////////////

//#ifndef RTC_SCLK

#define RTC_SCLK PIN_C3
#define RTC_IO   PIN_C2
#define RTC_RST  PIN_C1

//#endif

void write_ds1302_byte(BYTE cmd) {
   BYTE i;

   for(i=0;i<=7;++i) {
      output_bit(RTC_IO, shift_right(&cmd,1,0) );
      output_high(RTC_SCLK);
      output_low(RTC_SCLK);
   }
}

void write_ds1302(BYTE cmd, BYTE data) {

   output_high(RTC_RST);
   write_ds1302_byte(cmd);
   write_ds1302_byte(data);
   output_low(RTC_RST);
}

BYTE read_ds1302(BYTE cmd) {
   BYTE i,data;

   output_high(RTC_RST);
   write_ds1302_byte(cmd);
   
   input(RTC_IO);
   delay_us(10);
         
   for(i=0;i<=7;++i) {
      shift_right(&data,1,input(RTC_IO));
      output_high(RTC_SCLK);
      delay_us(20);
      output_low(RTC_SCLK);
      delay_us(20);
   }
   output_low(RTC_RST);

   return(data);
}
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
